benheck/gamebadge3/assets/bud_cu.bmp

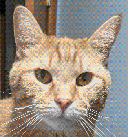
assets/bud_cu.bmp
