benheck/gamebadge3/code/Sample Games/Catskill Game Assets/title screens/cat-teeth.jpg

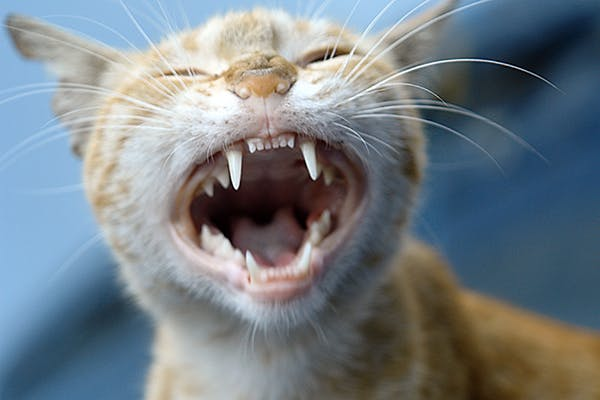
code/Sample Games/Catskill Game Assets/title screens/cat-teeth.jpg
