benheck/gamebadge3/README.md

gamebadge 3 Midwest Gaming Classic workshop project

Some existing Catskill games may not be able to save without a /save folder in the MSD USB root directory, add a "save" folder to enable.

Build procedure:
https://www.youtube.com/watch?v=VSEMkjyJ5Pk
