benheck/gamebadge3/PCB 2026/README.txt

Slight changes based on the 2023 workshop experience
Plan is to have PCBway make these and populate the boring stuff

Have class do audio amp, tact, through hole and PICO
