benheck/gamebadge3/code/Sample Games/Catskill Game Assets/READ ME.txt

Copy the contents of the _flash MSD contents folder to the Pico USB "thumb drive"

See the README.TXT in that folder for more details
