benheck/gamebadge3/code/Sample Games/Catskill Game Assets/_flash MSD contents/READ ME.txt

This folder contains the files/folders that should be placed in the root directory of the Pi Pico's USB "EXT FLASH" when connected to a PC.

Copy the contents of this folder (not the folder itself) into the root directory of the Pi Pico. There should be 10 items in the root of the Pico (9 folders and this README.TXT file)

These files are for the "Catskillvania" game

NES - pattern tables (tiles and sprites)
PAL - RGB palettes that define what colors you can select from
DAT - Palette data
