benheck/gamebadge3/assets/moon force tiles export.bmp

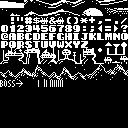
assets/moon force tiles export.bmp
