benheck/gamebadge3/assets/moon force tiles.bmp

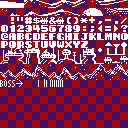
assets/moon force tiles.bmp
