benheck/gamebadge3/code/Sample Games/Catskill Game Assets/condo/condo_0.bmp

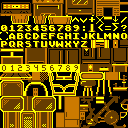
code/Sample Games/Catskill Game Assets/condo/condo_0.bmp
