benheck/gamebadge3/code/Sample Games/Catskill Game Assets/condo/condo_tiles.bmp

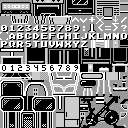
code/Sample Games/Catskill Game Assets/condo/condo_tiles.bmp
