benheck/gamebadge3/code/Sample Games/Catskill Game Assets/condo/condo_tiles_1.bmp

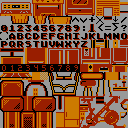
code/Sample Games/Catskill Game Assets/condo/condo_tiles_1.bmp
