benheck/gamebadge3/code/Sample Games/Catskill Game Assets/NES/CHR000.bmp

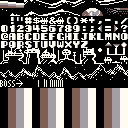
code/Sample Games/Catskill Game Assets/NES/CHR000.bmp
