benheck/gamebadge3/code/Sample Games/Catskill Game Assets/sprites/robots.bmp

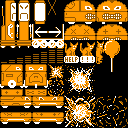
code/Sample Games/Catskill Game Assets/sprites/robots.bmp
