benheck/gamebadge3/code/Sample Games/Catskill Game Assets/sprites/robots.png

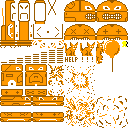
code/Sample Games/Catskill Game Assets/sprites/robots.png
