benheck/gamebadge3/code/Sample Games/Catskill Game Assets/story/bud face.bmp

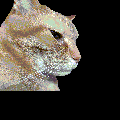
code/Sample Games/Catskill Game Assets/story/bud face.bmp
