benheck/gamebadge3/code/Sample Games/Catskill Game Assets/title screens/CatskillVania Title.bmp

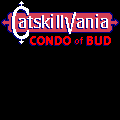
code/Sample Games/Catskill Game Assets/title screens/CatskillVania Title.bmp
