benheck/gamebadge3/code/Sample Games/Catskill Game Assets/title screens/faces.bmp

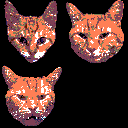
code/Sample Games/Catskill Game Assets/title screens/faces.bmp
