benheck/gamebadge3/code/Sample Games/Grevious/art/grevious-title.png

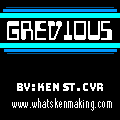
code/Sample Games/Grevious/art/grevious-title.png
