benheck/gamebadge3/code/Sample Games/Grevious/grevious-tileset.bmp

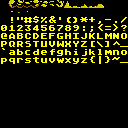
code/Sample Games/Grevious/grevious-tileset.bmp
