benheck/gamebadge3/docs datasheets/power in zMzT6.png

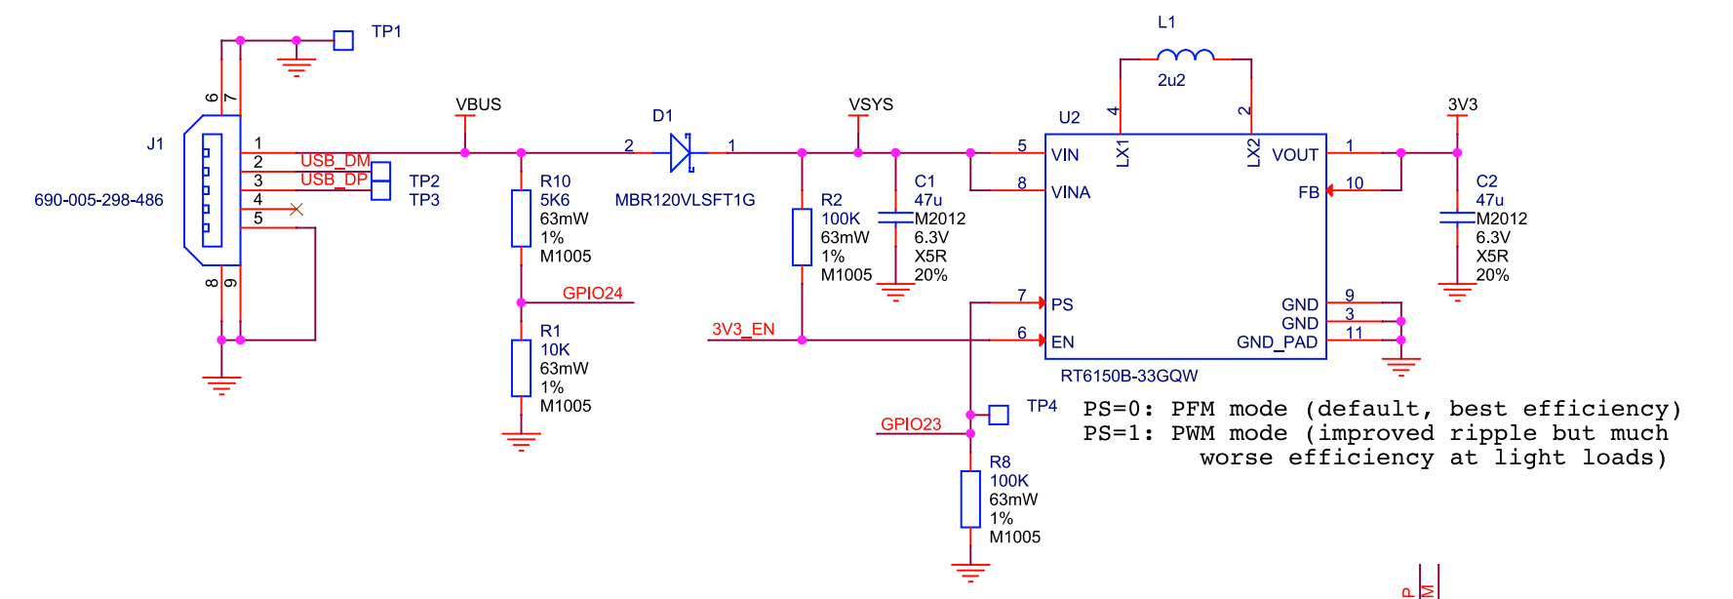
docs datasheets/power in zMzT6.png
