benheck/gamebadge3/PCB 2026/parts lists/Gamebadge3_revB PARTS LIST.txt

Partlist exported from C:/Users/ben/Documents/GitHub/gamebadge3/PCB/Eagle 8.7.1 files/Gamebadge3_revB.sch at 4/4/2023 8:10 PM

Part     Value                 Device                Package                  Description                                                    AVAILABILITY COMMENT   CUI_PURCHASE_URL                                                                                                                            DESCRIPTION                                                                                        EU_ROHS_COMPLIANCE MF                    MP                    PACKAGE             PRICE PURCHASE-URL                                                          
/RST                           PINHD-1X1             1X01                     Pin header 1x1 for 0.1" spacing                                                                                                                                                                                                                                                                                                                                                                                                                                                                     
A        TS04-66-50-BK-100-SMT TS04-66-50-BK-100-SMT SW_TS04-66-50-BK-100-SMT Check availability                                             In Stock               https://www.cuidevices.com/product/switches/tactile-switches/ts04-series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  6 x 6 mm, 4.3~9.5 mm Actuator Height, 100~260 gf, Surface Mount, SPST, Tactile Switch                                CUI Devices           TS04-66-50-BK-100-SMT None                None  https://pricing.snapeda.com/search/part/TS04-66-50-BK-100-SMT/?ref=eda
B        TS04-66-50-BK-100-SMT TS04-66-50-BK-100-SMT SW_TS04-66-50-BK-100-SMT Check availability                                             In Stock               https://www.cuidevices.com/product/switches/tactile-switches/ts04-series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  6 x 6 mm, 4.3~9.5 mm Actuator Height, 100~260 gf, Surface Mount, SPST, Tactile Switch                                CUI Devices           TS04-66-50-BK-100-SMT None                None  https://pricing.snapeda.com/search/part/TS04-66-50-BK-100-SMT/?ref=eda
BATT+                          PINHD-1X1             1X01                     Pin header 1x1 for 0.1" spacing                                                                                                                                                                                                                                                                                                                                                                                                                                                                     
BATT-                          PINHD-1X1             1X01                     Pin header 1x1 for 0.1" spacing                                                                                                                                                                                                                                                                                                                                                                                                                                                                     
C        TS04-66-50-BK-100-SMT TS04-66-50-BK-100-SMT SW_TS04-66-50-BK-100-SMT Check availability                                             In Stock               https://www.cuidevices.com/product/switches/tactile-switches/ts04-series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  6 x 6 mm, 4.3~9.5 mm Actuator Height, 100~260 gf, Surface Mount, SPST, Tactile Switch                                CUI Devices           TS04-66-50-BK-100-SMT None                None  https://pricing.snapeda.com/search/part/TS04-66-50-BK-100-SMT/?ref=eda
C1       1uf                   C-USC0805             C0805                    CAPACITOR, American symbol                                                                                                                                                                                                                                                                                                                                                                                                                                                                          
C2       1uf                   C-USC0805             C0805                    CAPACITOR, American symbol                                                                                                                                                                                                                                                                                                                                                                                                                                                                          
C3       1uf                   C-USC0805             C0805                    CAPACITOR, American symbol                                                                                                                                                                                                                                                                                                                                                                                                                                                                          
C4       1uf                   C-USC0805             C0805                    CAPACITOR, American symbol                                                                                                                                                                                                                                                                                                                                                                                                                                                                          
C5       1uf                   C-USC0805             C0805                    CAPACITOR, American symbol                                                                                                                                                                                                                                                                                                                                                                                                                                                                          
C6       1uf                   C-USC0805             C0805                    CAPACITOR, American symbol                                                                                                                                                                                                                                                                                                                                                                                                                                                                          
C7       1uf                   C-USC0805             C0805                    CAPACITOR, American symbol                                                                                                                                                                                                                                                                                                                                                                                                                                                                          
C8       1uf                   C-USC0805             C0805                    CAPACITOR, American symbol                                                                                                                                                                                                                                                                                                                                                                                                                                                                          
C9       1uf                   C-USC0805             C0805                    CAPACITOR, American symbol                                                                                                                                                                                                                                                                                                                                                                                                                                                                          
DOWN     TS04-66-50-BK-100-SMT TS04-66-50-BK-100-SMT SW_TS04-66-50-BK-100-SMT Check availability                                             In Stock               https://www.cuidevices.com/product/switches/tactile-switches/ts04-series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  6 x 6 mm, 4.3~9.5 mm Actuator Height, 100~260 gf, Surface Mount, SPST, Tactile Switch                                CUI Devices           TS04-66-50-BK-100-SMT None                None  https://pricing.snapeda.com/search/part/TS04-66-50-BK-100-SMT/?ref=eda
GP28                           PINHD-1X1             1X01                     Pin header 1x1 for 0.1" spacing                                                                                                                                                                                                                                                                                                                                                                                                                                                                     
GPIO15                         PINHD-1X1             1X01                     Pin header 1x1 for 0.1" spacing                                                                                                                                                                                                                                                                                                                                                                                                                                                                     
IC1      AZ1117IH-3.3TRG1      AZ1117IH-3.3TRG1      SOT230P700X170-4N        LDO Voltage Regulators LDO BJT HiCurr 1.35A 10Hz to 10KHz      In Stock                                                                                                                                                            Linear Voltage Regulator IC Positive Fixed 1 Output 1A SOT-223-3                                                     Diodes Inc.           AZ1117IH-3.3TRG1      SOT-223 Diodes Inc. None  https://pricing.snapeda.com/search/part/AZ1117IH-3.3TRG1/?ref=eda     
LED1     CHRG                  LED3MM                LED3MM                   LED                                                                                                                                                                                                                                                                                                                                                                                                                                                                                                 
LED2     PWR                   LED3MM                LED3MM                   LED                                                                                                                                                                                                                                                                                                                                                                                                                                                                                                 
LEFT     TS04-66-50-BK-100-SMT TS04-66-50-BK-100-SMT SW_TS04-66-50-BK-100-SMT Check availability                                             In Stock               https://www.cuidevices.com/product/switches/tactile-switches/ts04-series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  6 x 6 mm, 4.3~9.5 mm Actuator Height, 100~260 gf, Surface Mount, SPST, Tactile Switch                                CUI Devices           TS04-66-50-BK-100-SMT None                None  https://pricing.snapeda.com/search/part/TS04-66-50-BK-100-SMT/?ref=eda
R1       2k                    R-US_R0805            R0805                    RESISTOR, American symbol                                                                                                                                                                                                                                                                                                                                                                                                                                                                           
R2       2k                    R-US_R0805            R0805                    RESISTOR, American symbol                                                                                                                                                                                                                                                                                                                                                                                                                                                                           
R3       2k                    R-US_R0805            R0805                    RESISTOR, American symbol                                                                                                                                                                                                                                                                                                                                                                                                                                                                           
R4       20k                   R-US_R0805            R0805                    RESISTOR, American symbol                                                                                                                                                                                                                                                                                                                                                                                                                                                                           
R5       20k                   R-US_R0805            R0805                    RESISTOR, American symbol                                                                                                                                                                                                                                                                                                                                                                                                                                                                           
R6       20k                   R-US_R0805            R0805                    RESISTOR, American symbol                                                                                                                                                                                                                                                                                                                                                                                                                                                                           
R7       2k                    R-US_R0805            R0805                    RESISTOR, American symbol                                                                                                                                                                                                                                                                                                                                                                                                                                                                           
R8       33k                   R-US_R0805            R0805                    RESISTOR, American symbol                                                                                                                                                                                                                                                                                                                                                                                                                                                                           
R9       33k                   R-US_R0805            R0805                    RESISTOR, American symbol                                                                                                                                                                                                                                                                                                                                                                                                                                                                           
R10      33k                   R-US_R0805            R0805                    RESISTOR, American symbol                                                                                                                                                                                                                                                                                                                                                                                                                                                                           
R11      33k                   R-US_R0805            R0805                    RESISTOR, American symbol                                                                                                                                                                                                                                                                                                                                                                                                                                                                           
RESET    TS04-66-50-BK-100-SMT TS04-66-50-BK-100-SMT SW_TS04-66-50-BK-100-SMT Check availability                                             In Stock               https://www.cuidevices.com/product/switches/tactile-switches/ts04-series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  6 x 6 mm, 4.3~9.5 mm Actuator Height, 100~260 gf, Surface Mount, SPST, Tactile Switch                                CUI Devices           TS04-66-50-BK-100-SMT None                None  https://pricing.snapeda.com/search/part/TS04-66-50-BK-100-SMT/?ref=eda
RIGHT    TS04-66-50-BK-100-SMT TS04-66-50-BK-100-SMT SW_TS04-66-50-BK-100-SMT Check availability                                             In Stock               https://www.cuidevices.com/product/switches/tactile-switches/ts04-series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  6 x 6 mm, 4.3~9.5 mm Actuator Height, 100~260 gf, Surface Mount, SPST, Tactile Switch                                CUI Devices           TS04-66-50-BK-100-SMT None                None  https://pricing.snapeda.com/search/part/TS04-66-50-BK-100-SMT/?ref=eda
SELECT   TS04-66-50-BK-100-SMT TS04-66-50-BK-100-SMT SW_TS04-66-50-BK-100-SMT Check availability                                             In Stock               https://www.cuidevices.com/product/switches/tactile-switches/ts04-series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  6 x 6 mm, 4.3~9.5 mm Actuator Height, 100~260 gf, Surface Mount, SPST, Tactile Switch                                CUI Devices           TS04-66-50-BK-100-SMT None                None  https://pricing.snapeda.com/search/part/TS04-66-50-BK-100-SMT/?ref=eda
SERIAL                         PINHD-1X4             1X04                     PIN HEADER                                                                                                                                                                                                                                                                                                                                                                                                                                                                                          
SPEAKER+                       PINHD-1X1             1X01                     Pin header 1x1 for 0.1" spacing                                                                                                                                                                                                                                                                                                                                                                                                                                                                     
SPEAKER-                       PINHD-1X1             1X01                     Pin header 1x1 for 0.1" spacing                                                                                                                                                                                                                                                                                                                                                                                                                                                                     
SPI                            PINHD-1X6             1X06                     PIN HEADER                                                                                                                                                                                                                                                                                                                                                                                                                                                                                          
START    TS04-66-50-BK-100-SMT TS04-66-50-BK-100-SMT SW_TS04-66-50-BK-100-SMT Check availability                                             In Stock               https://www.cuidevices.com/product/switches/tactile-switches/ts04-series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  6 x 6 mm, 4.3~9.5 mm Actuator Height, 100~260 gf, Surface Mount, SPST, Tactile Switch                                CUI Devices           TS04-66-50-BK-100-SMT None                None  https://pricing.snapeda.com/search/part/TS04-66-50-BK-100-SMT/?ref=eda
U$2      GND_CLIP              GND_CLIP              GND_CLIP                                                                                                                                                                                                                                                                                                                                                                                                                                                                                                                     
U$3      GND_CLIP              GND_CLIP              GND_CLIP                                                                                                                                                                                                                                                                                                                                                                                                                                                                                                                     
U$4      GND_CLIP              GND_CLIP              GND_CLIP                                                                                                                                                                                                                                                                                                                                                                                                                                                                                                                     
U$5      GND_CLIP              GND_CLIP              GND_CLIP                                                                                                                                                                                                                                                                                                                                                                                                                                                                                                                     
U$6      1825232-1             1825232-1             1825232-1                Check prices                                                   In Stock     1825232-1                                                                                                                                              Switch Slide ON None ON SPDT Side Slide 0.2A 30VDC 10000Cycle PC Pins Bracket Mount/Through Hole  Compliant          TE Connectivity       1825232-1             None                None  https://pricing.snapeda.com/search/part/1825232-1/?ref=eda            
U$7      ST7789_CS             ST7789_CS             ST7789_WAVE                                                                                                                                                                                                                                                                                                                                                                                                                                                                                                                  
U$8                            RPI_PICO_W            RPI_PICO_W                                                                                                                                                                                                                                                                                                                                                                                                                                                                                                                   
U1       MCP73832T-5ACI/OT     MCP73832T-5ACI/OT     SOT95P300X145-5N         IC, BATT CHARGER, Li-Ion Li-Polymer, 500 mA Check availability In Stock                                                                                                                                                            Charger IC Lithium Ion/Polymer SOT-23-5                                                                              Microchip             MCP73832T-5ACI/OT     SOT-23 Microchip    None  https://pricing.snapeda.com/search/part/MCP73832T-5ACI/OT/?ref=eda    
U2       IS31AP4991A-GRLS2-TR  IS31AP4991A-GRLS2-TR  SOIC127P604X170-8N       Ic Audio Pwr Amp 1.1w 8soic Check availability                 In Stock                                                                                                                                                            Audio Amp Speaker 1-CH Mono 1.4W Class-AB 8-Pin SOP T/R                                                              Lumissil Microsystems IS31AP4991A-GRLS2-TR  None                None  https://pricing.snapeda.com/search/part/IS31AP4991A-GRLS2-TR/?ref=eda 
UP       TS04-66-50-BK-100-SMT TS04-66-50-BK-100-SMT SW_TS04-66-50-BK-100-SMT Check availability                                             In Stock               https://www.cuidevices.com/product/switches/tactile-switches/ts04-series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  6 x 6 mm, 4.3~9.5 mm Actuator Height, 100~260 gf, Surface Mount, SPST, Tactile Switch                                CUI Devices           TS04-66-50-BK-100-SMT None                None  https://pricing.snapeda.com/search/part/TS04-66-50-BK-100-SMT/?ref=eda
