benheck/gamebadge3/PCB 2026/parts lists/MGC Game Badge 2024 - parts list.xlsx

 | MGC Game Badge 2024 |  | 2023-12-29 |  | BJH
GET | Part | PCBWAY POPULATE | Supplier | Supplier Part # | Part # | Qnty | Cost | Sub | Notes: | Notes: | Notes:
done | Pi Pico W |  | Digi-Key |  | 2648-SC0918CT-ND | 1 | $0.00 | $0.00 | Spooky donation
progress | ST7789 LCD |  | Amazon | Waveshare model - collect 40 |  | 1 | $13.27 | $13.27 | https://www.amazon.com/dp/B07MH93747?psc=1&ref=ppx_yo2ov_dt_b_product_details |  | https://www.amazon.com/dp/B07MH93747?psc=1&ref=ppx_yo2ov_dt_b_product_details
done | ACEIRMC Micro SD SDHC TF Card Adapter |  | Amazon |  |  | 1 | $0.88 | $0.88 | https://www.amazon.com/dp/B0B87QQZD3?psc=1&ref=ppx_yo2ov_dt_b_product_details
build? | 3mm M3 screw |  | McMaster |  | https://www.mcmaster.com/92005A111/ | 2 | $0.06 | $0.11
done | Red LED 3mm |  | MPJA.COM |  | 15101 OP | 1 | $0.02 | $0.02 | We already have these, but this is what they cost me
done | Green LED 3mm |  | MPJA.COM |  | 15102 OP | 1 | $0.02 | $0.02 | We already have these, but this is what they cost me
done | SWITCH SLIDE SPDT 200MA 30V |  | Digi-Key |  | ‎A107673-ND‎ | 1 | $0.41 | $0.41 | Same as gamebadge 2
PCBway | 20k resistors | YES |  |  | 738-RMCF0805JG20K0TR-ND | 3 | $0.00 | $0.00
PCBway | 33k resistors | YES |  |  | RMCF0805FT33K0CT-ND | 4 | $0.00 | $0.00
PCBway | 2k resistors | YES |  |  | 13-RC0805FR-132KLTR-ND | 4 | $0.00 | $0.00
 |  |  |  |  |  |  |  | $0.00
 |  |  |  |  |  |  |  | $0.00
done | IC AMP CLASS AB MONO 1.15W 8SOIC |  | Digi-Key |  | 2521-IS31AP4991A-GRLS2-TRCT-ND | 1 | $0.46 | $0.46
done | 8 Ohms General Purpose Speaker 800 mW 300 Hz ~ 8 kHz Top Round |  | Digi-Key |  | 433-1104-ND | 1 | $1.34 | $1.34 | 16mm diameter
done | 6mmx6mm SMT tact switch |  | Digi-Key |  | TS04-66-50-BK-100-SMT | 10 | $0.13 | $1.28 | 100gf switches. Use these for D-pad, use existing switches for other buttons
 |  |  |  |  |  |  |  | $0.00
PCBway | CAP CER 1UF 25V X7R 0805 | YES |  |  | 1276-2926-2-ND | 9 | $0.03 | $0.26
 |  |  |  |  |  |  |  | $0.00
PCBway | IC BATT CNTL LI-ION 1CEL SOT23-5 | YES | LCSC | C14879 | ‎MCP73832T-5ACI/OTCT-ND‎ | 1 | $0.00 | $0.00 | LCSC MCP73831T-2ATI/OT (lower voltage regulator) | Improve heat sinking
order | 3.3 voltage regulator AZ1117IH-3.3TRG1 |  | Digi-Key | AZ1117IH-3.3TRG1DICT-ND | AZ1117IH-3.3TRG1 | 1 | $0.21 | $0.21
order | Lipo battery 380mAH |  | Amazon |  |  | 1 | $3.00 | $3.00 | https://www.amazon.com/gp/product/B08DD5MTKM/ref=ppx_yo_dt_b_search_asin_title?ie=UTF8&psc=1
 |  |  |  |  |  |  |  | $0.00
PCBway | PCB |  | PCBWAY |  |  | 1 | $0.00 | $0.00 | PCBWAY SPONSORSHIP | https://jlcpcb.com/
 |  |  |  |  |  |  |  | $0.00
 |  |  |  |  |  |  |  | $0.00
