benheck/gamebadge3/casing/case 2023 v3/Screen Kit v1.stl

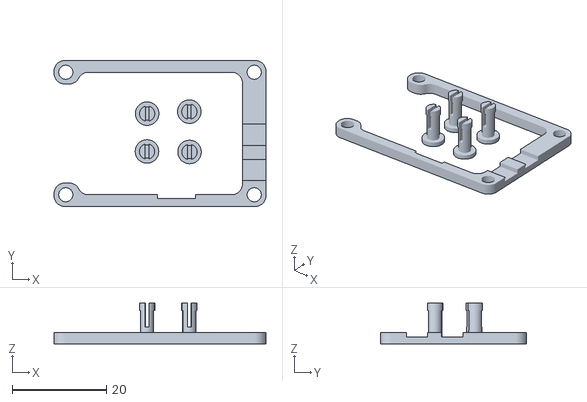
[picture p17: CAD file, 2023-04-05]
casing/case 2023 v3/Screen Kit v1.stl
45.0 x 31.0 x 8.60
