benheck/gamebadge3/casing/case 2023 v3A/Front Case Speaker Front 16mm.stl

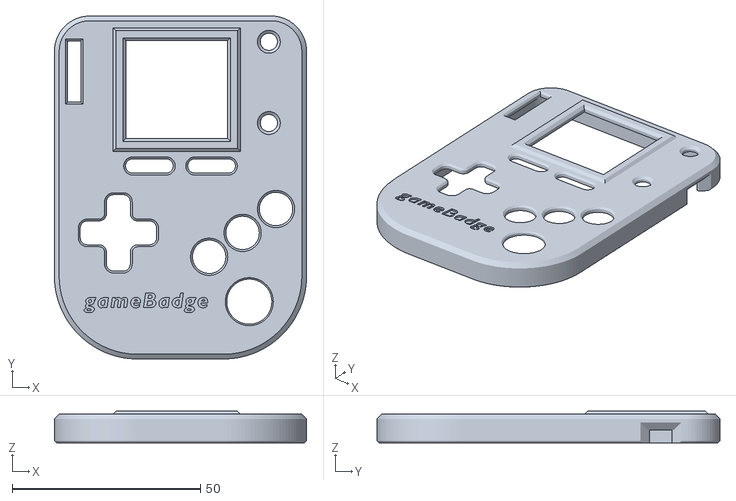
[picture p18: CAD file, 2023-08-27]
casing/case 2023 v3A/Front Case Speaker Front 16mm.stl
67.1 x 91.2 x 8.38
