benheck/gamebadge3/casing/casing 2024 rev 3B - alternate/Rear Case - Alternate.stl

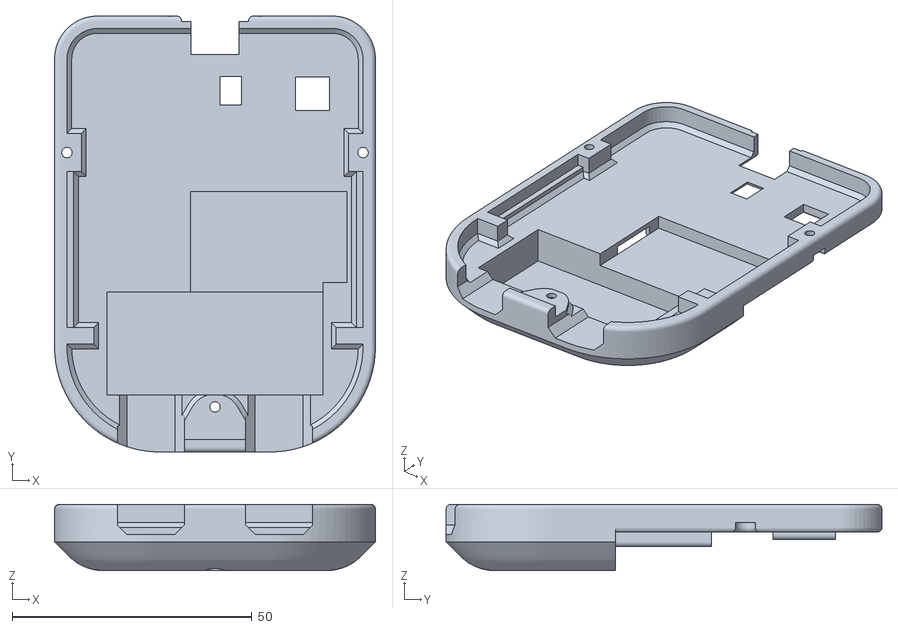
[picture p19: CAD file, 2024-04-05]
casing/casing 2024 rev 3B - alternate/Rear Case - Alternate.stl
67.0 x 91.0 x 13.8
