benheck/gamebadge3/casing/casing 2024 rev 3B/rear buttons.stl

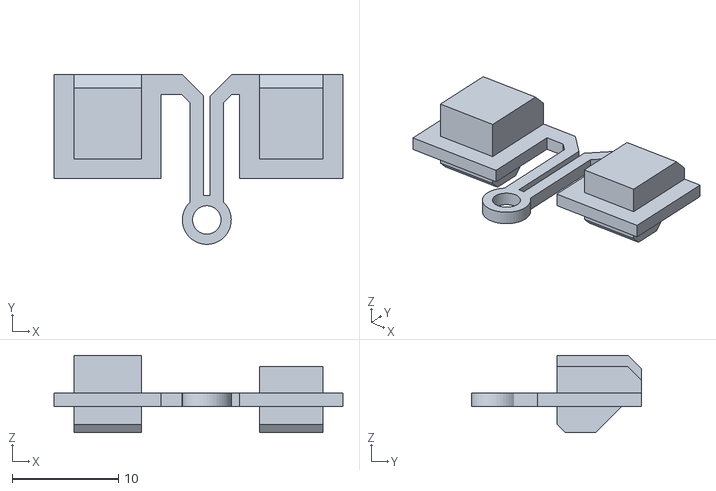
[picture p20: CAD file, 2024-02-28]
casing/casing 2024 rev 3B/rear buttons.stl
27.2 x 16.0 x 7.29
