benheck/gamebadge3/casing/casing 2025 rev 3C - ST7789V3/Gamebadge3_revC.dxf

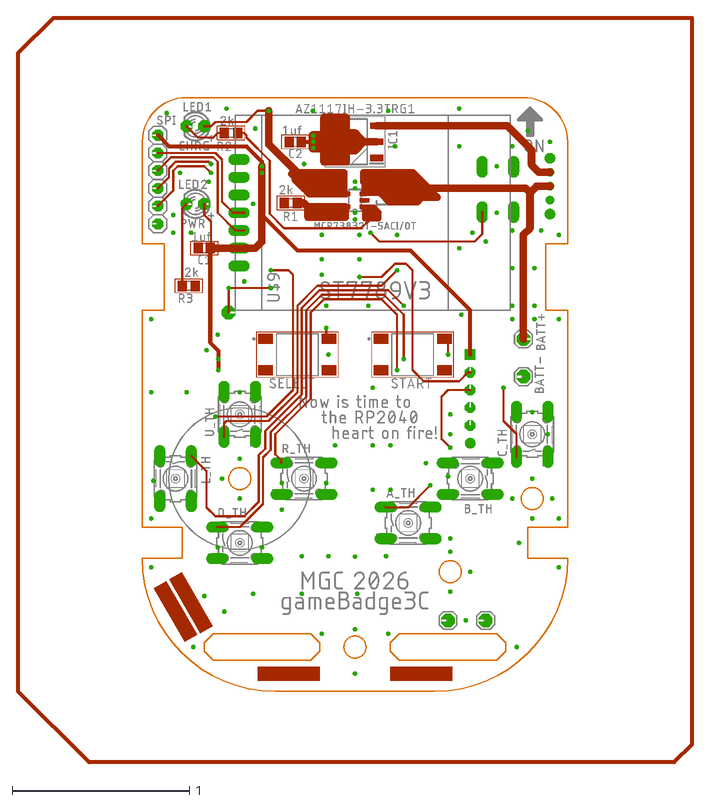
[picture p21: CAD file, 2025-12-30]
casing/casing 2025 rev 3C - ST7789V3/Gamebadge3_revC.dxf
3.82 x 4.22
