benheck/gamebadge3/casing/casing 2025 rev 3C - ST7789V3/STL/GameBadge 3C Screen Bracket.stl

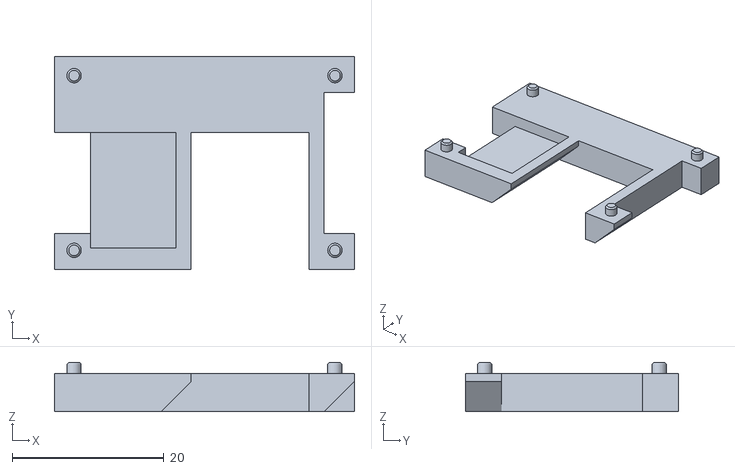
[picture p22: CAD file, 2026-03-24]
casing/casing 2025 rev 3C - ST7789V3/STL/GameBadge 3C Screen Bracket.stl
39.5 x 28.0 x 6.50
