benheck/gamebadge3/docs datasheets/documentation 3B assembly/Gamebadge3_revC rear.dxf

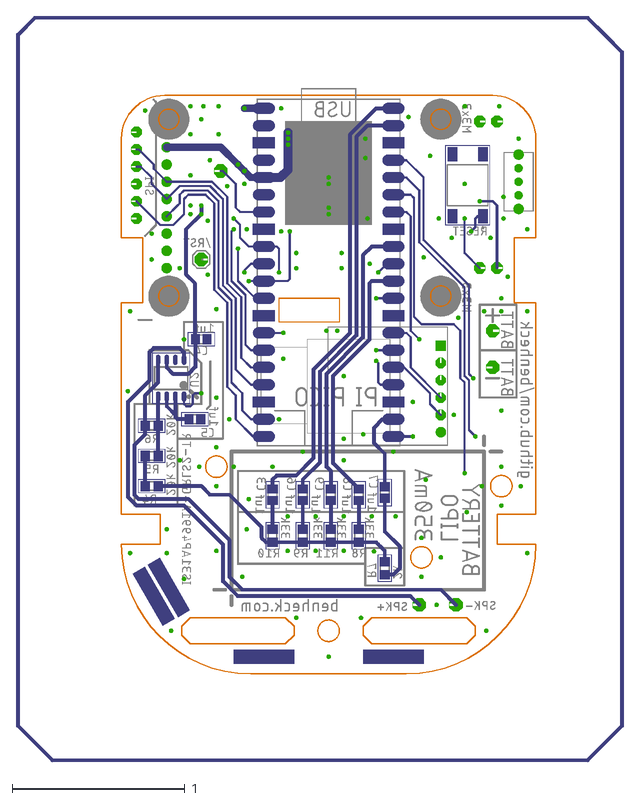
[picture p23: CAD file, 2024-04-05]
docs datasheets/documentation 3B assembly/Gamebadge3_revC rear.dxf
3.52 x 4.32
