benheck/gamebadge3/PCB 2026/diagrams/front.dxf

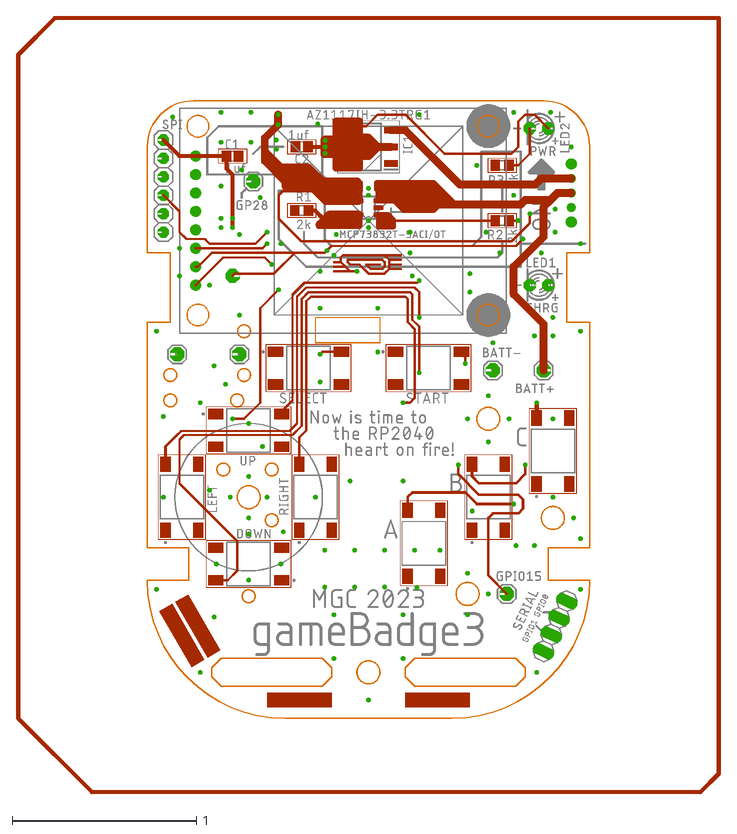
[picture p24: CAD file, 2023-03-27]
PCB 2026/diagrams/front.dxf
3.82 x 4.22
