benheck/gamebadge3/PCB 2026/Eagle 8.7.1 files/Gamebadge3_revD.dxf

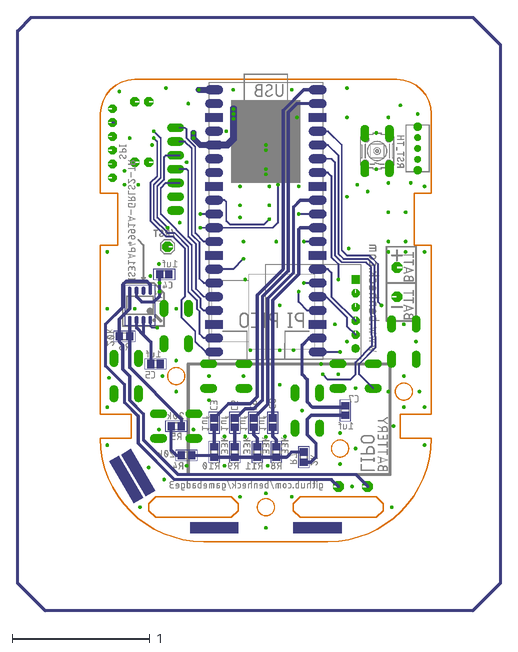
[picture p25: CAD file, 2026-09-08]
PCB 2026/Eagle 8.7.1 files/Gamebadge3_revD.dxf
3.52 x 4.32
