benheck/gamebadge3/casing/case 2023 v3/Buttons.stl

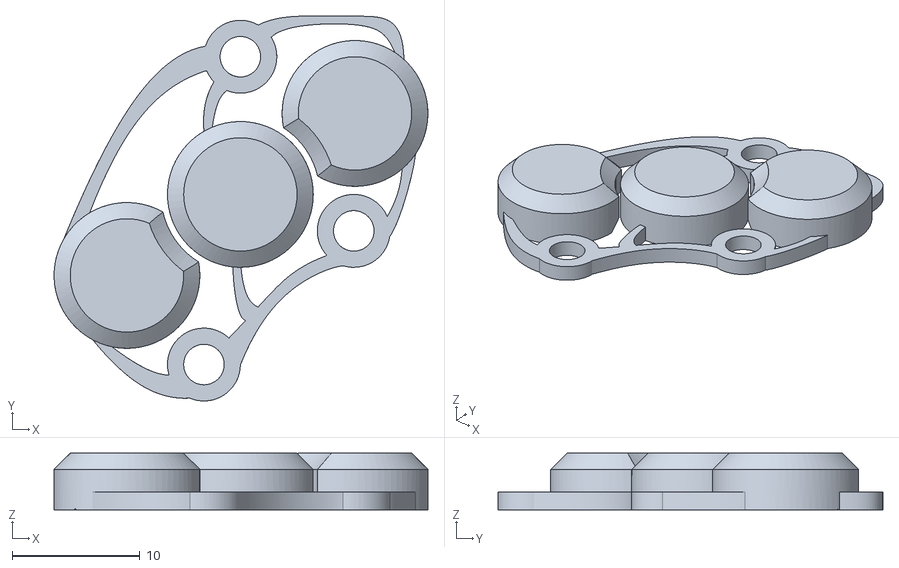
[picture p26: CAD file, 2023-04-05]
casing/case 2023 v3/Buttons.stl
29.3 x 30.2 x 4.45
