benheck/gamebadge3/casing/case 2023 v3A/Rear Case 2.stl

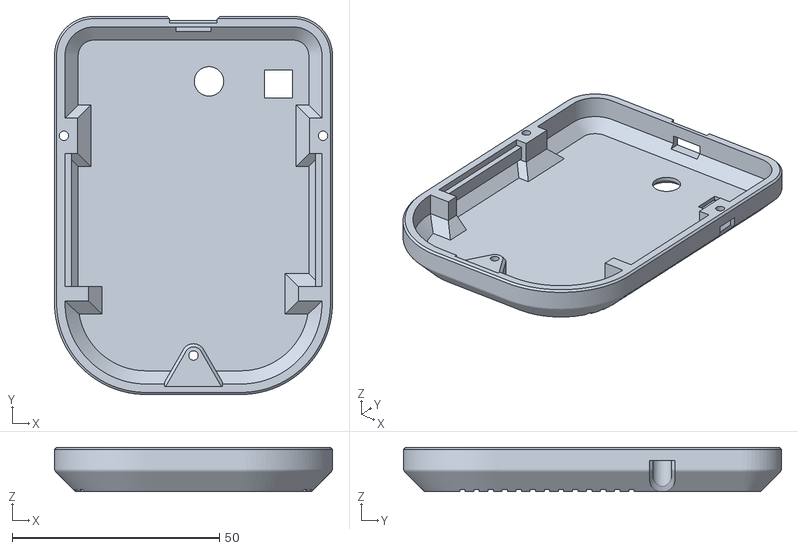
[picture p27: CAD file, 2023-08-12]
casing/case 2023 v3A/Rear Case 2.stl
67.1 x 91.2 x 10.7
