benheck/gamebadge3/casing/casing 2024 rev 3B/Buttons.stl

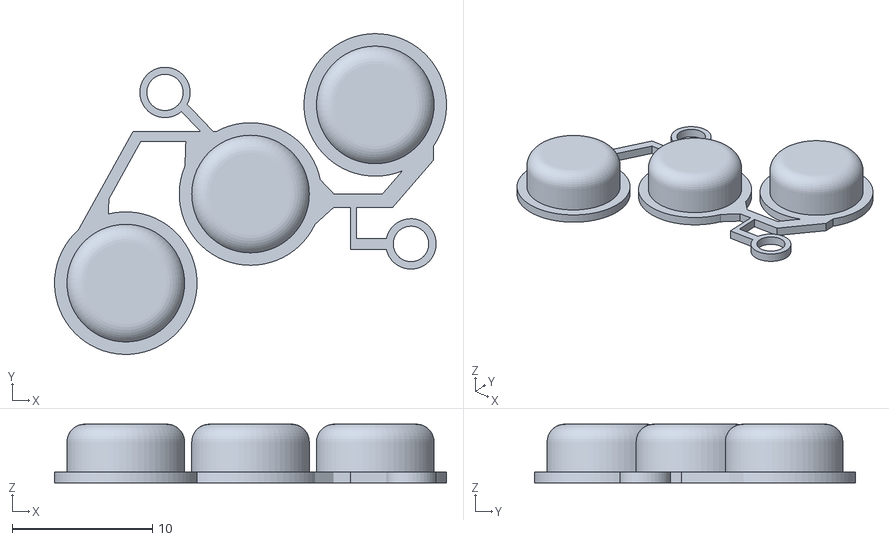
[picture p28: CAD file, 2024-02-28]
casing/casing 2024 rev 3B/Buttons.stl
27.9 x 22.9 x 4.19
