benheck/gamebadge3/casing/casing 2025 rev 3C - ST7789V3/GB 3C ST7789V3 export.dxf

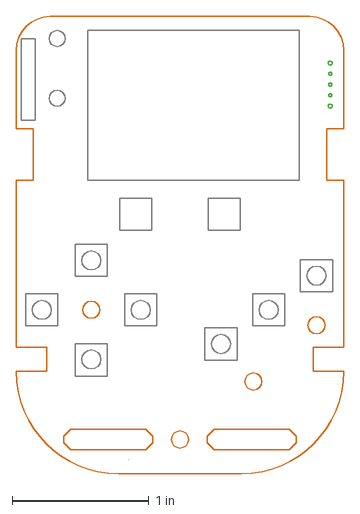
[picture p29: CAD file, 2025-12-30]
casing/casing 2025 rev 3C - ST7789V3/GB 3C ST7789V3 export.dxf
2.40 x 3.35 in
