benheck/gamebadge3/casing/casing 2025 rev 3C - ST7789V3/STL/Rear Case Rev 3.stl

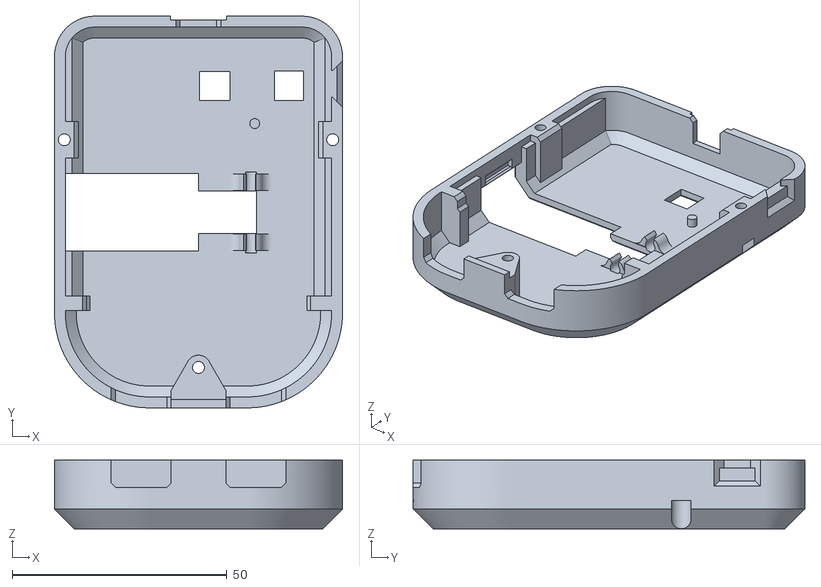
[picture p30: CAD file, 2026-02-15]
casing/casing 2025 rev 3C - ST7789V3/STL/Rear Case Rev 3.stl
67.1 x 91.2 x 16.0
