benheck/gamebadge3/docs datasheets/documentation 3B assembly/Gamebadge3_revC.dxf

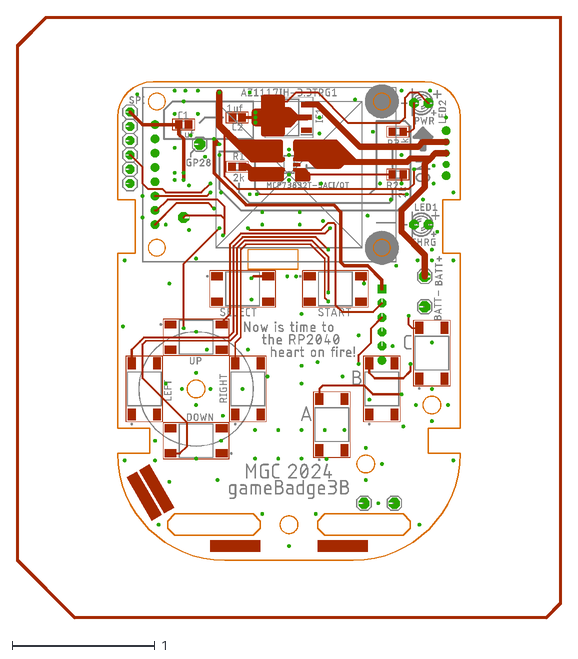
[picture p31: CAD file, 2024-04-05]
docs datasheets/documentation 3B assembly/Gamebadge3_revC.dxf
3.82 x 4.22
