benheck/gamebadge3/PCB 2026/Eagle 8.7.1 files/Gamebadge3_revD front.dxf

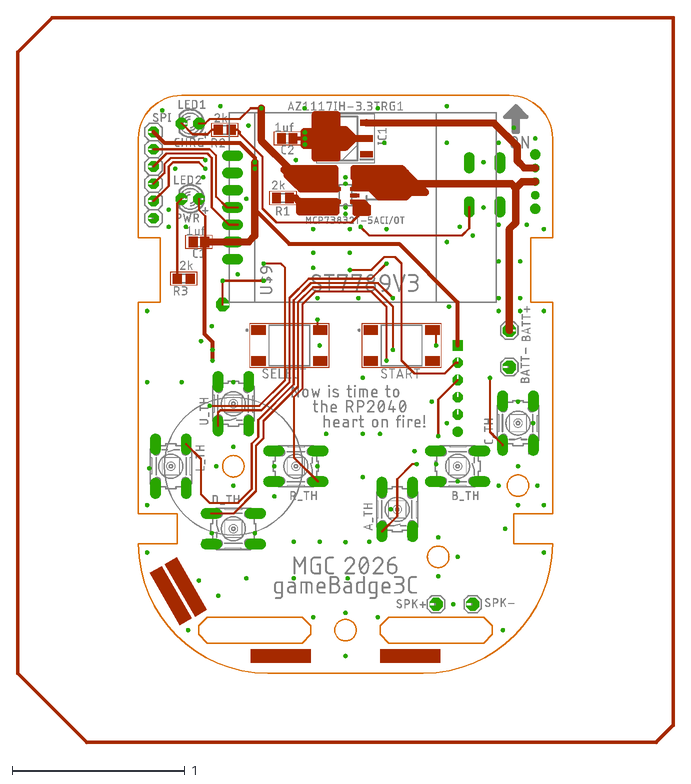
[picture p32: CAD file, 2026-09-08]
PCB 2026/Eagle 8.7.1 files/Gamebadge3_revD front.dxf
3.82 x 4.22
