benheck/gamebadge3/casing/case 2023 v3/Button Mount Post x3.stl

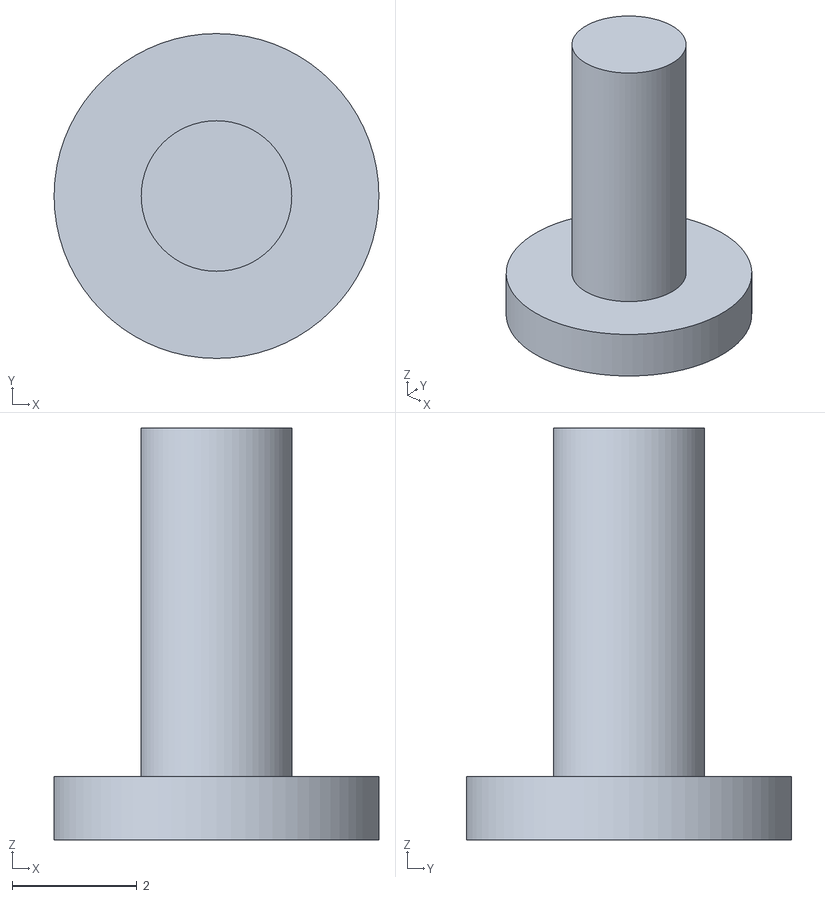
[picture p33: CAD file, 2023-04-05]
casing/case 2023 v3/Button Mount Post x3.stl
5.21 x 5.21 x 6.60
