benheck/gamebadge3/casing/case 2023 v3A/D-pad 2.stl

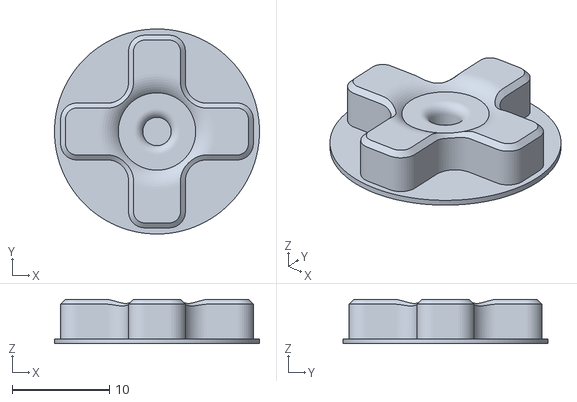
[picture p34: CAD file, 2023-08-12]
casing/case 2023 v3A/D-pad 2.stl
21.1 x 21.1 x 4.57
