benheck/gamebadge3/casing/casing 2024 rev 3B/SD door Rev 2.stl

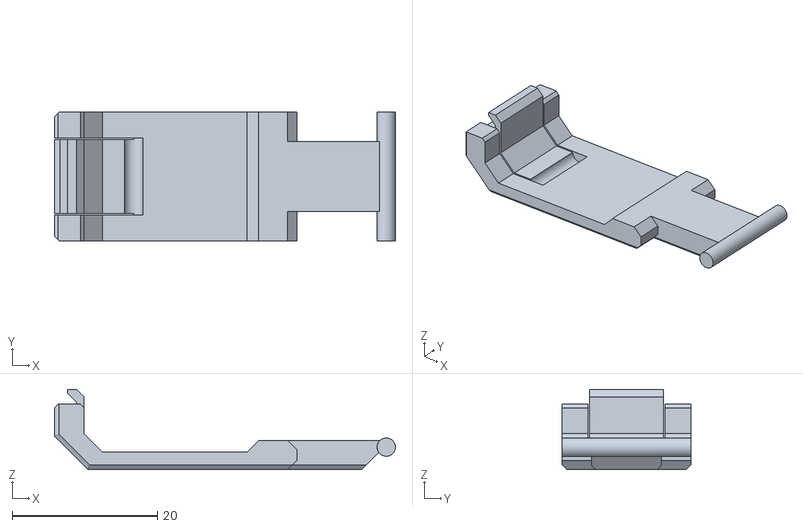
[picture p35: CAD file, 2024-02-28]
casing/casing 2024 rev 3B/SD door Rev 2.stl
47.0 x 17.8 x 11.0
