benheck/gamebadge3/PCB 2026/Eagle 8.7.1 files/logo.dxf

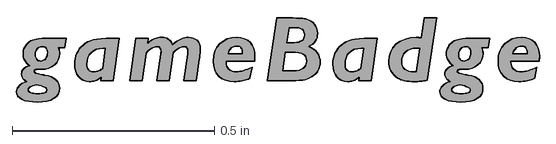
[picture p37: CAD file, 2023-08-27]
PCB 2026/Eagle 8.7.1 files/logo.dxf
1.29 x 0.208 in
