benheck/gamebadge3/casing/case 2023 v3/D-pad interface.stl

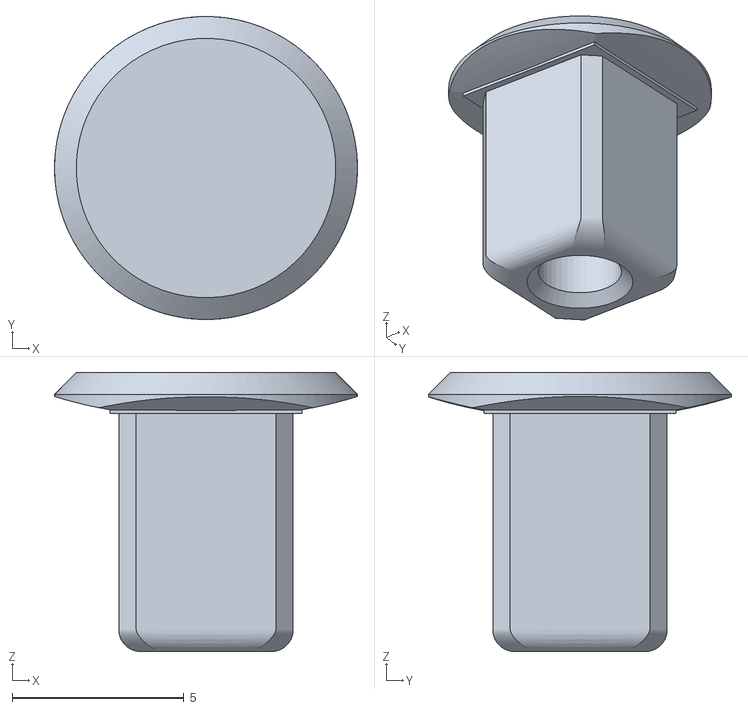
[picture p38: CAD file, 2023-02-15]
casing/case 2023 v3/D-pad interface.stl
8.82 x 8.82 x 8.13
