benheck/gamebadge3/casing/case 2023 v3A/plug.stl

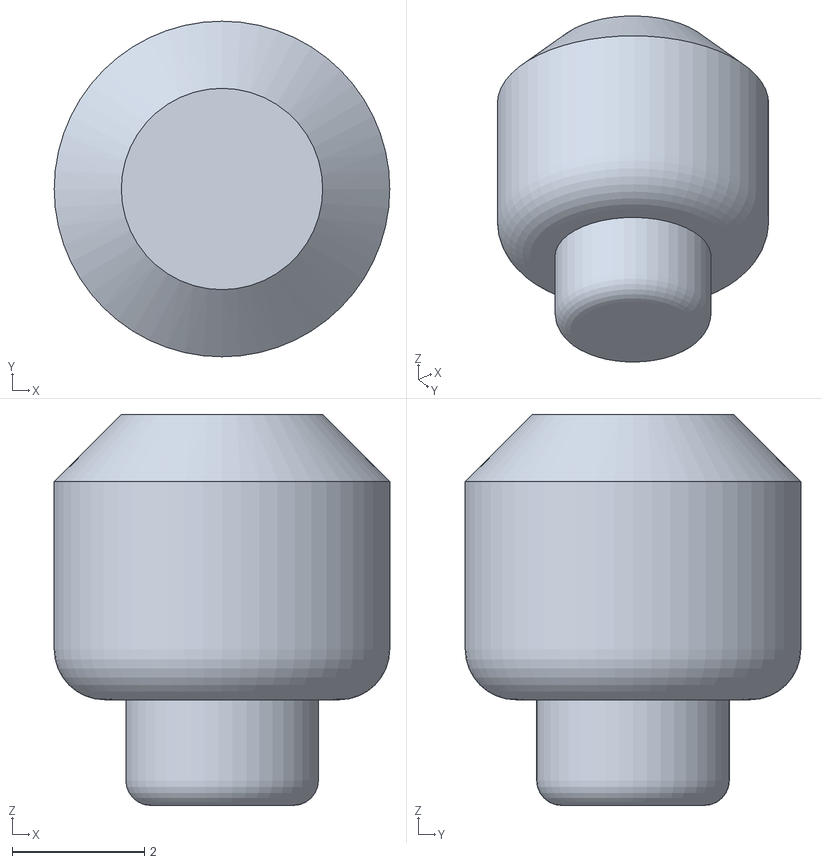
[picture p39: CAD file, 2023-08-11]
casing/case 2023 v3A/plug.stl
5.08 x 5.08 x 5.92
