benheck/gamebadge3/casing/casing 2024 rev 3B/Rear Case Rev 2.stl

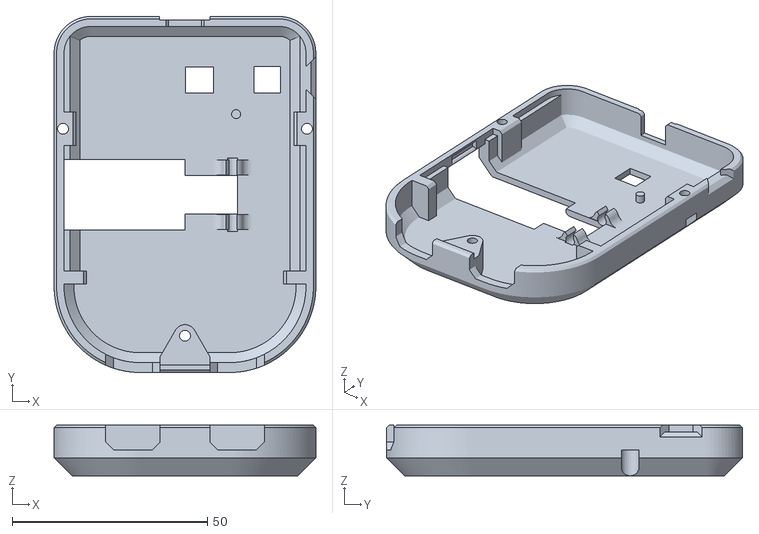
[picture p40: CAD file, 2024-02-28]
casing/casing 2024 rev 3B/Rear Case Rev 2.stl
67.1 x 91.2 x 13.0
