benheck/gamebadge3/casing/casing 2025 rev 3C - ST7789V3/STL/D-pad plug.stl

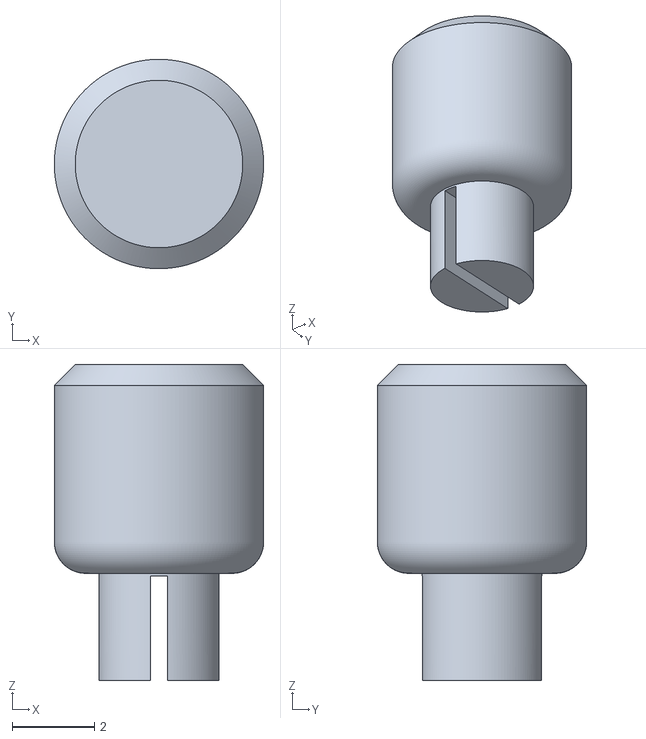
[picture p41: CAD file, 2025-12-30]
casing/casing 2025 rev 3C - ST7789V3/STL/D-pad plug.stl
5.08 x 5.08 x 7.67
