benheck/gamebadge3/casing/case 2023 v3/Case Rear.stl

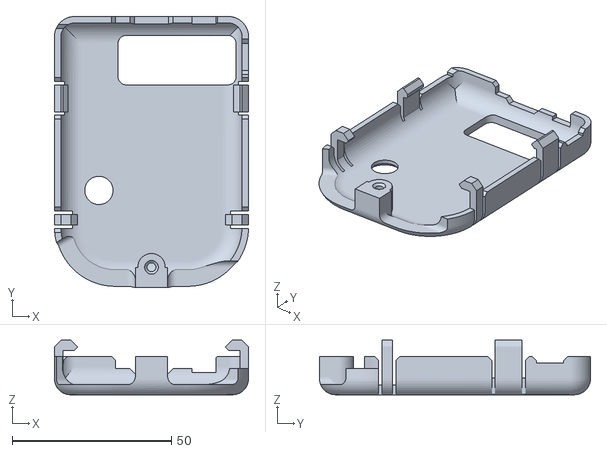
[picture p42: CAD file, 2023-02-15]
casing/case 2023 v3/Case Rear.stl
61.0 x 85.1 x 17.1
