benheck/gamebadge3/casing/case 2023 v3A/D-pad.stl

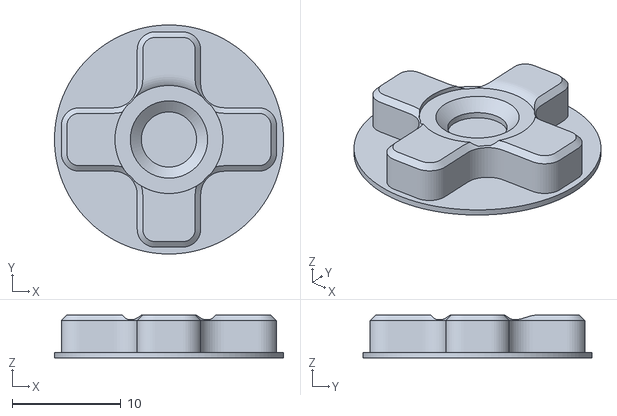
[picture p43: CAD file, 2023-08-11]
casing/case 2023 v3A/D-pad.stl
21.1 x 21.1 x 3.94
