benheck/gamebadge3/casing/casing 2024 rev 3B/face export.dxf

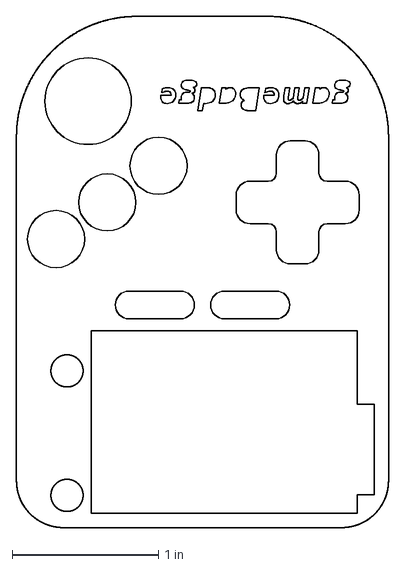
[picture p44: CAD file, 2024-02-28]
casing/casing 2024 rev 3B/face export.dxf
2.54 x 3.49 in
