benheck/gamebadge3/casing/casing 2025 rev 3C - ST7789V3/STL/Rear buttons Rev 3.stl

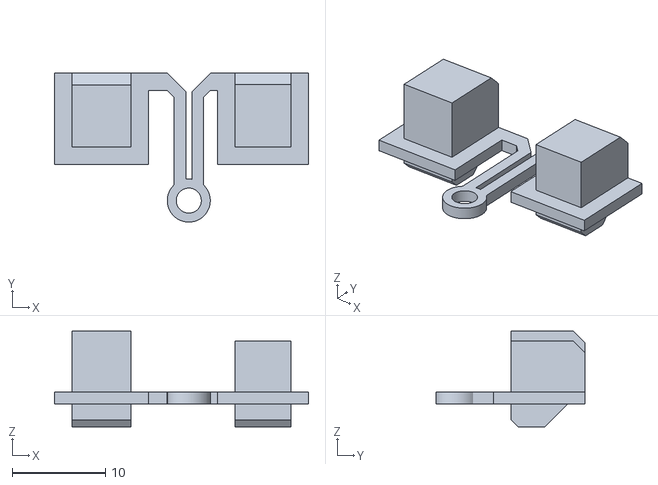
[picture p45: CAD file, 2025-12-30]
casing/casing 2025 rev 3C - ST7789V3/STL/Rear buttons Rev 3.stl
27.2 x 16.0 x 10.3
