benheck/gamebadge3/casing/case 2023 v3/D-pad base.stl

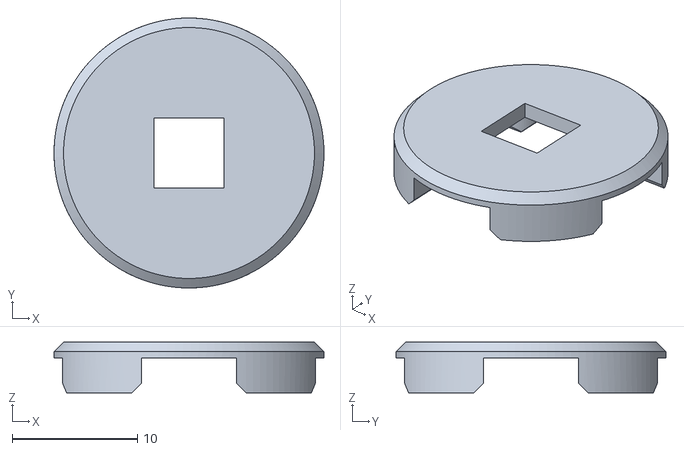
[picture p46: CAD file, 2023-02-15]
casing/case 2023 v3/D-pad base.stl
21.6 x 21.6 x 4.06
