benheck/gamebadge3/casing/case 2023 v3A/Select.stl

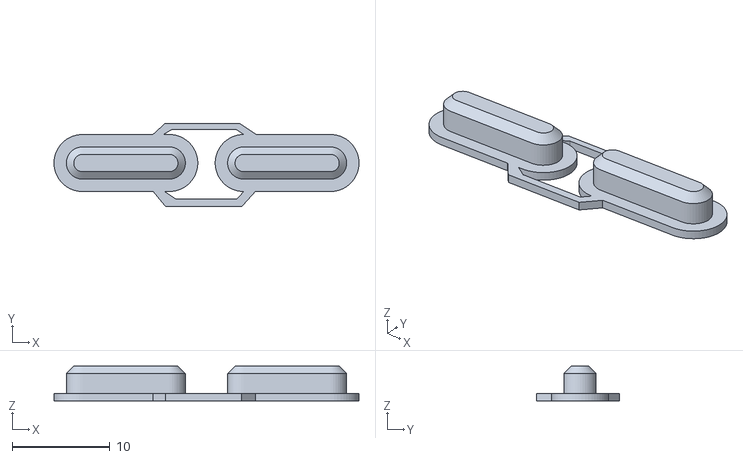
[picture p47: CAD file, 2023-08-11]
casing/case 2023 v3A/Select.stl
31.2 x 8.52 x 3.56
