benheck/gamebadge3/casing/casing 2024 rev 3B/Select Start.stl

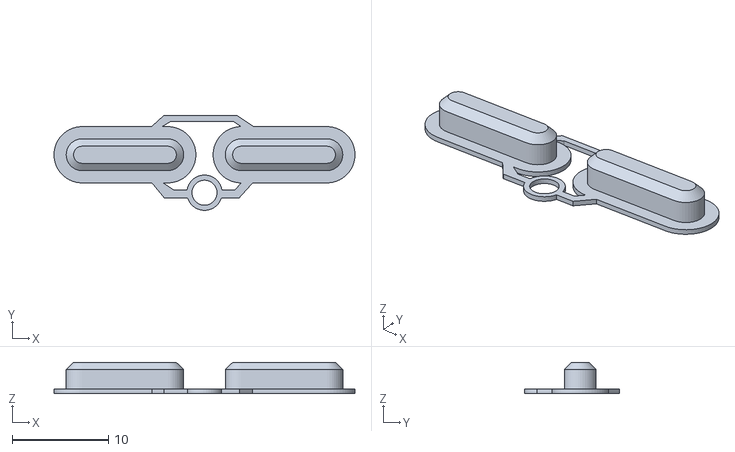
[picture p48: CAD file, 2024-02-28]
casing/casing 2024 rev 3B/Select Start.stl
31.2 x 9.83 x 3.26
