benheck/gamebadge3/casing/case 2023 v3/D-pad top.stl

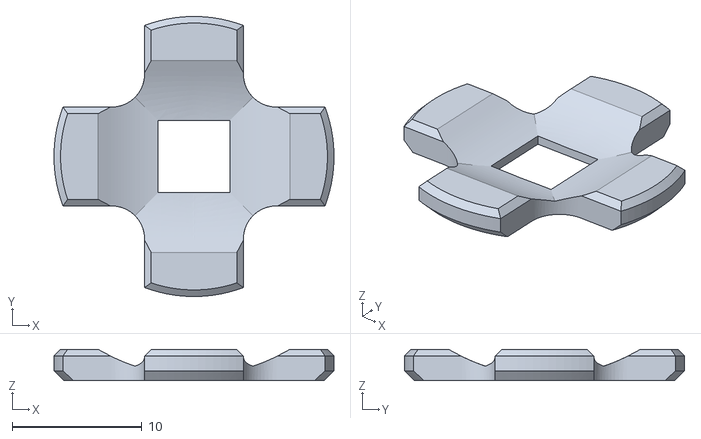
[picture p49: CAD file, 2023-02-15]
casing/case 2023 v3/D-pad top.stl
21.6 x 21.6 x 2.41
