benheck/gamebadge3/casing/case 2023 v3A/Buttons.stl

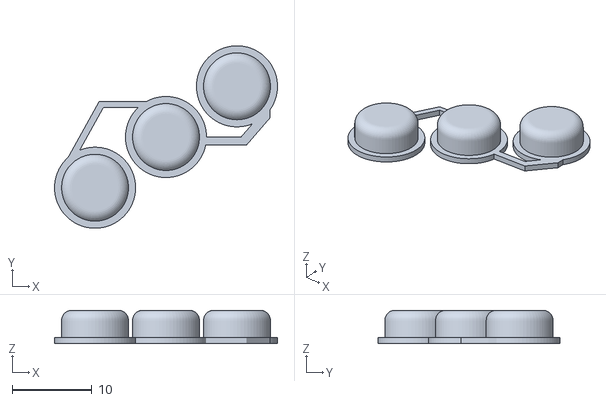
[picture p50: CAD file, 2023-08-11]
casing/case 2023 v3A/Buttons.stl
27.9 x 22.9 x 4.19
