benheck/gamebadge3/casing/casing 2024 rev 3B/Front Case Rev 2.stl

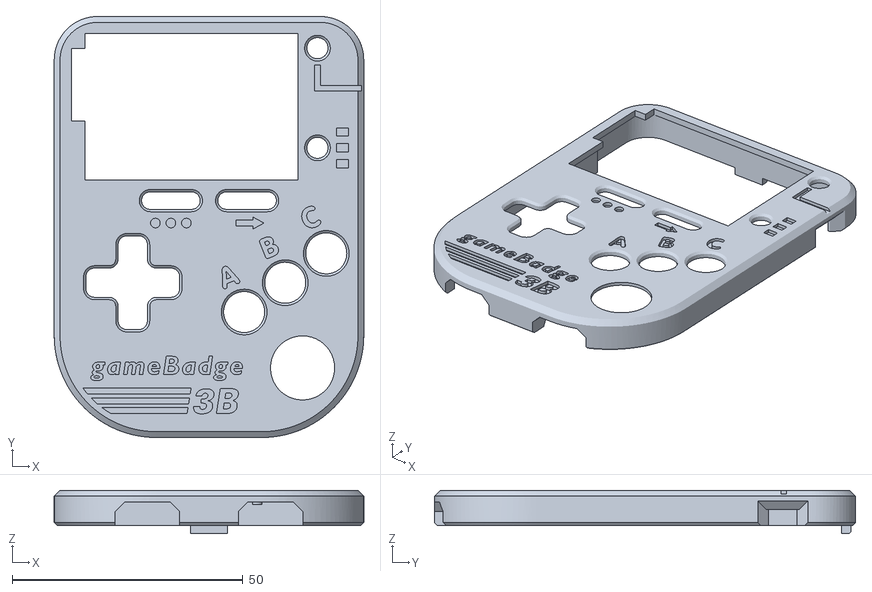
[picture p51: CAD file, 2024-02-28]
casing/casing 2024 rev 3B/Front Case Rev 2.stl
67.1 x 91.2 x 9.41
