benheck/gamebadge3/casing/casing 2025 rev 3C - ST7789V3/STL/Select Start Rev 3.stl

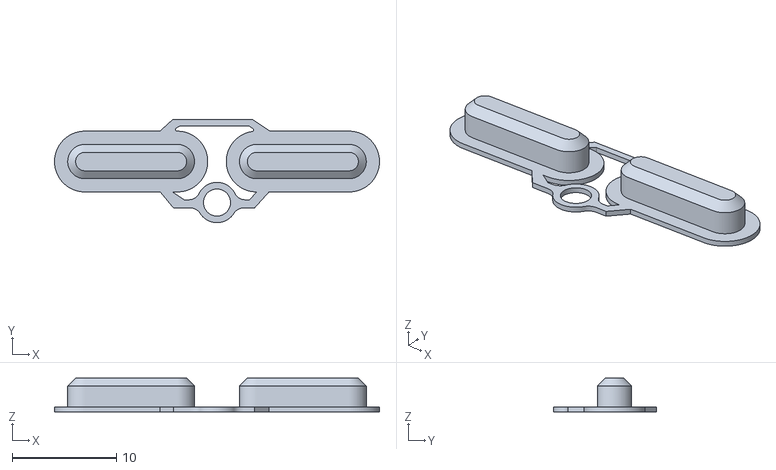
[picture p52: CAD file, 2025-12-30]
casing/casing 2025 rev 3C - ST7789V3/STL/Select Start Rev 3.stl
31.2 x 9.93 x 3.26
