benheck/gamebadge3/casing/case 2023 v3A/Front Case.stl

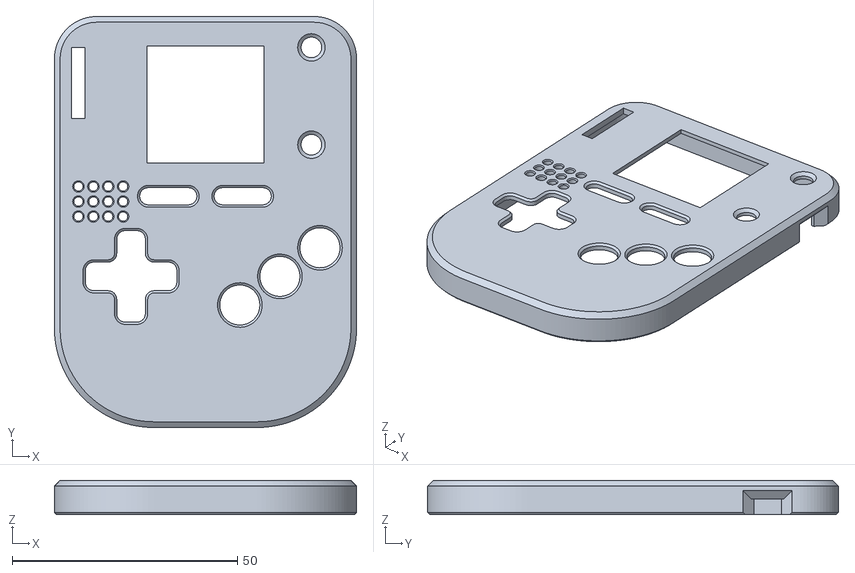
[picture p53: CAD file, 2023-08-11]
casing/case 2023 v3A/Front Case.stl
67.1 x 91.2 x 7.62
