benheck/gamebadge3/casing/case 2023 v3A/Prog button.stl

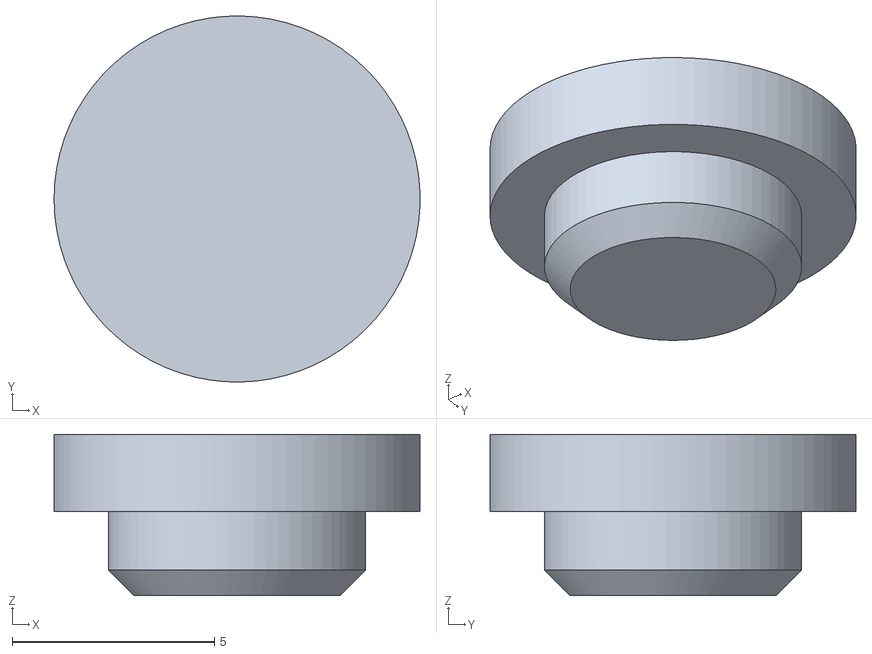
[picture p54: CAD file, 2023-08-11]
casing/case 2023 v3A/Prog button.stl
9.04 x 9.04 x 3.99
