benheck/gamebadge3/casing/casing 2025 rev 3C - ST7789V3/STL/SD door Rev 3.stl

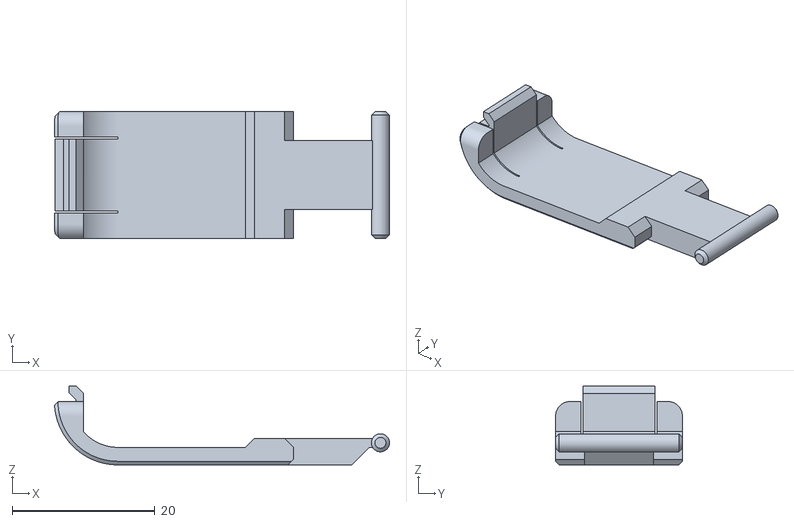
[picture p55: CAD file, 2025-12-30]
casing/casing 2025 rev 3C - ST7789V3/STL/SD door Rev 3.stl
47.0 x 17.8 x 11.0
