benheck/gamebadge3/casing/case 2023 v3A/RST button.stl

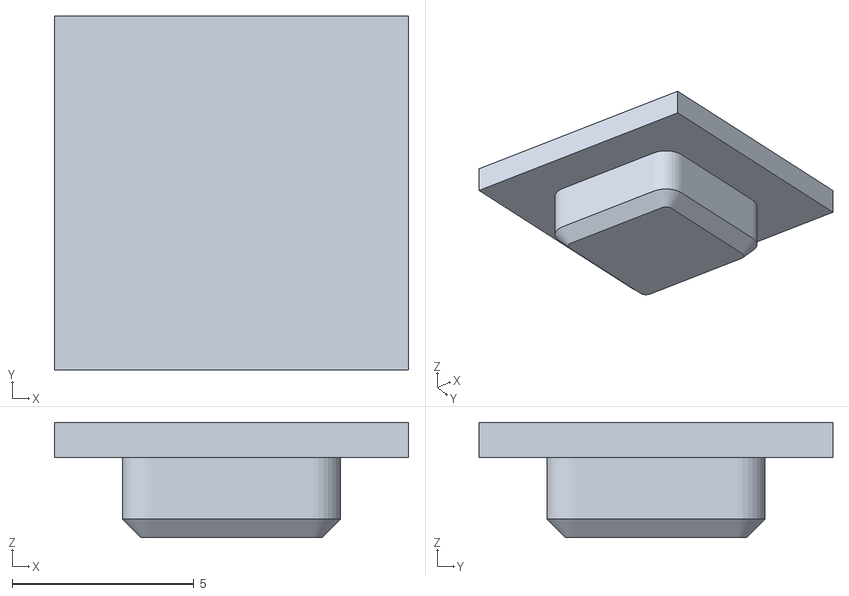
[picture p56: CAD file, 2023-08-11]
casing/case 2023 v3A/RST button.stl
9.74 x 9.74 x 3.18
