benheck/gamebadge3/casing/casing 2024 rev 3B/face import.dxf

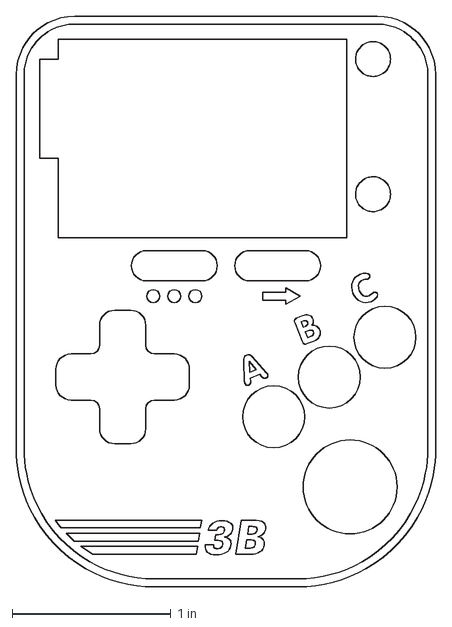
[picture p57: CAD file, 2024-02-28]
casing/casing 2024 rev 3B/face import.dxf
2.64 x 3.59 in
