benheck/gamebadge3/casing/case 2023 v3A/Rear Case.stl

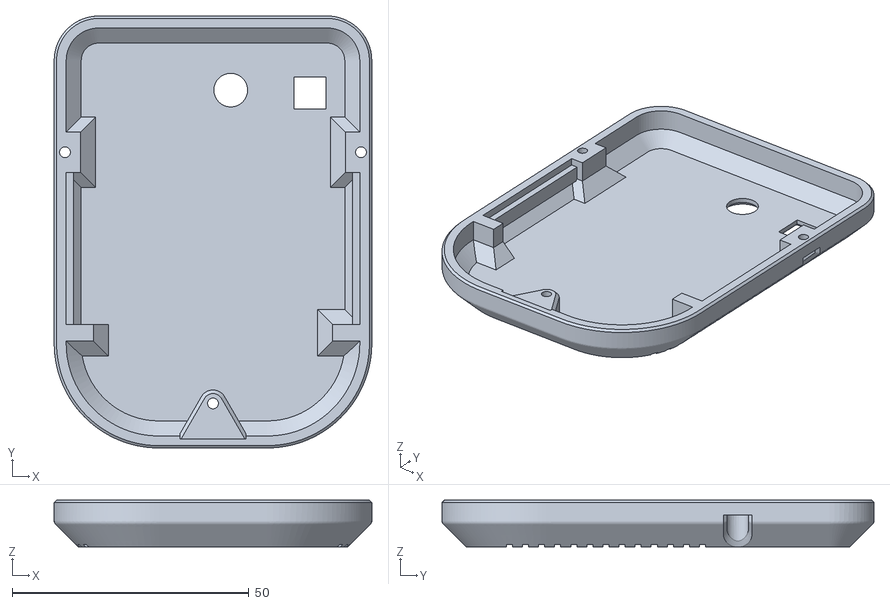
[picture p58: CAD file, 2023-08-07]
casing/case 2023 v3A/Rear Case.stl
67.1 x 91.2 x 9.91
