benheck/gamebadge3/(list of files, cad)

Other CAD files:
casing/casing 2025 rev 3C - ST7789V3/STL/D-pad Rev 3.stl
casing/casing 2024 rev 3B/D-pad 2.stl
casing/casing 2025 rev 3C - ST7789V3/STL/ABC buttons Rev 3.stl
casing/casing 2024 rev 3B/D-post.stl
