benheck/gamebadge3/code/utilities and test code/flash nuke/README.txt

If you are having problems with the flash:

1) Hold BOOT button while resetting
2) Drag the flash_nuke.uf2 onto the UF2 drive
3) Wait for reboot (device reappears)

4) Restart Adafruit flash format, game installation, etc
