benheck/gamebadge3/(threads)

Thread 1 (2023-01-09):

Custom palettes are not being used

kenstcyr, 2023-01-09:
When importing a custom palette (.dat file), the custom palette isn't used. Looking through the code in gameBadgePico.cpp, line 210 is using a hard coded palette file name:

` file.open("palette_0.dat", O_RDONLY);`

This needs to be switched over to a variable

kenstcyr, 2023-01-09:
Resolved in commit 1398ab1

Closed 2023-01-09.

Thread 3 (2024-02-05):

Screen goes black

theflynn49, 2024-02-05:
Sometimes, the screen goes totally black, until reboot while playing Catskillvania.

- it's probably not a hardware problem because it happens to my two boards, even if I switch screens
- it happens only during transitions condo<->hallway or menu->hallway
- sometimes instead of totally black it turns blueish, indicating a probable screen failure due to comm errors

this patch fixes the problem
file Catskill.ino
line 377 is
 	nextFrameFlag -= 2;
should/be
	nextFrameFlag = 0 ;

- I don't provide a PR because I have no idea why this fixes the problem. To my understanding, this only avoids successive continuous frames to be sent to the screen whenever there is a contention. I am not totally satisfied by this explanation.

Nevertheless this may help some poor soul having the same problem.

note : symptom looks like if you program your pico at 133Mhz; SPI clock goes berserk and screen goes black very often. I made this mistake too.

benheck, 2024-02-05:
Yeah you have to run it at 125MHz which is an Arduino/IDE/programming
setting.

Reason is the SPI bus is CPU/2 = 62.5Mhz If you go higher (133/2 = 66.5)
you exceed the ST7789 LCD input speed (which tops out around 63MHz)

-Ben

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

--
Benjamin J Heckendorn
www.benheck.com

theflynn49, 2024-02-05:
@benheck : thank you for your answer !

Nevertheless, I failed to be completely clear : despite running at 125Mhz, it still fails once a minute or so.

I tried a zillion things, but to fix this the only thing I found is to reset nextFrameFlag to 0 line 377 of Catskill.ino

jF

benheck, 2024-02-05:
Weird. Here's the most disappointing thing one can say in coding: I haven't
had that happen on any of mine.

Are you using a Waveshare ST7789? I've had issues with brands other than
that. I need to fork it as that model is getting hard to find.

-Ben

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

--
Benjamin J Heckendorn
www.benheck.com

theflynn49, 2024-02-05:
Thanks again for your help.

I am using Waveshare's ST7789 1.3 inches from Amazon (France), and I even tested with 2.0 inches models since I ordered the wrong type at first. Same symptoms with all screens.

Maybe I am using a different version of compiler, or so, and it generates something a little too slow. May I try the exact same uf2 file you are using to discard this hypothesis ?

On another hand, the problem always happen during condo<->hallway transitions, or menu -> hallway, and never ever at some other time, which seems to imply that the external flash operation collides somehow with something, and that it is not hardware related.

jF

theflynn49, 2024-02-06:
Hello again. I've been working on this lately, and the following scope capture might well be where the problem is. The trigger is (magically) set to show exactly when the screen freezes.
Yellow = SPI clock (screen) Blue = DC to screen
The yellow block is slightly shorter than the normal ones (as I see on other captures) 15.8ms instead of 16.4ms which seems to indicate that the transfer was somehow aborted.
Why would DC go low before the end of the previous block ??
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
This capture is made with your version of Catskill.ino. With the "nextFrameFlag = 0" patch, there is no more block collision.

theflynn49, 2024-02-07:
@benheck : Hello ; I am confident I finally nailed it, I made a PR for this, I hope you like it.
My Best.

benheck, 2024-02-07:
Were you making a custom game? I'm not sure I ever ran into this on Bud
Game.

You just adding DMA command blocking right? It's been a year so I of course
forgot EVERYTHING about this code :)

-Ben

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

--
Benjamin J Heckendorn
www.benheck.com

theflynn49, 2024-02-07:
No no new game unfortunately :D  I was testing on Bud Game; but this issue is time-related and I am convinced that my batch of screens are more sensible to aborted frames, because these aborted frame are systematic in the transitions hallway<->condo, but don't necessarily lead to a black screen.

Anyway, the bug is obvious once you get in the logic there.
Thank you for the PR, feels good, and for the Bud Game which is really fun to play  :D

benheck, 2024-02-09:
Probably right. The screens do vary. That's why I used Waveshare because I
know they work.

-Ben

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

--
Benjamin J Heckendorn
www.benheck.com

theflynn49, 2024-02-25:
Hi Ben !

I just found another nasty bug involving this issue, so I reopen it.

In state 0 or 1 of LCDlogic() in gameBadgePico.cpp, I wait for the previous DMA cycle to be completed, but I also MUST wait for the SPI to be quiescent to go on with the next cycle, because the first thing it's going to do is toggling the screen's DC signal while the SPI is still sending its data is the timing is playing with us.

Note that in state3, you don't have to do that, because the DMA is handling the SPI correctly while the screen stays in DATA mode.

I can make a PR for this if you want, let me know, or you can take the version in my fork.

Rgds
jF

benheck, 2024-02-25:
If this doesn't affect existing games make a PR.

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

--
Benjamin J Heckendorn
www.benheck.com

kenstcyr, 2024-03-02:
@theflynn49 thanks for jumping in! Quick question for you - which version of the gameBadge are you using, 3 or 3B?

theflynn49, 2024-03-02:
@kenstcyr Hi there. I use both. Both work well.

theflynn49, 2024-03-02:
@kenstcyr ... After re-reading this, I think you want to know with what version I experienced these screen problems ... I was using mainly the version 3.

Closed 2024-02-07.

Thread 5 (2024-02-10):

The JLBPCB file in 2024 directory is still the 2023 one.

theflynn49, 2024-02-10:
The JLBPCB zip file in "PCB 2024/Gerber Files/JLCPCB" directory is still the 2023 one.

That's the ones I ordered, so I know :D

Also, I didn't see the card reader in the parts list ... but I might be too early ?

My best,
jF

benheck, 2024-02-10:
Shit yeah, I used pcbway this time. Sorry about that.

My excuse is um, I've been really busy with pinball.

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

theflynn49, 2024-02-10:
lol ... pinball = immediate redemption.

benheck, 2024-02-10:
But yeah, this year I used PCBway so in the folder I obviously copy pasted,
JCLPCB is last year.

Sorry about that! But yeah, pinball, they lobbed 1.5 months off my schedule
so it's been a bitch

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

--
Benjamin J Heckendorn
www.benheck.com
