benheck/gamebadge3/PCB 2026/diagrams/gb3_back.pdf

# GAMEBADGE3C BACK

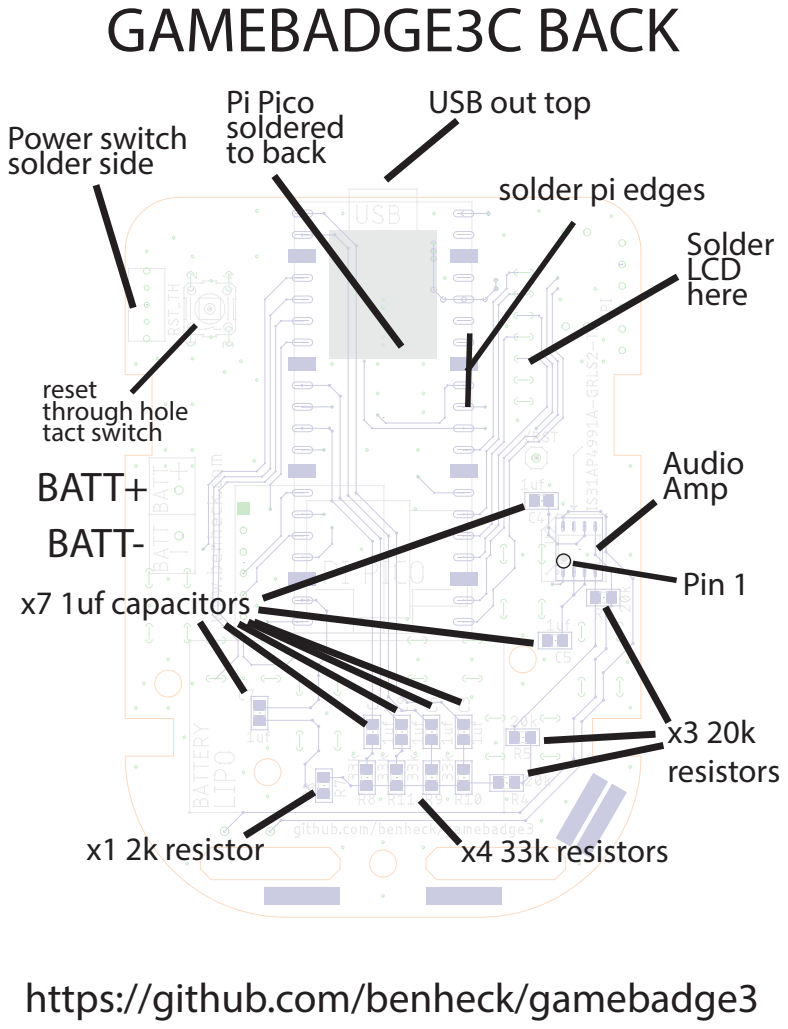
[picture p59: page 1]
x7 1uf capacitors; Audio Amp; Pi Pico soldered to back; Solder LCD here; Power switch solder side; Pin 1; x4 33k resistors; x3 20k resistors; x1 2k resistor; reset through hole tact switch BATT+ BATT-

USB out top

solder pi edges

https://github.com/benheck/gamebadge3
