benheck/gamebadge3/PCB 2026/diagrams/gb3_front.pdf

## GAMEBADGE3C FRONT

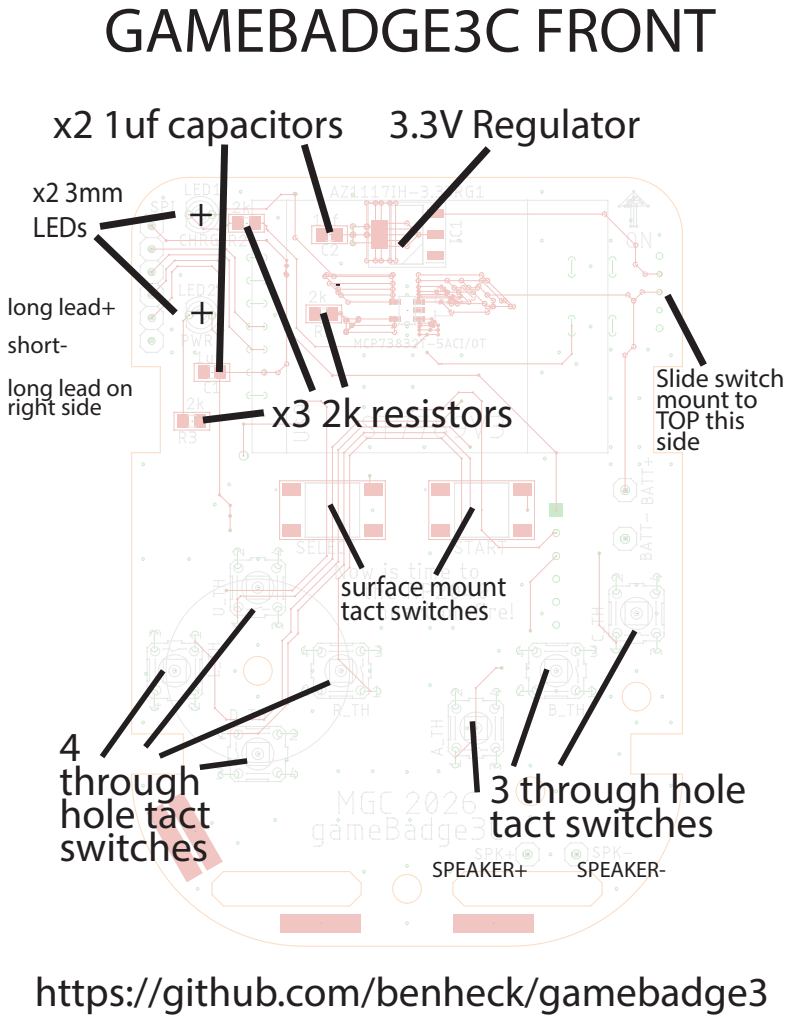
[picture p60: page 1]
x3 2k resistors; Slide switch mount to TOP this side; SPEAKER+; SPEAKER-; 4 through hole tact switches; 3 through hole tact switches; surface mount tact switches; x2 1uf capacitors; x2 3mm LEDs; 3.3V Regulator

long lead+
short-
long lead on
right side

https://github.com/benheck/gamebadge3
