benheck/gamebadge3/PCB 2026/Eagle 8.7.1 files/Gamebadge3_revD.brd

## EAGLE design PCB 2026/Eagle 8.7.1 files/Gamebadge3_revD.brd (2025-12-30)

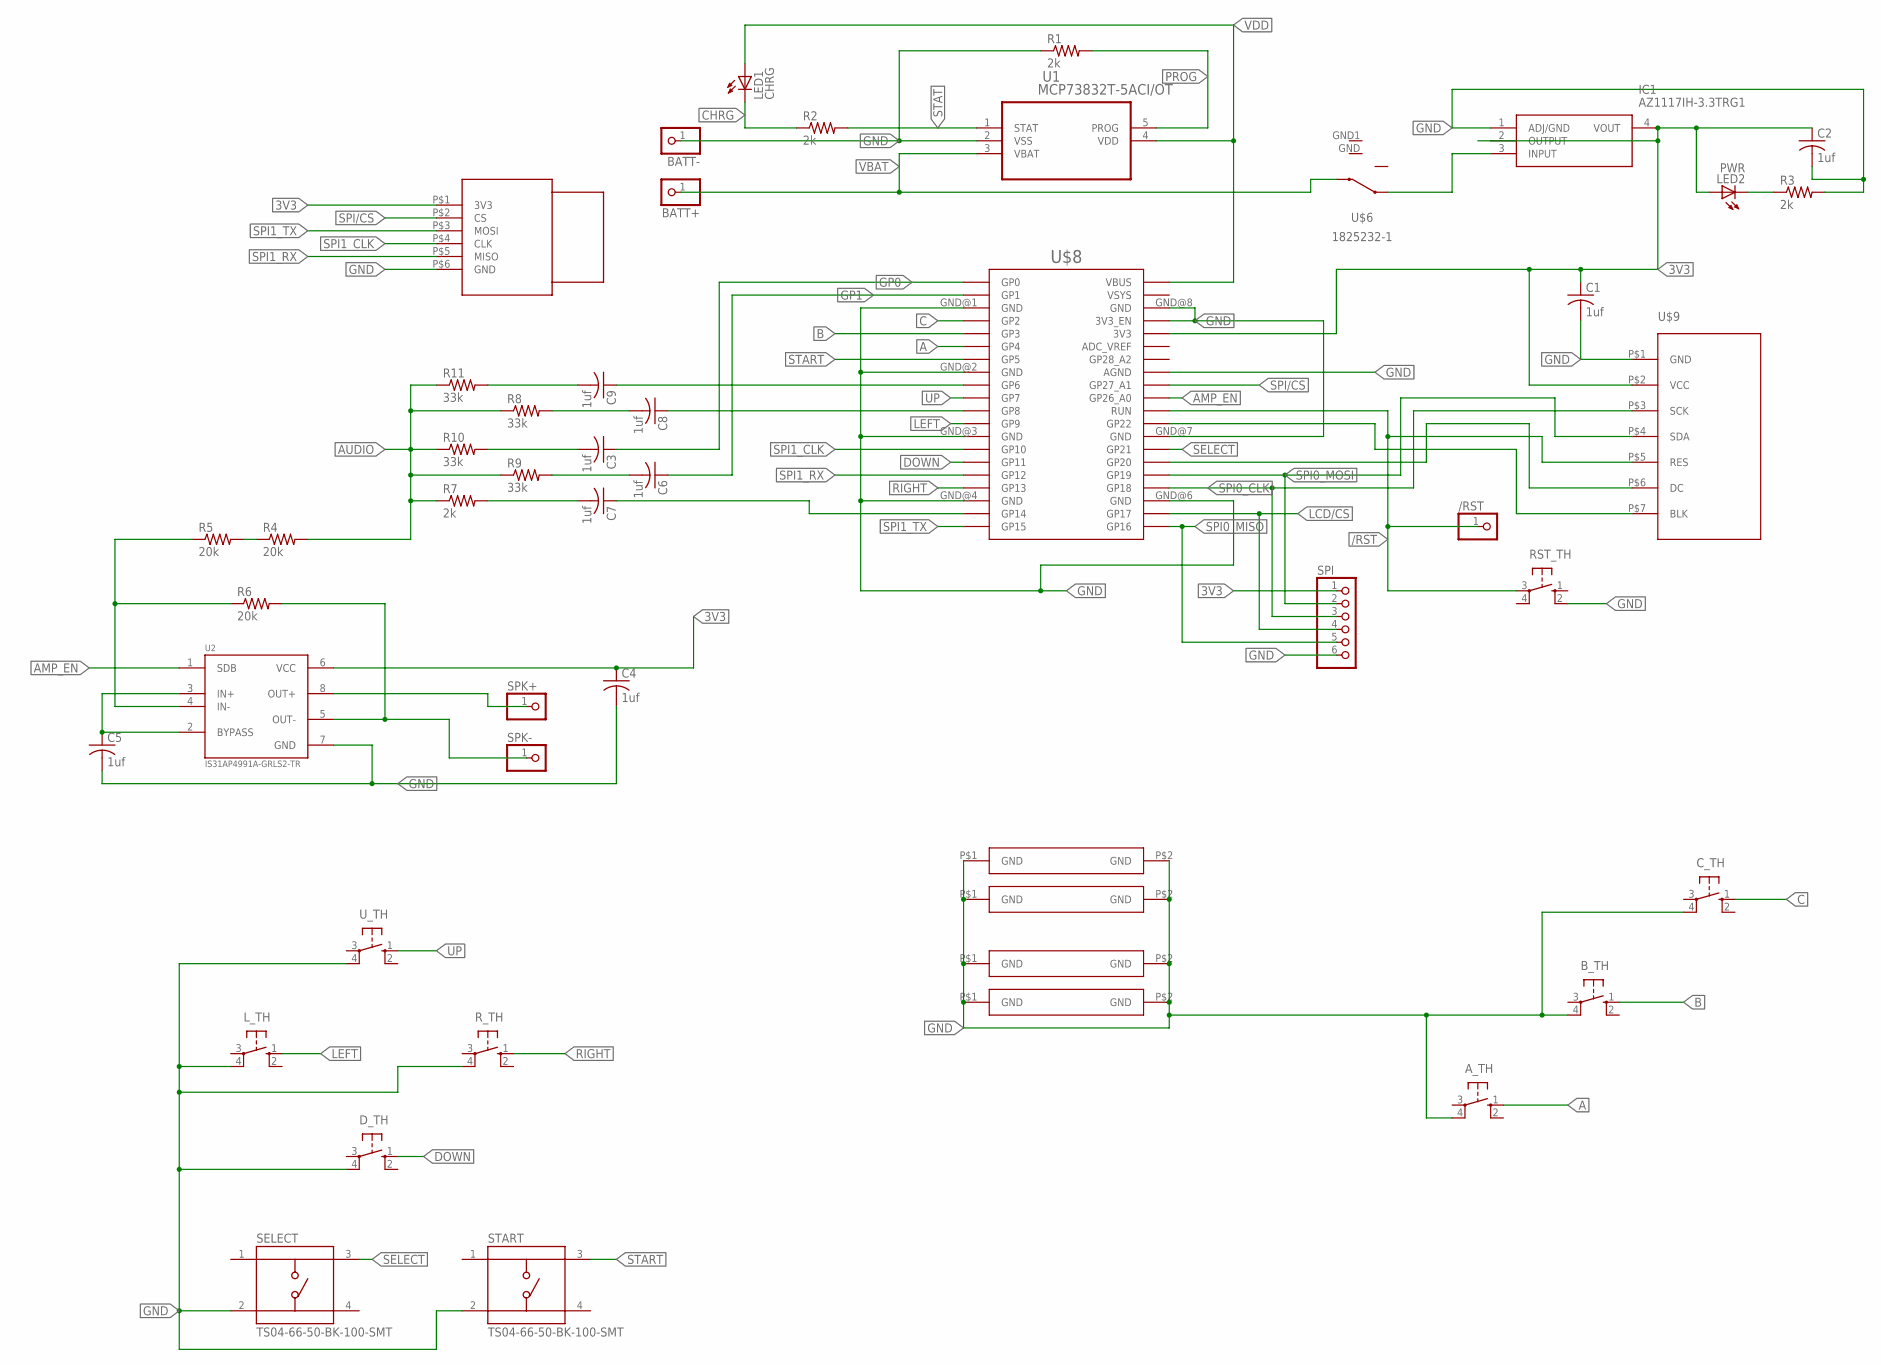
[picture p61: schematic Gamebadge3_revD.sch]

Parts:
/RST: PINHD-1X1; 1X01
A_TH: 10-XX; B3F-10XX
BATT+: PINHD-1X1; 1X01
BATT-: PINHD-1X1; 1X01
B_TH: 10-XX; B3F-10XX
C1, C2, C3, C4, C5, C6, C7, C8, C9: 1uf; C0805
C_TH: 10-XX; B3F-10XX
D_TH: 10-XX; B3F-10XX
IC1: AZ1117IH-3.3TRG1; SOT230P700X170-4N
LED1: CHRG; LED3MM
LED2: PWR; LED3MM
L_TH: 10-XX; B3F-10XX
R1, R2, R3, R7: 2k; R0805
R4, R5, R6: 20k; R0805
R8, R9, R10, R11: 33k; R0805
RST_TH: 10-XX; B3F-10XX
R_TH: 10-XX; B3F-10XX
SELECT: TS04-66-50-BK-100-SMT; SW_TS04-66-50-BK-100-SMT
SPI: PINHD-1X6; 1X06
SPK+: PINHD-1X1; 1X01
SPK-: PINHD-1X1; 1X01
START: TS04-66-50-BK-100-SMT; SW_TS04-66-50-BK-100-SMT
U1: MCP73832T-5ACI/OT; SOT95P300X145-5N
U2: IS31AP4991A-GRLS2-TR; SOIC127P604X170-8N
U$1: SD_CARD_ADAPTER; SD_CARD
U$2, U$3, U$4, U$5: GND_CLIP
U$6: 1825232-1
U$8: RPI_PICO_W
U$9: ST7789
U_TH: 10-XX; B3F-10XX

Connections:
3V3: C1.1, C2.1, C4.1, IC1.2 (OUTPUT), IC1.4 (VOUT), LED2.A, SPI.1, U2.6 (VCC), U$1.P$1 (3V3), U$8.3V3, U$9.P$2 (VCC)
/RST: /RST.1, RST_TH.3, U$8.RUN, U$9.P$5 (RES)
A: A_TH.1 (S), U$8.GP4
AMP_EN: U2.1 (SDB), U$8.GP26_A0
AUDIO: R4.2, R7.1, R8.1, R9.1, R10.1, R11.1
B: B_TH.1 (S), U$8.GP3
C: C_TH.1 (S), U$8.GP2
CHRG: LED1.K (C), R2.1
DOWN: D_TH.1 (S), U$8.GP11
GND: A_TH.4 (P1), BATT-.1, B_TH.4 (P1), C1.2, C2.2, C4.2, C5.2, C_TH.4 (P1), D_TH.4 (P1), IC1.1 (ADJ/GND), L_TH.4 (P1), R1.1, R3.2, RST_TH.2 (S1), R_TH.4 (P1), SELECT.2, SPI.6, START.2, U1.2 (VSS), U2.7 (GND), U$1.P$6 (GND), U$2.P$1, U$2.P$2, U$3.P$1, U$3.P$2, U$4.P$1, U$4.P$2, U$5.P$1, U$5.P$2, U$8.3V3_EN, U$8.AGND, U$8.GND@1 (GND), U$8.GND@2 (GND), U$8.GND@3 (GND), U$8.GND@4 (GND), U$8.GND@6 (GND), U$8.GND@7 (GND), U$8.GND@8 (GND), U$9.P$1 (GND), U_TH.4 (P1)
GP0: C3.1, U$8.GP0
GP1: C6.1, U$8.GP1
LCD/CS: SPI.4, U$8.GP17
LEFT: L_TH.1 (S), U$8.GP9
unnamed: C5.1, U2.2 (BYPASS), U2.3 (IN+)
unnamed: U$8.GP20, U$9.P$6 (DC)
unnamed: R4.1, R5.2
unnamed: U$8.GP22, U$9.P$7 (BLK)
unnamed: R5.1, R6.1, U2.4 (IN-)
unnamed: IC1.3 (INPUT), U$6.3
unnamed: R6.2, SPK-.1, U2.5 (OUT-)
unnamed: LED2.K (C), R3.1
unnamed: SPK+.1, U2.8 (OUT+)
unnamed: C7.1, U$8.GP14
unnamed: C6.2, R9.2
unnamed: C7.2, R7.2
unnamed: C8.1, U$8.GP8
unnamed: C8.2, R8.2
unnamed: C3.2, R10.2
unnamed: C9.1, U$8.GP6
unnamed: C9.2, R11.2
PROG: R1.2, U1.5 (PROG)
RIGHT: R_TH.1 (S), U$8.GP13
SELECT: SELECT.3, U$8.GP21
SPI0_CLK: SPI.3, U$8.GP18, U$9.P$3 (SCK)
SPI0_MISO: SPI.5, U$8.GP16
SPI0_MOSI: SPI.2, U$8.GP19, U$9.P$4 (SDA)
SPI1_CLK: U$1.P$4 (CLK), U$8.GP10
SPI1_RX: U$1.P$5 (MISO), U$8.GP12
SPI1_TX: U$1.P$3 (MOSI), U$8.GP15
SPI/CS: U$1.P$2 (CS), U$8.GP27_A1
START: START.3, U$8.GP5
STAT: R2.2, U1.1 (STAT)
UP: U$8.GP7, U_TH.1 (S)
VBAT: BATT+.1, U1.3 (VBAT), U$6.2
VDD: LED1.A, U1.4 (VDD), U$8.VBUS

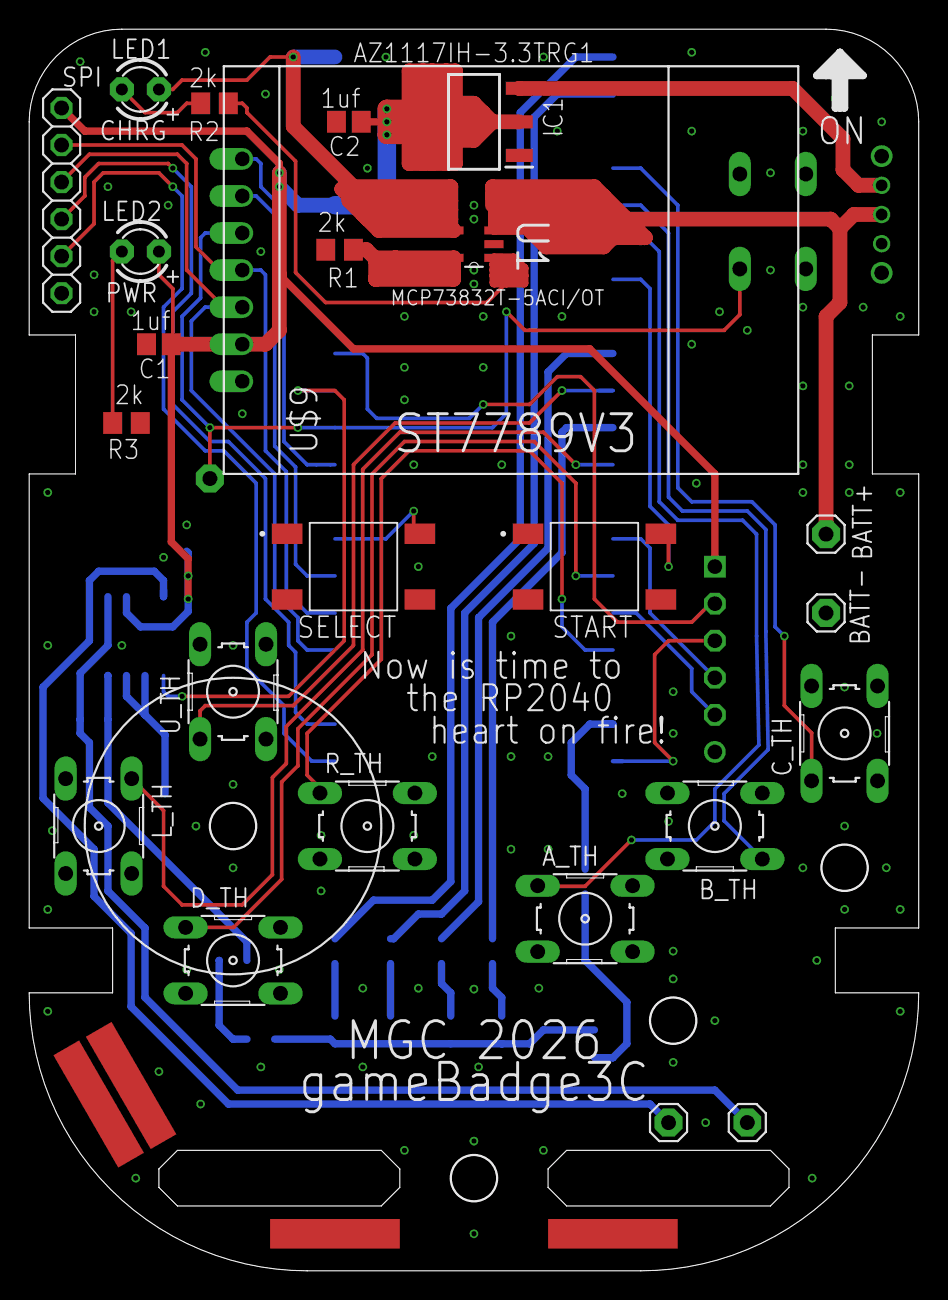
[picture p62: board Gamebadge3_revD.brd from above]

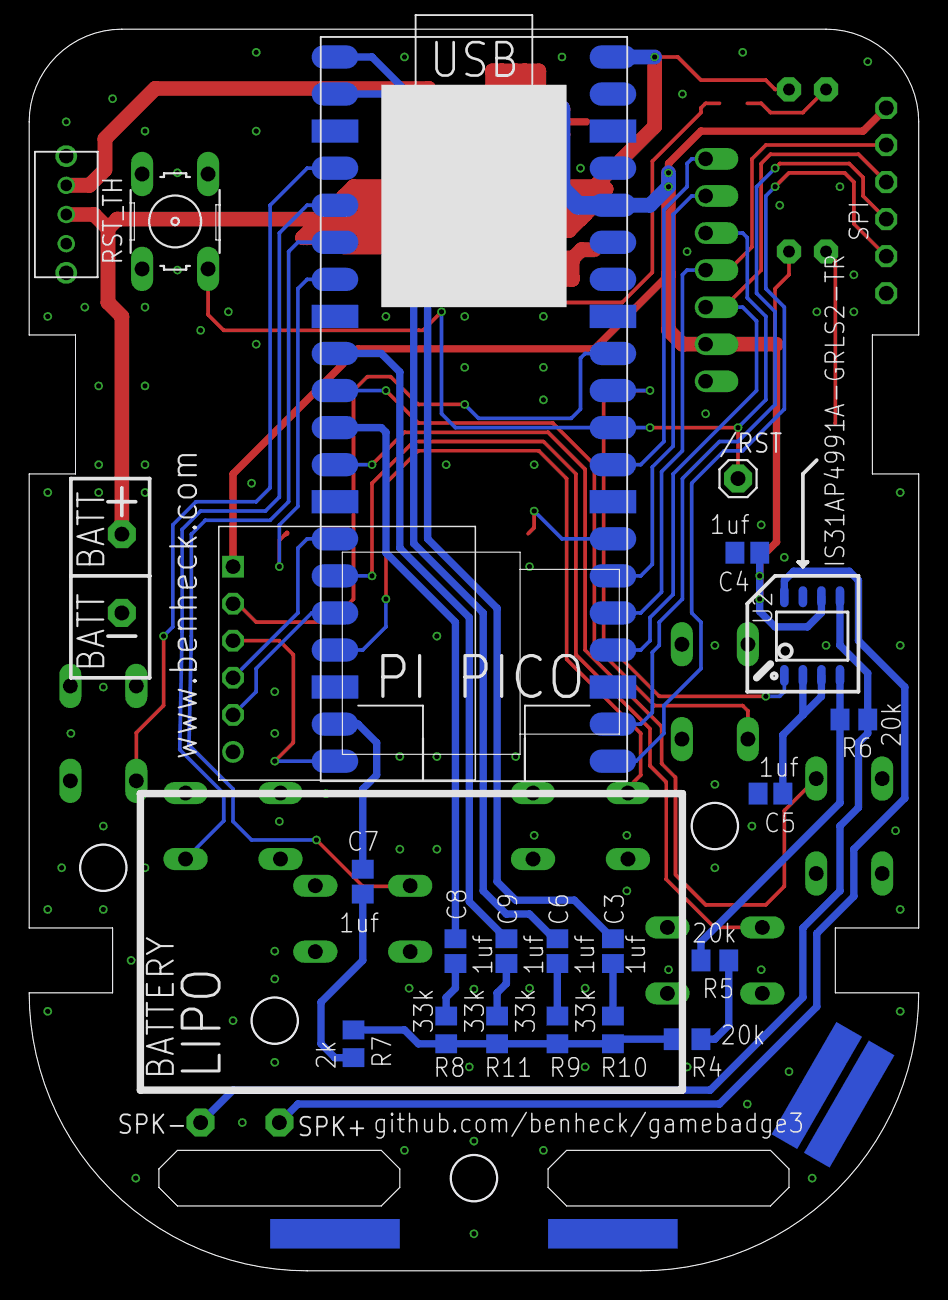
[picture p63: board Gamebadge3_revD.brd from below]

Board: 2 copper layers, 61.0 x 85.1 mm, 49 parts (21 on the bottom side), 46 nets.
