benheck/gamebadge3/code/Arduino libraries/gameBadgePico/gameBadgePico.cpp

//Game & graphics driver for gameBadgePico (MGC 2023)
#include <hardware/pio.h>								//PIO hardware

#include "Arduino.h"
#include "pico_ST7789.h"
#include "gameBadgePico.h"
#include "flash_font.h"								//Small flash array that stores A-Z so we can do a message without the file system loaded

#include "pico/stdlib.h"
#include "pico/binary_info.h"
#include "hardware/gpio.h"
#include "hardware/spi.h"
#include "hardware/dma.h"
#include "hardware/irq.h"
#include "hardware/pwm.h"

#include "SPI.h"
#include "SdFat.h"
#include "Adafruit_SPIFlash.h"
#include "Adafruit_TinyUSB.h"

Adafruit_FlashTransport_RP2040 flashTransport;		// RP2040 use same flash device that store code.	// Therefore there is no need to specify the SPI and SS
Adafruit_SPIFlash flash(&flashTransport);			// Use default (no-args) constructor to be compatible with CircuitPython partition scheme
FatFileSystem fatfs;                        		// file system object from SdFat
FatFile file;										// Object to open files
Adafruit_USBD_MSC usb_msc;                  		// USB Mass Storage object

bool fileActive = false;				//True =  a file is open (reading level, playing audio) False = file not open, available for use

#define LCD_WIDTH  240
#define LCD_HEIGHT 240

static uint16_t linebuffer[2][3840];    //Sets up 2 buffers of 120 longs x 16 lines high
				//--------Y---X--- We put the X value second so we can use a pointer to rake the data
static uint16_t nameTable[32][32];		//4 screens of tile data. Can scroll around it NES-style (LCD is 15x15, tile is 16X16, slightly larger) X is 8 bytes wider to hold the palette reference (similar to NES but with 1 cell granularity)
static uint16_t patternTable[8192];		//256 char patterns X 8 lines each, 16 bits per line. Same size as NES but chunky pixel, not bitplane and stored in shorts
static uint16_t spriteBuffer[14400];
uint16_t paletteRGB[64];				//Stores the 32 colors as RGB values, pulled from nesPaletteRGBtable (with space for 32 extra)
uint16_t nesPaletteRGBtable[64];		//Stores the current NES palette in 16 bit RGB format

#define spriteAlphaColor 	0x0001		//The 16-bit LCD RGB color that is used for sprite transparency (make sure nothing in the palette matches it)

uint16_t baseASCII = 32;				//Stores what tile in the pattern table is the start of printable ASCII (space, !, ", etc...) User can change the starting position to put ASCII whereever they want in pattern table, but this is the default
uint8_t textWrapEdges[2] = {0, 14};		//Sets a left and right edge where text wraps in the tilemap. Use can change this, default is left side of scroll, one screen wide
bool textWordWrap = true;				//Is spacing word-wrap enabled (fancy!)

uint8_t winX[32];
uint8_t winXfine[32];
uint8_t winY = 0;
uint8_t winYfine = 0;
uint8_t winYJumpList[16];				//One entry per screen row. If flag set, winY coarse jumps to nametable row specified and yfinescroll is reset to 0
uint8_t winYreset = 0; 					//What coarse Y rollovers to in nametable when it reaches winYrollover
uint8_t winYrollover = 31;				//If coarse window Y exceeds this, reset to winYreset. Use this drawing status bars or creating vertical margins for word wrap
int xLeft = -1;							//Sprite window limits. Use this to prevent sprites from drawing over status bar (reduce yBottom by 12)
int xRight = 120;
int yTop = -1;
int yBottom = 120;


uint32_t audioSamples = 0;
uint8_t whichAudioBuffer = 0;
bool audioPlaying = false;

#define audioBufferSize	512
uint32_t audioBuffer0[audioBufferSize] __attribute__((aligned(audioBufferSize)));
uint32_t audioBuffer1[audioBufferSize] __attribute__((aligned(audioBufferSize)));

bool fillBuffer0flag = false;
bool fillBuffer1flag = false;
bool endAudioBuffer0flag = false;
bool endAudioBuffer1flag = false;
int audio_pin_slice;

bool backlightOnFlag = false;

int currentAudioPriority = 0;


const int notes[] = {
    261, 277, 293, 311, 329, 349, 369, 391, 415, 440, 466, 493
};

int indexToGPIO[9] = {7, 11, 9, 13, 21, 5, 4, 3, 2};		//Button index is UDLR SEL STR A B C  this maps that to the matching GPIO

bool debounce[9] = {false, false, false, false, true, true, true, true, true};		//Index of which buttons have debounce (button must open before it can re-trigger)
uint8_t debounceStart[9] = {0, 0, 0, 0, 5, 5, 1, 1, 1};								//If debounce, how many frames must button be open before it can re-trigger.
uint8_t debounceTimer[9] = {0, 0, 0, 0, 0, 0, 0, 0, 0};    							//The debounceStart time is copied here, and debounceTimer is what's decrimented

//Used to pre-store GPIO-to-channel numbers for PWM (5th channel reserved for PCM audio wave files)
uint8_t slice_numbers[4];
uint8_t chan_nummbers[4];

struct st7789_config lcd_config = {
    .spi      = spi0,      // Default SPI instance
    .gpio_din = 19,        // Default MOSI pin
    .gpio_clk = 18,        // Default SCK pin
    .gpio_cs  = 17,        // Default CS pin  (ST7789v3 does not use)
    .gpio_dc  = 20,        // Custom pin for DC
    .gpio_rst = 21,        // Custom pin for RST
    .gpio_bl  = 22,         // Custom pin for backlight
	.rotation = 0,			
	.isV3 = false		   //ST7789 type
};

void gamebadge3init(bool remapAudio, int rotation, bool V3, int CSpin) {				//Sets up gamebadge and a bunch of other crap

	flash.begin();

	usb_msc.setID("Adafruit", "External Flash", "1.0");                     // Set disk vendor id, product id and revision with string up to 8, 16, 4 characters respectively
	usb_msc.setReadWriteCallback(msc_read_cb, msc_write_cb, msc_flush_cb);  // Set callback
	usb_msc.setCapacity(flash.size()/512, 512);                             // Set disk size, block size should be 512 regardless of spi flash page size
	usb_msc.setUnitReady(true);                                             // MSC is ready for read/write
	usb_msc.begin();

	//Serial.begin(115200);

	if (!fatfs.begin(&flash)) {
		//Serial.println("Failed to init files system, flash may need to be formatted");
	}

	//Serial.println("Adafruit TinyUSB Mass Storage External Flash example");
	//Serial.print("JEDEC ID: 0x"); Serial.println(flash.getJEDECID(), HEX);
	//Serial.print("Flash size: "); Serial.print(flash.size() / 1024); Serial.println(" KB");

	lcd_config.gpio_cs = CSpin;					//override in
	lcd_config.rotation = rotation;
	lcd_config.isV3 = V3;

	st7789_init(&lcd_config, 240, 240);			//Set up LCD for great justice

	gpio_init(15);								//Pinout for scope timing checks
	gpio_set_dir(15, GPIO_OUT);
	gpio_put(15, 0);
	
	gpio_init(26);								//Audio amp enable (active HIGH)
	gpio_set_dir(26, GPIO_OUT);
	gpio_put(26, 1);	

	gpio_init(27);								//External SPI CS or extra scope pin
	gpio_set_dir(27, GPIO_OUT);
	gpio_put(27, 0);
	
	gpio_set_function(14, GPIO_FUNC_PWM);
	audio_pin_slice = pwm_gpio_to_slice_num(14);	
	pwm_config config = pwm_get_default_config();
	
	pwm_config_set_clkdiv(&config, 5.5f); 
    pwm_config_set_wrap(&config, 255); 
    pwm_init(audio_pin_slice, &config, true);

    gpio_set_function(6, GPIO_FUNC_PWM);
	gpio_set_function(8, GPIO_FUNC_PWM);

	if (remapAudio) {
		gpio_set_function(0, GPIO_FUNC_PWM);
		gpio_set_function(1, GPIO_FUNC_PWM);
	} else {
    	gpio_set_function(10, GPIO_FUNC_PWM);
		gpio_set_function(12, GPIO_FUNC_PWM);
	}

	gpio_set_function(14, GPIO_FUNC_PWM);
	
	pwm_set_gpio_level(14, 128);					//Set PWM base level

			//GPIO , our Channel #
	setupPWMchannels(6, 0);					//Map GPIO to slices/channel to our own channel index (saves math later)
	setupPWMchannels(8, 1);					//Map GPIO to slices/channel to our own channel index (saves math later)
	
	if (remapAudio) {
		setupPWMchannels(1, 2);					//Map GPIO to slices/channel to our own channel index (saves math later)
		setupPWMchannels(0, 3);					//Map GPIO to slices/channel to our own channel index (saves math later)
	} else {
		setupPWMchannels(10, 2);					//Map GPIO to slices/channel to our own channel index (saves math later)
		setupPWMchannels(12, 3);					//Map GPIO to slices/channel to our own channel index (saves math later)
	}
	

	for (int x = 0 ; x < 9 ; x++) {				//Setup the 9 GPIO used for controls
		setGPIObutton(indexToGPIO[x]);									//Init each pin using the index mapping
		setButtonDebounce(x, debounce[x], debounceStart[x]);			//Pass the default values back into themselves. User can change these later on
		//For instance menus, you'll want to set a debounce for the d-pad so it's one click per action. Then disable d-pad debounce when game starts	
	}
	
	//Load "emergency" font from flash into RAM so we can show a message if not pattern files present yet

	paletteRGB[3] = 0xFFFF;			//Palette 0, color 3, force WHITE
	// paletteRGB[7] = 0xFFFF;			//Palette 0, color 3, force WHITE
	// paletteRGB[11] = 0xFFFF;			//Palette 0, color 3, force WHITE	
	// paletteRGB[15] = 0xFFFF;			//Palette 0, color 3, force WHITE	
	
	unsigned char lowBit[8];
	unsigned char highBit[8];

	int arrayPointer = 0;

	for (uint16_t numChar = 64 ; numChar < (64 + 32) ; numChar++) {		//Read a bitplane filestream created by YY-CHR

		for (int x = 0 ; x < 8 ; x++) {
			lowBit[x] = flashFont[arrayPointer++];
		}
		for (int x = 0 ; x < 8 ; x++) {
			highBit[x] = flashFont[arrayPointer++];
		}		
		
		convertBitplanePattern(numChar << 3, lowBit, highBit);		//Pass array points to function that will convert to chunky pixels

	}
			//0123456789ABCDE
	drawText(" NO DATA FILES", 0, 4, false);	
	drawText("LOAD VIA USB", 2, 6, false);
	
	drawText(" AND RESET", 2, 8, false);		
	
}

void setupPWMchannels(int whichGPIO, int whichChannel) {


	slice_numbers[whichChannel] = pwm_gpio_to_slice_num(whichGPIO);
	chan_nummbers[whichChannel] = pwm_gpio_to_channel(whichGPIO);
	
	
}

void pwm_set_freq_music(int whichChannel, uint8_t duty_cycle) {

	uint slice_num = slice_numbers[whichChannel];			//Do this once, less math
	uint chan = chan_nummbers[whichChannel];

	pwm_set_clkdiv_int_frac(slice_num, 1, 0);
	pwm_set_wrap(slice_num, 8000);
	pwm_set_chan_level(slice_num, chan, (8000 * duty_cycle) / 100);
	pwm_set_enabled(slice_num, true);

	// return wrap;
}



uint32_t pwm_set_freq_duty(int gpioNum, uint32_t f, int d) {

	uint slice_num = pwm_gpio_to_slice_num(gpioNum);
	uint chan = pwm_gpio_to_channel(gpioNum);

	 uint32_t clock = 125000000;
	 uint32_t divider16 = clock / f / 4096 + (clock % (f * 4096) != 0);
	 
	 if (divider16 / 16 == 0) {
		divider16 = 16;
	 }
 
	 uint32_t wrap = clock * 16 / divider16 / f - 1;
	 
	 pwm_set_clkdiv_int_frac(slice_num, divider16 / 16, divider16 & 0xF);
	 pwm_set_wrap(slice_num, wrap);
	 pwm_set_chan_level(slice_num, chan, (wrap * d) / 100);
	 pwm_set_enabled(slice_num, true);

	 return wrap;
}

void backlight(bool state) {		//This is OFF on boot. Software control for sleep and also making boot cleaner

	st7789_backlight(state);	
	
}

void setGPIObutton(int which) {		//Used internally to setup button GPIO
	gpio_init(which);
	gpio_set_dir(which, GPIO_IN);
	gpio_pull_up(which);			
}

//Enables/disables button debounce. If useDebounce = true, button must be released for frames before it can be re-triggered (usually ABC, or D-pad during menus)
void setButtonDebounce(int which, bool useDebounce, uint8_t frames) {	

	debounce[which] = useDebounce;
	
	if (useDebounce == true && frames < 1) {			//If debounce you must have at minimum 1 frame of debounce time (at least one frame off before can retrigger)
		frames = 1;
	}

	debounceStart[which] = frames;		
	debounceTimer[which] = frames;						//Reset this as if a button has been pressed. This allows us to switch without false edges
	
}

//Returns a boolean of the button state, using debounce settings
bool button(int which) {				//A, B, C, select, start, up, down, left, right

	if (debounce[which] == true) {								//Switch has debounce?
		if (debounceTimer[which] == 0) {						//Has timer cleared?
			if (gpio_get(indexToGPIO[which]) == 0) {			//OK now you can check for a new button press
				debounceTimer[which] = debounceStart[which];		//Yes? Set new timer
				return true;										//and return button pressed
			}				
		}
	}
	else {
		if (gpio_get(indexToGPIO[which]) == 0) {		//Button pressed? That's all we care about
			return true;
		}		
	}

	return false;
	
}

//Must be called once per frame to service the button debounce
void serviceDebounce() {				//Must be called every frame, even if paused (because the buttons need to work to unpause!)

	for (int x = 0 ; x < 9 ; x++) {				//Scan all buttons
		if (debounce[x] == true) {				//Button uses debounce?
			if (debounceTimer[x] > 0) {			//Is the value above 0? That means button was pressed in the past
				if (gpio_get(indexToGPIO[x]) == 1) {			//Has button opened?
					debounceTimer[x]--;			//If so, decrement debounce while it's open. When debounce reaches 0, it can be re-triggered under button funtion
				}		
			}
		}		
	}
	
}

//Loads the YY-CHR 64 color palette file (.pal) from file into RAM. This must be called before calling loadPalette as that uses this index to fill tables. Only need to call this once after boot (color selection palette is static)
bool loadRGB(const char* path) {

	if (file.open(path, O_RDONLY)) {
		
	  for (int x = 0 ; x < 64 ; x++) {								//Convert each 3 byte 24-bit RGB value from disk to 16-bit color in RAM that uses same color space as ST7789 LCD
		updatePaletteRGB(x, file.read(), file.read(), file.read()); //We do as much math up front during loads to save time during frame render (trading RAM for speed)
	  }
	  file.close();		  
	  return true;
	
	}
	
	return false;

}

//Loads  the YY-CHR palette data file (.dat) from file into RAM. There are 8 palettes of 4 colors each (sprites use color 0 as transparency, tiles can set 4 unique colors)
void loadPalette(const char* path) {
	
  digitalWrite(LED_BUILTIN, HIGH);

  file.open(path, O_RDONLY);

  for (int x = 0 ; x < 64 ; x++) {
    updatePalette(x, file.read());							//Use palette.dat file to create an RGB reference for all 32 colors 
  }

  file.close();
  
  digitalWrite(LED_BUILTIN, LOW);
//This loads 32 byte indexes from disk that point to the table loaded by loadRGB, ie: if palette 0, color 0 (first byte in file) contains a 1, it
//is referencing the second byte (index[1]) of the nesPaletteRGBtable[] table. 

}

//To save math we copy the RGB values (as a 16-bit number) to the paletteRGB index.
void updatePalette(int position, char theIndex) {						//Allows game code to update palettes off flash/SD
	

	paletteRGB[position] = nesPaletteRGBtable[theIndex];
//Updates the palette table with the 16-bit value stored in the master list of available colors (that were loaded in with loadRGB)
//You can also use this function for dynamic palette changes, like the Mega Man 2 waterfall	
}

//Converts a 24-bit RGB value (such as RGB file) to the 16-bit color of the ST7789 LCD
void updatePaletteRGB(int position, char r, char g, char b) {						//Allows game code to update palettes off flash/SD

	uint16_t red = r;
	uint16_t green = g;
	uint16_t blue = b;

	red &= 0xF8;			//Lob off bottom 3 bits
	red <<= 8;				//Pack to MSB
	green &= 0xFC;			//Lob off bottom 2 bits (because evolution)
	green <<= 3;			//Pack to middle
	blue &= 0xF8;			//Lobb off bottom 3 bits
	blue >>= 3;				//Pack to LSB
	
	nesPaletteRGBtable[position] = red | green | blue;				//Put the 16-bit color value in the palette RGB index (max 64 colors)
	
}

//Loads a YY-CHR .nes file (pattern table data, aka graphics) from disk and stores it in Pico RAM
void loadPattern(const char* path, uint16_t start, uint16_t length) {	//Loads a pattern file into memory. Use start & length to only change part of the pattern, like of like bank switching!

  unsigned char lowBit[8];
  unsigned char highBit[8];

  digitalWrite(LED_BUILTIN, HIGH);

  file.open(path, O_RDONLY);

  for (uint16_t numChar = start ; numChar < (start + length) ; numChar++) {		//Read a bitplane filestream created by YY-CHR

    file.read(lowBit, 8);				//Stream the low bits into array
    file.read(highBit, 8);				//Stream the high bits into array	

    convertBitplanePattern(numChar << 3, lowBit, highBit);		//Pass array points to function that will convert to chunky pixels
    
  }
  //NES pattern tables used planer (bitplane) graphics. Each pixel was represented by 2 bits (thus 4 colors) but the bits were not next to each other in memory
  //They were stored at different offsets (planer) This was used by a lot of computers in the 80's such as the Atari ST and Amiga. A 4 bit (16 color) image was
  //stored in memory as (4) separate 1 bit patterns and combined by video hardware https://en.wikipedia.org/wiki/Planar_(computer_graphics)
  //Later systems such as the Master System/Genesis used "chunky" pixels in which multiple bits used to define color were stored next to each other in the same byte
  
  //By default gamebadge has 8192 words of pattern data (chunky pixel) which equals (4) 16x16 tile patterns that can be stored in memory at once (twice that of the NES)
  //Unlike the NES you can either any tile for either spites or tiles
  
  file.close();

  digitalWrite(LED_BUILTIN, LOW);
  
}

//In tilemap position X/Y, draw the tile at index "whattile" from the pattern table using whatPalette (0-7)
void drawTile(int xPos, int yPos, uint16_t whatTile, char whatPalette, int flags) {
	
		flags &= 0xF8;							//You can use the top 5 bits for attributes, we lob off anything below that (the lower 3 bits are for tile palette)

		nameTable[yPos][xPos] = (flags << 8) | (whatPalette << 8) | whatTile;			//Palette points to a grouping of 4 colors, so we shift the palette # 2 to the left to save math during render		
}

//In tilemap position X/Y, draw the tile at position tileX to the right, tileY down, from the pattern table using whatPalette (0-7)
void drawTile(int tileX, int tileY, uint16_t patternX, uint16_t patternY, char whatPalette, int flags) {

		flags &= 0xF8;							//You can use the top 5 bits for attributes, we lob off anything below that (the lower 3 bits are for tile palette)

		uint16_t whatTile = (patternY * 16) + patternX;						//Do this math for the user :)

		nameTable[tileY][tileX] = (flags << 8) | (whatPalette << 8) | whatTile;			//Palette points to a grouping of 4 colors, so we shift the palette # 2 to the left to save math during render		
}

//Sets flags on a tile (blocking, platform, etc). By default drawTile sets these as 0. You must use setTileType after using drawTile
void setTileType(int tileX, int tileY, int flags) {						
	
	flags &= 0xF8;							//You can use the top 5 bits for attributes, we lob off anything below that (the lower 3 bits are for tile palette)
	
	nameTable[tileY][tileX] &= 0x07FF;				//AND off the top 5 bits
	
	nameTable[tileY][tileX] |= (flags << 8);		//OR it into the tile in nametable
	
}

void tileDirect(int tileX, int tileY, uint16_t theData) {			//Copies data directy into tile map
	
	nameTable[tileY][tileX] = theData;		
}

void setTilePalette(int tileX, int tileY, int whatPalette) {	

	whatPalette <<= 8;				//Bitshift it over
	
	whatPalette &= 0x0300;			//Ensure it won't overwrite anything else
		
	nameTable[tileY][tileX] &= 0xF8FF;		//Erase those 3 bits from the tile attb
	
	nameTable[tileY][tileX] |= whatPalette;	//OR in new color


}


//Retrieves the flags set by the function above (bit-shifted back into the low byte) Use this to detect collisions, spikes and stuff
int getTileType(int tileX, int tileY) {
	
	return (nameTable[tileY][tileX] >> 8) & 0xF8;
	
}

//Retrieves the value of the tile itself. Use this to pull text from the screen like password entry
int getTileValue(int tileX, int tileY) {
	
	return nameTable[tileY][tileX] & 0xFF;			//Lob off top, return lower byte
	
}

//Used to fill or clear a large amount of tiles (should do on boot in case garbage in RAM though in theory arrays should boot at 0's)
void fillTiles(int startX, int startY, int endX, int endY, uint16_t whatTile, char whatPalette) {
	
	endX++;
	endY++;
	
	for (int y = startY ; y < endY ; y++) {		
		for (int x = startX ; x < endX ; x++) {
			drawTile(x, y, whatTile, whatPalette);
		}		
	}

}

//Used to fill or clear a large amount of tiles (should do on boot in case garbage in RAM though in theory arrays should boot at 0's)
void fillTiles(int startX, int startY, int endX, int endY, uint16_t patternX, uint16_t patternY, char whatPalette) {
	
	endX++;
	endY++;
	
	uint16_t whatTile = (patternY * 16) + patternX;						//Do this math for the user :)
	
	
	for (int y = startY ; y < endY ; y++) {		
		for (int x = startX ; x < endX ; x++) {
			drawTile(x, y, whatTile, whatPalette);
		}		
	}

}

//By default drawing decimal/text assumes printable ASCII starts at pattern tile 32 (space) Use this function if you put ASCII elsewhere in your pattern table
void setASCIIbase(uint16_t whatBase) {
	
	baseASCII = whatBase;

}

//If drawing text with doWrap = true, this sets the left and right margins in the name table (min 0, max 31)
void setTextMargins(int left, int right) {
	
	textWrapEdges[0] = left;
	textWrapEdges[1] = right;
	
	//If you want stuff to wrap within a static screen, you'd use 0, 14 (the default)
	//If you want to fill the name table with text, such as frame a webpage, you could set 0, 31 and then scroll left and right to read all text
	//Text carriage returns wrap within the same confines defined by setCoarseYRollover(int topRow, int bottomRow);
	//Text that goes past bottomRow will wrap to topRow
	
}

//Draws a string of horizontal text at position x,y in the tilemap and if doWrap=true follows word wrap rules, else just draws from left to right
void drawText(const char *text, uint8_t x, uint8_t y, bool doWrap) {

	//gpio_put(15, 1);

	if (doWrap) {

		bool cr = false;								//Set TRUE to perform a carriage return (several things can cause this hence the flag)

		while(*text) {
			if (*text == ' ') {							//If current character is a space, then we need to do special checks
				//Serial.print("Space found. ");
				if (x == textWrapEdges[0]) {			//No reason to draw spaces on left margin
					//Serial.println("Left margin skip");
					text++;								//Advance pointer but not X
				}
				else {												//Not on left margin?
					if (x == textWrapEdges[1]) {					//Does this space land on the right margin?
						//Serial.println("On right margin. Draw space and do CR");
						nameTable[y][x] = *text++;					//Draw the space...
						cr = true;									//and set carriage return for next char
					}
					else {											//OK so there is at least 1 character of space after this space " "
						//Serial.print("Next word='");
						int charCount = 0;								//Let's count the characters in the next word
						nameTable[y][x++] = *text;					    //Draw the space and advance x

						while(*text == 32) {							//Move text past the space and keep going until we find a non-space
							*text++;
						}
						
						if (*text == 0) {								//Ok we're past all the damn spaces. Did we hit end of string because some asshole typed "hello world!   " ?
							return;										//Fuck it we're done!
						}
			
						while(*text != 32 && *text != 0) {				//Look for the next space or end of string
							//Serial.write(*text);						//Debug
							charCount++;								//Count how many chars we find in front of next space or end
							text += 1;									//Advance the pointer
						}
						
						//Serial.print("' length = ");
						//Serial.print(charCount, DEC);
						//Serial.print(" WRAP? ");
						text -= charCount;								//Rollback pointer to start of word because we still need to draw it
						if (charCount > ((textWrapEdges[1] + 1) - x)) {		//Check if enough characters to draw this word (offset +1 because we need count not index)
							//Serial.println("YES");						//Have to make sure stuff like " to" or " I" renders
							cr = true;
						}
						else {
							//Serial.println("NO");
						}					
					}	
				}
			}
			else {
				if (x == textWrapEdges[1]) {		//Will this character land on the right margin?
					text++;							//Check next character
					
					if (*text == ' ') {				//Single character with a space after? "a ", " I"...
						text--;						//Backup pointer
						nameTable[y][x] = *text++;	//and print it, advancing the pointer again. Next line will see the space and skip it since beginning of line
					}
					else {
						nameTable[y][x] = '-';		//Draw a hyphen
						text--;						//Backup pointer so the character that wasn't ' ' will print on next line
					}
					cr = true;
				}
				else {
					nameTable[y][x++] = *text++;	//Standard draw
				}			
			}		
			
			if (cr == true) {						//Flag to do carriage return?
				//Serial.println("Carriage Return");
				cr = false;							//Clear flag
				x = textWrapEdges[0];				//Jump to left margin
				if (++y > winYrollover) {			//Advance Y row and rollover if it goes past bottom limit
					y = winYreset;
				}
			}	
			//Serial.print(x, DEC);
			//Serial.print(" ");
			//Serial.println(y, DEC);
		}
	}
	else {
		while(*text) {
			nameTable[y][x] &= 0xFF00;			//Retain attb and color bits
			nameTable[y][x++] |= *text++;			//Just draw the characters from left to write
		}
	}

	//gpio_put(15, 0);

}

//Draws a string of horizontal text at position x,y in the sprite layer
void drawSpriteText(const char *text, uint8_t x, uint8_t y, int whatPalette) {
	
	while(*text) {
		drawSprite(x, y, *text++, whatPalette);
		x += 8;
	}
		
}

void drawDecimal(int32_t theValue, uint8_t x, uint8_t y) {			//Send up to a 9 digit decimal value to memory

	int zPad = 0;							//Flag for zero padding
	uint32_t divider = 100000000;			//Divider starts at 900 million = max decimal printable is 999,999,999

	for (int xx = 0 ; xx < 9 ; xx++) {		//9 digit number
		if (theValue >= divider) {
			nameTable[y][x++] = '0' + (theValue / divider);
			theValue %= divider;
			zPad = 1;
		}
		else if (zPad || divider == 1) {			
			nameTable[y][x++] = '0';
		}
		divider /= 10;
	}
}

void drawDecimal(int32_t theValue, uint8_t y) {			//Same as above but centers the number on screen. Good for end of level scores

	int zPad = 0;							//Flag for zero padding
	uint32_t divider = 100000000;			//Divider starts at 900 million = max decimal printable is 999,999,999

	char theText[10];
	theText[0] = '0';						//Hopefully you don't suck this bad, but if you do...
	for (int g = 1 ; g < 10 ; g++) {		//Ensure zero termination
		theText[g] = 0;
	}
	
	int x = 0;

	for (int xx = 0 ; xx < 9 ; xx++) {		//9 digit number
		if (theValue >= divider) {
			theText[x++] = '0' + (theValue / divider);
			theValue %= divider;
			zPad = 1;
		}
		else if (zPad || divider == 1) {			
			theText[x++] = '0';
		}
		divider /= 10;
	}
	
	x--;			//Get rid of last inc
	
	int xPos = (15 - x) / 2;		//Center text
	drawText(theText, xPos, y, false);
	
}


void drawSpriteDecimal(int32_t theValue, uint8_t x, uint8_t y, int whatPalette) {			//Send up to a 9 digit decimal value to memory

	int zPad = 0;							//Flag for zero padding
	uint32_t divider = 100000000;			//Divider starts at 900 million = max decimal printable is 999,999,999

	for (int xx = 0 ; xx < 9 ; xx++) {		//9 digit number
		if (theValue >= divider) {
			drawSprite(x, y, '0' + (theValue / divider), whatPalette);
			theValue %= divider;
			zPad = 1;
			x += 8;
		}
		else if (zPad || divider == 1) {	
			drawSprite(x, y, '0', whatPalette);		
			x += 8;
		}
		divider /= 10;		
	}
}

void drawSpriteDecimalRight(int32_t theValue, uint8_t xRight, uint8_t y, int whatPalette) {			//Send up to a 9 digit decimal value to memory

	int zPad = 0;							//Flag for zero padding
	uint32_t divider = 100000000;			//Divider starts at 900 million = max decimal printable is 999,999,999

	char theText[10];
	theText[0] = '0';						//Hopefully you don't suck this bad, but if you do...
	for (int g = 1 ; g < 10 ; g++) {		//Ensure zero termination
		theText[g] = 0;
	}
	
	int x = 0;

	for (int xx = 0 ; xx < 9 ; xx++) {		//9 digit number
		if (theValue >= divider) {
			theText[x++] = '0' + (theValue / divider);
			theValue %= divider;
			zPad = 1;
		}
		else if (zPad || divider == 1) {			
			theText[x++] = '0';
		}
		divider /= 10;
	}
	
	x--;						//Get rid of last inc

	do {
		drawSprite(xRight, y, theText[x--], whatPalette);
		xRight -= 8;	
	} while (x > -1);

}



//Draws a sprite at xPos/yPos using a range of tiles from the pattern table, starting at tileX/Y, ending at xWide/yHigh, using whichpalette and flipped V/H if true 
void drawSprite(int xPos, int yPos, uint16_t tileX, uint16_t tileY, uint16_t xWide, uint16_t yHigh, uint8_t whichPalette, bool hFlip, bool vFlip) {

	int tileYstart = tileY;
	int tileYend = tileY + yHigh;
	int tileYdir = 1;

	if (vFlip) {
		tileYstart = tileY + yHigh;
		tileYend = tileY;
		tileYdir = -1;		
	}

	for (int yTiles = tileYstart ; yTiles != tileYend ; yTiles += tileYdir) {	

		int xPosTemp = xPos;

		if (hFlip) {
			for (int xTiles = (tileX + (xWide - 1)) ; xTiles > (tileX - 1) ; xTiles--) {
				drawSprite(xPosTemp, yPos, xTiles, yTiles, whichPalette, true, vFlip);			//Use other function to draw a series of 8x8 sprites
				xPosTemp += 8;
			}				
		}
		else {
			for (int xTiles = tileX ; xTiles < (tileX + xWide) ; xTiles++) {
				drawSprite(xPosTemp, yPos, xTiles, yTiles, whichPalette, false, vFlip);			//Use other function to draw a series of 8x8 sprites	
				xPosTemp += 8;
			}				
		}

		yPos += 8;	
		
	}
	
}

//Draws a single 8x8 sprite at xPos/yPos using a tile from the pattern table at tileX/Y, using whichpalette and flipped V/H if true 
void drawSprite(int xPos, int yPos, uint16_t tileX, uint16_t tileY, uint8_t whichPalette, bool hFlip, bool vFlip) {

	//gpio_put(15, 1);

	tileX <<= 3;
	tileY <<= 7;
	
	int lineYdir = 1;			//Normal sprites
	int vFlipOffset = 0;
	
	if (vFlip) {				//Vertical flip
		lineYdir = -1;
		vFlipOffset = 7;
	}
		
	if (hFlip) {
		uint16_t *sp = &spriteBuffer[(yPos * 120) + xPos];    				  //Use pointer so less math later on
		uint16_t *tilePointer = &patternTable[tileX + tileY + vFlipOffset];

		for (int yPixel = yPos ; yPixel < (yPos + 8) ; yPixel++) {

			uint16_t temp = *tilePointer;						//Get pointer for sprite tile

			for (int xPixel = xPos ; xPixel < (xPos + 8) ; xPixel++) {
				
				uint8_t twoBits = temp & 0x03;					//Get lowest 2 bits
				
				//For a sprite pixel to be drawn, it must be within the current window, not a 0 index color, and not over an existing sprite pixel
				if (xPixel > xLeft && xPixel < xRight && yPixel > yTop && yPixel < yBottom && twoBits != 0 && *sp == spriteAlphaColor) {
					*sp = paletteRGB[(whichPalette << 2) + twoBits];
				}
				sp++;
				temp >>= 2;										//Shift for next 2 bit color pair

			}
			
			tilePointer += lineYdir;			
			sp += (120 - 8);
			
		}		
	}
	else {
		uint16_t *sp = &spriteBuffer[(yPos * 120) + xPos];    				  //Use pointer so less math later on

		uint16_t *tilePointer = &patternTable[tileX + tileY + vFlipOffset];

		for (int yPixel = yPos ; yPixel < (yPos + 8) ; yPixel++) {

			uint16_t temp = *tilePointer;										//Get pointer for sprite tile

			for (int xPixel = xPos ; xPixel < (xPos + 8) ; xPixel++) {
				
				uint8_t twoBits = temp >> 14;									//Smash this down into 2 lowest bits
				
				//For a sprite pixel to be drawn, it must be within the current window, not a 0 index color, and not over an existing sprite pixel
				if (xPixel > xLeft && xPixel < xRight && yPixel > yTop && yPixel < yBottom && twoBits != 0 && *sp == spriteAlphaColor) {
					*sp = paletteRGB[(whichPalette << 2) + twoBits];
				}
				sp++;
				temp <<= 2;										//Shift for next 2 bit color pair

			}
			
			tilePointer += lineYdir;			
			sp += (120 - 8);
			
		}		
	}

	//gpio_put(15, 0);

}	

//Draws a single 8x8 sprite at xPos/yPos using whichTile # from the pattern table, using whichpalette and flipped V/H if true 
void drawSprite(int xPos, int yPos, uint16_t whichTile, uint8_t whichPalette, bool hFlip, bool vFlip) {

	//gpio_put(15, 1);

	whichTile <<= 3;			//Multiple by 8
	
	int lineYdir = 1;			//Normal sprites
	int vFlipOffset = 0;
	
	if (vFlip) {				//Vertical flip
		lineYdir = -1;
		vFlipOffset = 7;
	}
		
	if (hFlip) {
		uint16_t *sp = &spriteBuffer[(yPos * 120) + xPos];    				  //Use pointer so less math later on
		uint16_t *tilePointer = &patternTable[whichTile + vFlipOffset];

		for (int yPixel = yPos ; yPixel < (yPos + 8) ; yPixel++) {

			uint16_t temp = *tilePointer;						//Get pointer for sprite tile

			for (int xPixel = xPos ; xPixel < (xPos + 8) ; xPixel++) {
				
				uint8_t twoBits = temp & 0x03;					//Get lowest 2 bits
				
				//For a sprite pixel to be drawn, it must be within the current window, not a 0 index color, and not over an existing sprite pixel
				if (xPixel > xLeft && xPixel < xRight && yPixel > yTop && yPixel < yBottom && twoBits != 0 && *sp == spriteAlphaColor) {
					*sp = paletteRGB[(whichPalette << 2) + twoBits];
				}
				sp++;
				temp >>= 2;										//Shift for next 2 bit color pair

			}
			
			tilePointer += lineYdir;			
			sp += (120 - 8);
			
		}		
	}
	else {
		uint16_t *sp = &spriteBuffer[(yPos * 120) + xPos];    				  //Use pointer so less math later on

		uint16_t *tilePointer = &patternTable[whichTile + vFlipOffset];

		for (int yPixel = yPos ; yPixel < (yPos + 8) ; yPixel++) {

			uint16_t temp = *tilePointer;										//Get pointer for sprite tile

			for (int xPixel = xPos ; xPixel < (xPos + 8) ; xPixel++) {
				
				uint8_t twoBits = temp >> 14;									//Smash this down into 2 lowest bits
				
				//For a sprite pixel to be drawn, it must be within the current window, not a 0 index color, and not over an existing sprite pixel
				if (xPixel > xLeft && xPixel < xRight && yPixel > yTop && yPixel < yBottom && twoBits != 0 && *sp == spriteAlphaColor) {
					*sp = paletteRGB[(whichPalette << 2) + twoBits];
				}
				sp++;
				temp <<= 2;										//Shift for next 2 bit color pair

			}
			
			tilePointer += lineYdir;			
			sp += (120 - 8);
			
		}		
	}

	//gpio_put(15, 0);

}	


//Wipes entire sprite buffer with the transparent color
void clearSprite() {
	
	for (int x = 0 ; x < 14400 ; x++) {   
		spriteBuffer[x] = spriteAlphaColor; //spriteAlphaColor;
	} 
//The sprite buffer is cleared as each frame is rendered so user doesn't need to run this every frame, it's best for setup/boot purposes
//Once frameDrawing == false you can be assured the sprite buffer has been cleared during render and is ready to be filled with the next frame of data	
}

//Converts the 2 bitplane YY-CHR NES graphics to chunky pixels in Pico memory (done on pattern load)
void convertBitplanePattern(uint16_t position, unsigned char *lowBitP, unsigned char *highBitP) {
	

	for (int xx = 0; xx < 8; xx++)              //Now convert each row of the char...
	{
		unsigned char lowBit = lowBitP[xx];            //Get temps
		unsigned char highBit = highBitP[xx];

		uint16_t tempShort = 0;

		for (int g = 0; g < 8; g++)              //2 bits at a time
		{
			unsigned char bits = ((lowBit & 0x80) >> 1) | (highBit & 0x80);		//Build 2 bits from 2 pairs of MSB in bytes (the bitplanes)
			
			lowBit <<= 1;
			highBit <<= 1;
			
			bits >>= 6;				//Shift into LSB
			
			tempShort <<= 2;		//Free up 2 bits at bottom
			
			tempShort |= bits;
		}
					
		patternTable[position++] = tempShort;                              //Put combined bitplane bytes as a short into buffer (we send this to new file)

	}

	
}
	
//Sets display rows to special functions (such as statis status bars or other effects)
void setWinYjump(int jumpFrom, int nextRow) {

	winYJumpList[jumpFrom] = 0x80 | nextRow;	
	
	//Gamebadge always draws 15 rows (top to bottom) of tile graphics (120 pixels wide x 8 tall)
	//This function allows you to set "freeze" functions on these rows. You can use this to create static (non-moving) status bars like Super Mario or Castlevania
	//The row values set here refer to the rows as displayed on the LCD, not whatever portion of the tile map is being shown per setWindow
	//This allows you to freeze rows, but still perform vertical and horizontal scrolls above or below it
	
	//Example usage:
	//Setup:
	//CHECK THIS BJH
	//setWinYjump(0, 1);			//Sets row 0 as static, jump to row 1
	//seyWinYjump(1, 2);			//Also sets row 1 as static, jump to row 2
	//setCoarseYRollover(2, 31);	//Tells the tilemap to scroll between rows 2 and 31 (excluding the top 2)
	
	//Per game frame:
	//setWindow(n, nn);				//Set overall scroll
	//setWindowSlice(0, 0);			//Freeze scroll of row 0
	//setWindowSlice(1, 0);			//Freeze scroll of row 1
	
	//Data written to the first upper left 2 rows (15 tiles wide) will be static, the rest of the display will scroll

	//To make a status bar at the bottom of the screen it's mostly the same but a little different:
	
	//Setup:
	//setWinYjump(13, 30);			//Sets row 13 as static, jump to row 30
	//seyWinYjump(14, 31);			//Sets row 14 as static, jump to row 31
	//setCoarseYRollover(0, 29);	//Tells the tilemap to scroll between rows 0 and 29 (excluding the bottom 2)

	//Per game frame:
	//setWindow(n, nn);				//Set overall scroll
	//setWindowSlice(30, 0);			//Freeze scroll of row 30
	//setWindowSlice(31, 0);			//Freeze scroll of row 31

	//In this example you'd draw your status bar at the bottom of the tilemap (rows 30 and 31) and these commands tell the display to
	//jump there on (rendered) rows 13 and 14. All tilemap rows below 30 will scroll normally
	
}

//Clears the row jumps set by setWinYjump
void clearWinYjump(int whichRow) {

	winYJumpList[whichRow] = 0;	
	
}

//Sets LCD window in which sprites can be drawn, 0, 119, 0, 119 = full screen (boot default)
void setSpriteWindow(uint8_t x0, uint8_t y0, uint8_t x1, uint8_t y1) {	

	xLeft = x0 - 1;
	xRight = x1 + 1;
	yTop = y0 - 1;
	yBottom = y1 + 1;	
//Use this to prevent sprites from drawing over static status bars (0, 119, 0, 103 to exclude the bottom 2 rows)

}	

//Sets the universal fine scroll window over the name table. Must be from 0-239, 0-239, when exceeding 239 you should "roll over" back to 0
void setWindow(uint8_t x, uint8_t y) {

	for (int g = 0 ; g < 32 ; g++) {
		
		winX[g] = x >> 3;
		winXfine[g] = x & 0x07;
		winY = y >> 3;
		winYfine = y & 0x07;		
		
	}	

}

//Allows each row (8 pixels high) of the tile map to be fine horizontally scrolled at different rates (like fake parallax scrolling)
void setWindowSlice(int whichRow, uint8_t x) {
	
		winX[whichRow] = x >> 3;
		winXfine[whichRow] = x & 0x07;	
		
//whichRow is 0-31, x is 0-239 like setWindow
//Use setWindow to set main window, then use this to control individual rows. For status displays, set their scroll to a fixed 0 so they don't move with rest of screen
	
}

//Sets which tile map rows are the bounderies for vertical scrolling rollover. 0-31 use whole nametable, 2-31, use top 2 rows as a static display, 0-29, use bottom 2 rows of a static display (see setWinYjump)
void setCoarseYRollover(int topRow, int bottomRow) {		//Sets at which row the nametable resets back to the top. If using bottom 2 rows as a status display
	
	winYreset = topRow;
	winYrollover = bottomRow;	

//When you scroll far enough down in the nametable where there isn't enough data to draw, it will "roll over" back to the top (just like the NES)
//This is why once you've scrolled 239 pixels left or right up or down you should reset your window back to 0
//But until you reach that limit, gamebadge will display the "rolled over" pixels. In the case of vertical scroll, which this function
//controls, once row 31 is drawn any additional rows on the display revert back to row 0 (rollover)
//By default the rollover uses the entire vertical display (32 rows) but if you're using static rows for status bars (in conjunction with setWinYjump) you'll want
//to use this function to change the rollover to only include valid background data (not status bars)

	
}

int lcdState = 0;
bool localFrameDrawFlag = false;
volatile bool lcdDMAcomplete = false;
bool isRendering = false;					//Render status flag 0 = null true = render in progress false = render complete

int whichBuffer = 0;						//We have 2 row buffers. We draw one, send via DMA, and draw next while DMA is running
int lastDMA = 5;							//Round-robin the DMA's

uint8_t fineYsubCount = 0;
uint8_t fineYpointer; // = winYfine;
uint8_t coarseY; // = winY;	
uint16_t *sp; // = &spriteBuffer[0];
uint8_t renderRow = 0;

uint8_t scrollYflag = 0;

bool LCDupdatePause = false;		

void pauseLCD(bool state) {					//Prevents the LCD from drawing a new frame (hold on old frame) Useful for loading new graphics/game transitions
	
	LCDupdatePause = state;
	
}

bool getRenderStatus() {							//Core0 calls this to see if rendering is done, and when done Core0 runs logic	
	return isRendering;
}

//State machine version of old sendFrame
void LCDlogic() {

	switch(lcdState) {
	
		case 0:										//Waiting for frame draw flag
			if (localFrameDrawFlag == true) {		//Flag set?
				localFrameDrawFlag = false;			//Always respond by clearing flag (even if we don't draw a new one because paused)			
				if (LCDupdatePause == false) {		//LCD paused? Don't render a new frame (if pause set during frame it will complete, then wait for flag clear before next)
					lcdState = 1;					//Advance to next state					
				}
			}
		break;
		
		case 1:							//Start LCD frame
			if (dma_channel_is_busy(lastDMA) == false) {		//if DMA is running, let it finish
				gpio_put(27, 1);				//For scope timing
				isRendering = true;
				st7789_setAddressWindow(0, 0, 240, 240);	//Set entire LCD for drawing
				st7789_ramwr();                       		//Switch to RAM writing mode dawg	

				fineYsubCount = 0;						//This is stuff we used to setup in sendframe
				fineYpointer = winYfine;
				coarseY = winY;	
				sp = &spriteBuffer[0];    				  //Use pointer so less math later on
				renderRow = 0;
				scrollYflag = 0;
				isRendering = 1;
				lcdState = 2;
			}
		break;
	
		case 2:											//Render 1 row (240x16 pixels, or 120x8 fat pixels)
			lcdRenderRow();
			lcdState = 3;								//Wait for DMA channel ready (since 14/15 times it will be sending the previous row)
		break;
		
		case 3:
			if (dma_channel_is_busy(lastDMA) == false) {		//DMA done sending previous row?

				if (++lastDMA > 6) {							//Toggle channels 5 and 6. Using same channel in series causes issues, not sure why? (something not cleared in time?)
					lastDMA = 5;
				}
		
				dmaLCD(lastDMA, &linebuffer[whichBuffer][0], 3840);			//Send the 240x16 pixels we just built to the LCD    

				if (++whichBuffer > 1) {							//Switch up buffers, we will draw the next while the prev is being DMA'd to LCD
					whichBuffer = 0;
				}				
				
				if (++renderRow == 15) {				//LCD done?
					isRendering = false;					//Render complete, wait for next draw flag (this keeps Core0 from drawing in screen
					lcdState = 0;	
					gpio_put(27, 0);
				}
				else {
					lcdState = 2;						//Not done? Render next row and wait for DMA
				}
				
			}
		break;
			
	}
	
	
}

void lcdRenderRow() {
	
	uint16_t temp;
	uint16_t tempPalette;	
	
	uint16_t *pointer = &linebuffer[whichBuffer][0];    		//Use pointer so less math later on

	//gpio_put(27, 1);

	if (winYJumpList[renderRow] & 0x80) {								//Flag to jump to a different row in the nametable? (like for a status bar)
		coarseY = winYJumpList[renderRow] & 0x1F;						//Jump to row indicated by bottom 5 bits								
		fineYpointer = 0;										//Reset fine pointer so any following rows are static
	}
	else {														//Not a jump line?
		if (scrollYflag == 0) {									//Is this first line with fine Y scroll enabled? (under a status bar at the top perhaps)
			scrollYflag = 1;									//Set flag so this only happens once
			fineYpointer = winYfine;							//Get Y scroll value
			coarseY = winY;
		}
	}

	for (int yLine = 0 ; yLine < 16; yLine++) {         			//Each char line is 16 pixels in ST7789 memory, so we send each vertical line twice

		uint8_t fineXPointer = winXfine[coarseY];							//Copy the fine scrolling amount so we can use it as a byte pointer when scanning in graphics
		uint16_t *tilePointer = &nameTable[coarseY][winX[coarseY]];			//Get pointer for this character line
		uint8_t winXtemp = winX[coarseY];									//Temp copy for finding edge of tilemap and rolling back over
		temp = patternTable[((*tilePointer & 0x00FF) << 3) + fineYpointer];	//Get first line of pattern		
		temp <<= (fineXPointer << 1);							//Pre-shift for horizontal scroll

		tempPalette = (*tilePointer & 0x700) >> 6;				//Palette is lower 3 bits of upper word. Mask and shift 6 to the right to get the palette index 0bxxxPPPbb P = palette pointer b = bits (the 4 colors per palette)

		if (yLine & 0x01) {										//Drawing odd line on LCD/second line of fat pixels?							
			sp -= 120;											//Revert sprite buffer point to draw every line twice
			for (int xChar = 0 ; xChar < 120 ; xChar++) {      	//15 characters wide
			
				uint8_t twoBits = temp >> 14;					//Smash this down into 2 lowest bits
				if (*sp == spriteAlphaColor) {							//Transparent sprite pixel? Draw background color...	
					uint16_t tempShort = paletteRGB[tempPalette | twoBits];	//Add those 2 bits to palette index to get color (0-3)
					//uint16_t tempShort = paletteRGB[(*tilePointer >> 8) | twoBits];	//Add those 2 bits to palette index to get color (0-3)				
					*pointer++ = tempShort;						//...twice (fat pixels)
					*pointer++ = tempShort;		
				}
				else{                							//Else draw sprite pixel...
					*pointer++ = *sp;							//..twice (fat pixels)
					*pointer++ = *sp;	
				}
				*sp = spriteAlphaColor;									//When rendering the doubled sprite line, erase it so it's empty for next frame
				sp++;
				temp <<= 2;										//Shift for next 2 bit color pair

				if (++fineXPointer == 8) {						//Advance fine scroll count and jump to next char if needed
					fineXPointer = 0;
					tilePointer++;								//Advance tile pointer in memory
					if (++winXtemp == 32) {						//Rollover edge of tiles X?
						tilePointer -= 32;						//Roll tile X pointer back 32
					}				
					temp = patternTable[((*tilePointer & 0x00FF) << 3) + fineYpointer];		//Fetch next line from pattern table
					tempPalette = (*tilePointer & 0x700) >> 6;				//Palette is lower 3 bits of upper word. Mask and shift 6 to the right to get the palette index 0bxxxPPPbb P = palette pointer b = bits (the 4 colors per palette)

				}				
			}				
		}
		else {
			for (int xChar = 0 ; xChar < 120 ; xChar++) {      	//15 characters wide
			
				uint8_t twoBits = temp >> 14;					//Smash this down into 2 lowest bits
				if (*sp == spriteAlphaColor) {							//Transparent sprite pixel? Draw background color...
					uint16_t tempShort = paletteRGB[tempPalette | twoBits];	//Add those 2 bits to palette index to get color (0-3)
					//uint16_t tempShort = paletteRGB[(*tilePointer >> 8) | twoBits];	//Add those 2 bits to palette index to get color (0-3)				
					*pointer++ = tempShort;						//...twice (fat pixels)
					*pointer++ = tempShort;		
				}
				else{                							//Else draw sprite pixel...
					*pointer++ = *sp;							//..twice (fat pixels)
					*pointer++ = *sp;	
				}
				sp++;
				temp <<= 2;										//Shift for next 2 bit color pair

				if (++fineXPointer == 8) {						//Advance fine scroll count and jump to next char if needed
					fineXPointer = 0;
					tilePointer++;								//Advance tile pointer in memory
					if (++winXtemp == 32) {						//Rollover edge of tiles X?
						tilePointer -= 32;						//Roll tile X pointer back 32
					}
					temp = patternTable[((*tilePointer & 0x00FF) << 3) + fineYpointer];		//Fetch next line from pattern table
					tempPalette = (*tilePointer & 0x700) >> 6;				//Palette is lower 3 bits of upper word. Mask and shift 6 to the right to get the palette index 0bxxxPPPbb P = palette pointer b = bits (the 4 colors per palette)

				}				
			}								
		}

		if (++fineYsubCount > 1) {
			fineYsubCount = 0;		
			if (++fineYpointer == 8) {						//Did we pass a character edge with the fine Y scroll?
				fineYpointer = 0;							//Reset scroll and advance character
				if (++coarseY > winYrollover) {
					coarseY = winYreset;
				}				
			}					
		}
	}

	//gpio_put(27, 0);

	//Row drawn, now wait for DMA to open up
	
}

void LCDsetDrawFlag() {					//Call this to tell the LCD core to draw next frame

	localFrameDrawFlag = true;
	
}

//Used by sendFrame to send 240x16 pixels to the ST7789 one row at a time. As the previous row is DMA'd to LCD the next row is drawn - efficient!
void dmaLCD(int whatChannel, const void* data, int whatSize) {

    dma_channel_unclaim(whatChannel);
    dma_channel_config c = dma_channel_get_default_config(whatChannel);
	channel_config_set_high_priority(&c, true);
    channel_config_set_transfer_data_size(&c, DMA_SIZE_16);
    channel_config_set_dreq(&c, spi_get_dreq(spi0, true));
    
    dma_channel_configure(whatChannel, &c,
                          &spi_get_hw(spi0)->dr, // write address
                          data, // read address
                          whatSize, // element count (each element is of size transfer_data_size)
                          false); // don't start yet

    dma_start_channel_mask((1u << whatChannel));

	// if (whatChannel == 5) {
		// gpio_put(27, 1);
	// }
	// else {
		// gpio_put(15, 1);	
	// }

}


//Renders tiles and sprites and DMA's the data to the ST7789 LCD. Takes about 15ms. Core0 can do other stuff while this happens, as long as it doesn't access video memory (else tearing can occur)
void sendFrame() {								//This is executed by Core1. Core0 can do other stuff during this time
	
	st7789_setAddressWindow(0, 0, 240, 240);	//Set entire LCD for drawing
	st7789_ramwr();                       		//Switch to RAM writing mode dawg

	int whichBuffer = 0;						//We have 2 row buffers. We draw one, send via DMA, and draw next while DMA is running

	uint16_t temp;
	uint16_t tempPalette;
	
	uint8_t fineYsubCount = 0;
	uint8_t fineYpointer; // = winYfine;
	uint8_t coarseY; // = winY;	
	uint16_t *sp = &spriteBuffer[0];    				  //Use pointer so less math later on

	uint8_t scrollYflag = 0;						      //

	for (int row = 0 ; row < 15 ; row++) {				  //15 rows of 8x8 fat pixels (16x16)

		uint16_t *pointer = &linebuffer[whichBuffer][0];    		//Use pointer so less math later on
		
		// if (whichBuffer == 0) {										//Scope testing row render time
			// gpio_put(15, 1);
		// }
		// else {
			// gpio_put(27, 1);
		// }

		if (winYJumpList[row] & 0x80) {								//Flag to jump to a different row in the nametable? (like for a status bar)
			coarseY = winYJumpList[row] & 0x1F;						//Jump to row indicated by bottom 5 bits								
			fineYpointer = 0;										//Reset fine pointer so any following rows are static
		}
		else {														//Not a jump line?
			if (scrollYflag == 0) {									//Is this first line with fine Y scroll enabled? (under a status bar at the top perhaps)
				scrollYflag = 1;									//Set flag so this only happens once
				fineYpointer = winYfine;							//Get Y scroll value
				coarseY = winY;
			}
		}

		for (int yLine = 0 ; yLine < 16; yLine++) {         			//Each char line is 16 pixels in ST7789 memory, so we send each vertical line twice

			uint8_t fineXPointer = winXfine[coarseY];							//Copy the fine scrolling amount so we can use it as a byte pointer when scanning in graphics
			uint16_t *tilePointer = &nameTable[coarseY][winX[coarseY]];			//Get pointer for this character line
			uint8_t winXtemp = winX[coarseY];									//Temp copy for finding edge of tilemap and rolling back over
			temp = patternTable[((*tilePointer & 0x00FF) << 3) + fineYpointer];	//Get first line of pattern		
			temp <<= (fineXPointer << 1);							//Pre-shift for horizontal scroll

			tempPalette = (*tilePointer & 0x700) >> 6;				//Palette is lower 3 bits of upper word. Mask and shift 6 to the right to get the palette index 0bxxxPPPbb P = palette pointer b = bits (the 4 colors per palette)

			if (yLine & 0x01) {										//Drawing odd line on LCD/second line of fat pixels?							
				sp -= 120;											//Revert sprite buffer point to draw every line twice
				for (int xChar = 0 ; xChar < 120 ; xChar++) {      	//15 characters wide
				
					uint8_t twoBits = temp >> 14;					//Smash this down into 2 lowest bits
					if (*sp == spriteAlphaColor) {							//Transparent sprite pixel? Draw background color...	
						uint16_t tempShort = paletteRGB[tempPalette | twoBits];	//Add those 2 bits to palette index to get color (0-3)
						//uint16_t tempShort = paletteRGB[(*tilePointer >> 8) | twoBits];	//Add those 2 bits to palette index to get color (0-3)				
						*pointer++ = tempShort;						//...twice (fat pixels)
						*pointer++ = tempShort;		
					}
					else{                							//Else draw sprite pixel...
						*pointer++ = *sp;							//..twice (fat pixels)
						*pointer++ = *sp;	
					}
					*sp = spriteAlphaColor;									//When rendering the doubled sprite line, erase it so it's empty for next frame
					sp++;
					temp <<= 2;										//Shift for next 2 bit color pair

					if (++fineXPointer == 8) {						//Advance fine scroll count and jump to next char if needed
						fineXPointer = 0;
						tilePointer++;								//Advance tile pointer in memory
						if (++winXtemp == 32) {						//Rollover edge of tiles X?
							tilePointer -= 32;						//Roll tile X pointer back 32
						}				
						temp = patternTable[((*tilePointer & 0x00FF) << 3) + fineYpointer];		//Fetch next line from pattern table
						tempPalette = (*tilePointer & 0x700) >> 6;				//Palette is lower 3 bits of upper word. Mask and shift 6 to the right to get the palette index 0bxxxPPPbb P = palette pointer b = bits (the 4 colors per palette)

					}				
				}				
			}
			else {
				for (int xChar = 0 ; xChar < 120 ; xChar++) {      	//15 characters wide
				
					uint8_t twoBits = temp >> 14;					//Smash this down into 2 lowest bits
					if (*sp == spriteAlphaColor) {							//Transparent sprite pixel? Draw background color...
						uint16_t tempShort = paletteRGB[tempPalette | twoBits];	//Add those 2 bits to palette index to get color (0-3)
						//uint16_t tempShort = paletteRGB[(*tilePointer >> 8) | twoBits];	//Add those 2 bits to palette index to get color (0-3)				
						*pointer++ = tempShort;						//...twice (fat pixels)
						*pointer++ = tempShort;		
					}
					else{                							//Else draw sprite pixel...
						*pointer++ = *sp;							//..twice (fat pixels)
						*pointer++ = *sp;	
					}
					sp++;
					temp <<= 2;										//Shift for next 2 bit color pair

					if (++fineXPointer == 8) {						//Advance fine scroll count and jump to next char if needed
						fineXPointer = 0;
						tilePointer++;								//Advance tile pointer in memory
						if (++winXtemp == 32) {						//Rollover edge of tiles X?
							tilePointer -= 32;						//Roll tile X pointer back 32
						}
						temp = patternTable[((*tilePointer & 0x00FF) << 3) + fineYpointer];		//Fetch next line from pattern table
						tempPalette = (*tilePointer & 0x700) >> 6;				//Palette is lower 3 bits of upper word. Mask and shift 6 to the right to get the palette index 0bxxxPPPbb P = palette pointer b = bits (the 4 colors per palette)

					}				
				}								
			}
	
			if (++fineYsubCount > 1) {
				fineYsubCount = 0;		
				if (++fineYpointer == 8) {						//Did we pass a character edge with the fine Y scroll?
					fineYpointer = 0;							//Reset scroll and advance character
					if (++coarseY > winYrollover) {
						coarseY = winYreset;
					}				
				}					
			}
		}

		// gpio_put(15, 0);			//Scope testing row render time
		// gpio_put(27, 0);
		
		dmaX(5, &linebuffer[whichBuffer][0], 3840);			//Send the 240x16 pixels we just built to the LCD    

		if (++whichBuffer > 1) {							//Switch up buffers, we will draw the next while the prev is being DMA'd to LCD
			whichBuffer = 0;
		}		
	}	
}

//Used by sendFrame to send 240x16 pixels to the ST7789 one row at a time. As the previous row is DMA'd to LCD the next row is drawn - efficient!
void dmaX(int whatChannel, const void* data, int whatSize) {

    while(dma_channel_is_busy(whatChannel) == true) {}

    dma_channel_unclaim(whatChannel);
    dma_channel_config c = dma_channel_get_default_config(whatChannel);
	channel_config_set_high_priority(&c, true);
    channel_config_set_transfer_data_size(&c, DMA_SIZE_16);
    channel_config_set_dreq(&c, spi_get_dreq(spi0, true));
    
    dma_channel_configure(whatChannel, &c,
                          &spi_get_hw(spi0)->dr, // write address
                          data, // read address
                          whatSize, // element count (each element is of size transfer_data_size)
                          false); // don't start yet

    dma_start_channel_mask((1u << whatChannel));

	// gpio_put(15, 1);
	// dma_channel_set_irq0_enabled(0, true);
	// irq_set_exclusive_handler(DMA_IRQ_0, dma_handler0);
	// irq_set_enabled(DMA_IRQ_0, true);      

}

//Plays a 11025Hz 8-bit mono WAVE file from file system using the PWM function and DMA on GPIO14 (gamebadge channel 4)
void playAudio(const char* path, int newPriority) {
	
	if (audioPlaying == true) {			//Only one sound at a time
		//file.close();
		
		if (newPriority >= currentAudioPriority) {
			stopAudio();
		}
		else {
			return;
		}
	}
	
	if (!file.open(path, O_RDONLY)) {	//Abort if Don Bot's mercy file isn't found
		return;
	}

	file.seekSet(40);				    //Jump to audio sample size part of WAVE file

	audioSamples = file.read() | (file.read() << 8) | (file.read() << 16) | (file.read() << 24);	//Get # of samples
	
	fillAudioBuffer(0);							//Fill both buffers to start
	fillAudioBuffer(1);

	whichAudioBuffer = 0;						//DMA starts with buffer 0
	audioPlaying = true;						//Flag that audio is playing

	endAudioBuffer0flag =  false;
	endAudioBuffer1flag =  false;
	fillBuffer0flag = false;
	fillBuffer1flag = false;

	dmaAudio();									//Start the audio DMA

}

void stopAudio() {

	if (audioPlaying == false) {
		return;
	}

	file.close();	
	
	//Kill interrupts and channels
	dma_hw->ints0 = (1u << 2);
	dma_channel_abort(2);			//Kill the other channel
	dma_hw->ints0 = (1u << 1);
	dma_channel_abort(1);			//Kill the other channel
	
}

void serviceAudio() {					//This is called every game frame to see if PCM audio buffers need re-loading

	if (audioPlaying == false) {
		return;
	}
	
	if (fillBuffer0flag == true) {
		fillBuffer0flag = false;
		endAudioBuffer0flag = fillAudioBuffer(0);			//Fill buffer and return flag if we loaded the last of data
	}
	if (fillBuffer1flag == true) {
		fillBuffer1flag = false;
		endAudioBuffer1flag = fillAudioBuffer(1);			//Fill buffer and return flag if we loaded the last of data
	}	
	
}

bool fillAudioBuffer(int whichOne) {

	int samplesToLoad = audioBufferSize;			//Default # of samples to load into buffer

	//What if samples on 512 edge?

	//gpio_put(15, 1);

	if (audioSamples < audioBufferSize) {			//Are there fewer samples than a full buffer size?
		samplesToLoad = audioSamples;	
	}

	if (whichOne == 0) {							//Load selected buffer
		for (int x = 0 ; x < samplesToLoad ; x++) {
			audioBuffer0[x] = file.read();
		}
		
		
		//file.read(audioBuffer0, samplesToLoad);
	}
	else {
		for (int x = 0 ; x < samplesToLoad ; x++) {
			audioBuffer1[x] = file.read();
		}		
		
		//file.read(audioBuffer1, samplesToLoad);
	}
	
	//gpio_put(15, 0);
	
	if (samplesToLoad < audioBufferSize) {			//Not a full buffer? Means end of file, this is final DMA to do		
		audioSamples = 0;							//Zero this out
		file.close();								//Close file		
		dma_channel_set_trans_count(whichOne, samplesToLoad, false);	//When this channel re-triggers only beat out the exact # of bytes we have
		dma_channel_config object = dma_channel_get_default_config(whichOne + 1);		//Get reference object for channel	
		channel_config_set_chain_to(&object, whichOne + 1);		//Set this channel to chain to itself next time it finishes, which disables chaining
		return true;
	}
	
	audioSamples -= samplesToLoad;				//Else dec # of samples and return no flag

	return false;

}

void dmaAudio() {

    dma_channel_unclaim(1);
	
    dma_channel_config c0 = dma_channel_get_default_config(1);
    channel_config_set_transfer_data_size(&c0, DMA_SIZE_32);
    channel_config_set_read_increment(&c0, true);
    channel_config_set_write_increment(&c0, false);	
	
    dma_timer_set_fraction(0, 0x0006, 0xffff);			//The timer will run at the system_clock_freq * numerator / denominator, so this is the speed that data elements will be transferred at via a DMA channel using this timer as a DREQ
    channel_config_set_dreq(&c0, 0x3b);                                 // DREQ paced by timer 0     // 0x3b means timer0 (see SDK manual)
	channel_config_set_chain_to(&c0, 2); 
	
	
    dma_channel_configure(1,
						  &c0,
						  &pwm_hw->slice[audio_pin_slice].cc,			//dst
                          audioBuffer0,   // src
                          audioBufferSize,  // transfer count
                          false           // Do not start immediately
    );

	dma_channel_set_irq0_enabled(1, true);
	irq_set_exclusive_handler(DMA_IRQ_0, dma_handler_buffer0);
	irq_set_enabled(DMA_IRQ_0, true);   

    dma_channel_unclaim(2);
	
    dma_channel_config c1 = dma_channel_get_default_config(2);
    channel_config_set_transfer_data_size(&c1, DMA_SIZE_32);
    channel_config_set_read_increment(&c1, true);
    channel_config_set_write_increment(&c1, false);	
    channel_config_set_dreq(&c1, 0x3b);                                 // DREQ paced by timer 0     // 0x3b means timer0 (see SDK manual)
	channel_config_set_chain_to(&c1, 1); 
	
    dma_channel_configure(2,
							&c1,
							&pwm_hw->slice[audio_pin_slice].cc,			//dst
							audioBuffer1,   // src
							audioBufferSize,  // transfer count
							false           // Do not start immediately
    );

	dma_channel_set_irq1_enabled(2, true);
	irq_set_exclusive_handler(DMA_IRQ_1, dma_handler_buffer1);
	irq_set_enabled(DMA_IRQ_1, true);  


    dma_start_channel_mask(1u << 1);
	
	
}

static void dma_handler_buffer0() {		//This is called when DMA audio block0 finishes

	if (endAudioBuffer0flag == true) {	
		endAudioBuffer0flag = false;
		audioPlaying =  false;
		pwm_set_gpio_level(14, 128);
		dma_channel_abort(2);			//Kill the other channel
	}
	else {
		dma_channel_set_read_addr(1, audioBuffer0, false);
		fillBuffer0flag = true;						//Set flag that buffer needs re-filled while other DMA runs		
	}

    // Clear interrupt for trigger DMA channel.
    dma_hw->ints0 = (1u << 1);
    
}

static void dma_handler_buffer1() {     //This is called when DMA audio block1 finishes

	if (endAudioBuffer1flag == true) {
		endAudioBuffer1flag = false;
		audioPlaying =  false;
		pwm_set_gpio_level(14, 128);
		dma_channel_abort(1);			//Kill the other channel
	}
	else {
		dma_channel_set_read_addr(2, audioBuffer1, false);
		fillBuffer1flag = true;						//Set flag that buffer needs re-filled while other DMA runs		
	}
    // Clear interrupt for trigger DMA channel.
    dma_hw->ints0 = (1u << 2);
    
}


//File system stuff-----------for loading/saving levels etc--------------------------------
bool checkFile(const char* path) {

	if (file.exists(path)) {
		return true;
	}
	else {
		return false;
	}	
	
}

void saveFile(const char* path) {					//Opens a file for saving. Deletes the file if it already exists (write-over)

	file.remove(path);
	file.open(path, O_WRITE | O_CREAT);				//Open file for writing	
	fileActive = true;
	
}

bool loadFile(const char* path) {					//Opens a file for loading
	
	if (file.open(path, O_RDONLY) == false) {
		return false;
	}

	fileActive = true;
	
	return true;
	
}

void writeByte(uint8_t theByte) {					//Writes a byte to current file
	
	file.write(theByte);
	
}

void writeBool(bool state) {

	if (state == true) {
		writeByte(1);
	}
	else {
		writeByte(0);
	}	
	
}	

uint8_t readByte() {								//Reads a byte from the file
	
	return file.read();
	
}

bool readBool() {

	if (file.read() == 1) {
		return true;
	}
	
	return false;
	
}


void closeFile() {									//Closes the active file

	file.close();
	fileActive = false;
	
}

void eraseFile(const char* path) {

	file.open(path, O_WRITE | O_CREAT);				//Open file for writing	
	file.remove();	

}

//Callbacks for the USB Mass Storage Device-----------------------------------------------
int32_t msc_read_cb (uint32_t lba, void* buffer, uint32_t bufsize) {
// Callback invoked when received READ10 command.
// Copy disk's data to buffer (up to bufsize) and 
// return number of copied bytes (must be multiple of block size) 	
	
  // Note: SPIFLash Block API: readBlocks/writeBlocks/syncBlocks
  // already include 4K sector caching internally. We don't need to cache it, yahhhh!!
  return flash.readBlocks(lba, (uint8_t*) buffer, bufsize/512) ? bufsize : -1;
}

int32_t msc_write_cb (uint32_t lba, uint8_t* buffer, uint32_t bufsize) {
	
// Callback invoked when received WRITE10 command.
// Process data in buffer to disk's storage and 
// return number of written bytes (must be multiple of block size)	
  digitalWrite(LED_BUILTIN, HIGH);

  // Note: SPIFLash Block API: readBlocks/writeBlocks/syncBlocks
  // already include 4K sector caching internally. We don't need to cache it, yahhhh!!
  return flash.writeBlocks(lba, buffer, bufsize/512) ? bufsize : -1;
}

void msc_flush_cb (void) {
	
// Callback invoked when WRITE10 command is completed (status received and accepted by host).
// used to flush any pending cache.
	
  flash.syncBlocks();  // sync with flash
  fatfs.cacheClear();  // clear file system's cache to force refresh

  digitalWrite(LED_BUILTIN, LOW);
}

/*********************************************************************
 Adafruit invests time and resources providing this open source code,
 please support Adafruit and open-source hardware by purchasing
 products from Adafruit!

 MIT license, check LICENSE for more information
 Copyright (c) 2019 Ha Thach for Adafruit Industries
 All text above, and the splash screen below must be included in
 any redistribution
*********************************************************************/

/* This example demo how to expose on-board external Flash as USB Mass Storage.
 * Following library is required
 *   - Adafruit_SPIFlash https://github.com/adafruit/Adafruit_SPIFlash
 *   - SdFat https://github.com/adafruit/SdFat
 *
 * Note: Adafruit fork of SdFat enabled ENABLE_EXTENDED_TRANSFER_CLASS and FAT12_SUPPORT
 * in SdFatConfig.h, which is needed to run SdFat on external flash. You can use original
 * SdFat library and manually change those macros
 *
 * Note2: If your flash is not formatted as FAT12 previously, you could format it using
 * follow sketch https://github.com/adafruit/Adafruit_SPIFlash/tree/master/examples/SdFat_format
 */
