benheck/gamebadge3/code/Arduino libraries/gameBadgePico/flash_font.c

/* http://srecord.sourceforge.net/ */
const unsigned char flashFont[] =
{
0x00, 0x00, 0x00, 0x00, 0x00, 0x00, 0x00, 0x00, 0x00, 0x00, 0x00, 0x00,
0x00, 0x00, 0x00, 0x00, 0x00, 0x18, 0x3C, 0x66, 0x66, 0x7E, 0x66, 0x00,
0x00, 0x18, 0x3C, 0x66, 0x66, 0x7E, 0x66, 0x00, 0x00, 0x7C, 0x66, 0x7C,
0x66, 0x66, 0x7C, 0x00, 0x00, 0x7C, 0x66, 0x7C, 0x66, 0x66, 0x7C, 0x00,
0x00, 0x3C, 0x66, 0x60, 0x60, 0x66, 0x3C, 0x00, 0x00, 0x3C, 0x66, 0x60,
0x60, 0x66, 0x3C, 0x00, 0x00, 0x78, 0x6C, 0x66, 0x66, 0x6C, 0x78, 0x00,
0x00, 0x78, 0x6C, 0x66, 0x66, 0x6C, 0x78, 0x00, 0x00, 0x7E, 0x60, 0x7C,
0x60, 0x60, 0x7E, 0x00, 0x00, 0x7E, 0x60, 0x7C, 0x60, 0x60, 0x7E, 0x00,
0x00, 0x7E, 0x60, 0x7C, 0x60, 0x60, 0x60, 0x00, 0x00, 0x7E, 0x60, 0x7C,
0x60, 0x60, 0x60, 0x00, 0x00, 0x3E, 0x60, 0x60, 0x6E, 0x66, 0x3E, 0x00,
0x00, 0x3E, 0x60, 0x60, 0x6E, 0x66, 0x3E, 0x00, 0x00, 0x66, 0x66, 0x7E,
0x66, 0x66, 0x66, 0x00, 0x00, 0x66, 0x66, 0x7E, 0x66, 0x66, 0x66, 0x00,
0x00, 0x7E, 0x18, 0x18, 0x18, 0x18, 0x7E, 0x00, 0x00, 0x7E, 0x18, 0x18,
0x18, 0x18, 0x7E, 0x00, 0x00, 0x06, 0x06, 0x06, 0x06, 0x66, 0x3C, 0x00,
0x00, 0x06, 0x06, 0x06, 0x06, 0x66, 0x3C, 0x00, 0x00, 0x66, 0x6C, 0x78,
0x78, 0x6C, 0x66, 0x00, 0x00, 0x66, 0x6C, 0x78, 0x78, 0x6C, 0x66, 0x00,
0x00, 0x60, 0x60, 0x60, 0x60, 0x60, 0x7E, 0x00, 0x00, 0x60, 0x60, 0x60,
0x60, 0x60, 0x7E, 0x00, 0x00, 0x63, 0x77, 0x7F, 0x6B, 0x63, 0x63, 0x00,
0x00, 0x63, 0x77, 0x7F, 0x6B, 0x63, 0x63, 0x00, 0x00, 0x66, 0x76, 0x7E,
0x7E, 0x6E, 0x66, 0x00, 0x00, 0x66, 0x76, 0x7E, 0x7E, 0x6E, 0x66, 0x00,
0x00, 0x3C, 0x66, 0x66, 0x66, 0x66, 0x3C, 0x00, 0x00, 0x3C, 0x66, 0x66,
0x66, 0x66, 0x3C, 0x00, 0x00, 0x7C, 0x66, 0x66, 0x7C, 0x60, 0x60, 0x00,
0x00, 0x7C, 0x66, 0x66, 0x7C, 0x60, 0x60, 0x00, 0x00, 0x3C, 0x66, 0x66,
0x66, 0x6C, 0x36, 0x00, 0x00, 0x3C, 0x66, 0x66, 0x66, 0x6C, 0x36, 0x00,
0x00, 0x7C, 0x66, 0x66, 0x7C, 0x6C, 0x66, 0x00, 0x00, 0x7C, 0x66, 0x66,
0x7C, 0x6C, 0x66, 0x00, 0x00, 0x3C, 0x60, 0x3C, 0x06, 0x06, 0x3C, 0x00,
0x00, 0x3C, 0x60, 0x3C, 0x06, 0x06, 0x3C, 0x00, 0x00, 0x7E, 0x18, 0x18,
0x18, 0x18, 0x18, 0x00, 0x00, 0x7E, 0x18, 0x18, 0x18, 0x18, 0x18, 0x00,
0x00, 0x66, 0x66, 0x66, 0x66, 0x66, 0x7E, 0x00, 0x00, 0x66, 0x66, 0x66,
0x66, 0x66, 0x7E, 0x00, 0x00, 0x66, 0x66, 0x66, 0x66, 0x3C, 0x18, 0x00,
0x00, 0x66, 0x66, 0x66, 0x66, 0x3C, 0x18, 0x00, 0x00, 0x63, 0x63, 0x6B,
0x7F, 0x77, 0x63, 0x00, 0x00, 0x63, 0x63, 0x6B, 0x7F, 0x77, 0x63, 0x00,
0x00, 0x66, 0x66, 0x3C, 0x3C, 0x66, 0x66, 0x00, 0x00, 0x66, 0x66, 0x3C,
0x3C, 0x66, 0x66, 0x00, 0x00, 0x66, 0x66, 0x3C, 0x18, 0x18, 0x18, 0x00,
0x00, 0x66, 0x66, 0x3C, 0x18, 0x18, 0x18, 0x00, 0x00, 0x7E, 0x0C, 0x18,
0x30, 0x60, 0x7E, 0x00, 0x00, 0x7E, 0x0C, 0x18, 0x30, 0x60, 0x7E, 0x00,
0x00, 0x1E, 0x18, 0x18, 0x18, 0x18, 0x1E, 0x00, 0x00, 0x1E, 0x18, 0x18,
0x18, 0x18, 0x1E, 0x00, 0x00, 0x40, 0x60, 0x30, 0x18, 0x0C, 0x06, 0x00,
0x00, 0x40, 0x60, 0x30, 0x18, 0x0C, 0x06, 0x00, 0x00, 0x78, 0x18, 0x18,
0x18, 0x18, 0x78, 0x00, 0x00, 0x78, 0x18, 0x18, 0x18, 0x18, 0x78, 0x00,
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
};
const unsigned long flashFont_termination = 0x00000000;
const unsigned long flashFont_start       = 0x00000000;
const unsigned long flashFont_finish      = 0x00000200;
const unsigned long flashFont_length      = 0x00000200;

#define FLASHFONT_TERMINATION 0x00000000
#define FLASHFONT_START       0x00000000
#define FLASHFONT_FINISH      0x00000200
#define FLASHFONT_LENGTH      0x00000200
