benheck/gamebadge3/code/Arduino libraries/gameBadgePico/flash_font.h

#ifndef FLASH_FONT_H
#define FLASH_FONT_H

extern const unsigned long flashFont_termination;
extern const unsigned long flashFont_start;
extern const unsigned long flashFont_finish;
extern const unsigned long flashFont_length;
extern const unsigned char flashFont[];

#endif /* FLASH_FONT_H */
