benheck/gamebadge3/code/utilities and test code/msc_external_flash/msc_external_flash.ino

/*********************************************************************
 Adafruit invests time and resources providing this open source code,
 please support Adafruit and open-source hardware by purchasing
 products from Adafruit!

 MIT license, check LICENSE for more information
 Copyright (c) 2019 Ha Thach for Adafruit Industries
 All text above, and the splash screen below must be included in
 any redistribution
*********************************************************************/

/* This example demo how to expose on-board external Flash as USB Mass Storage.
 * Following library is required
 *   - Adafruit_SPIFlash https://github.com/adafruit/Adafruit_SPIFlash
 *   - SdFat https://github.com/adafruit/SdFat
 *
 * Note: Adafruit fork of SdFat enabled ENABLE_EXTENDED_TRANSFER_CLASS and FAT12_SUPPORT
 * in SdFatConfig.h, which is needed to run SdFat on external flash. You can use original
 * SdFat library and manually change those macros
 *
 * Note2: If your flash is not formatted as FAT12 previously, you could format it using
 * follow sketch https://github.com/adafruit/Adafruit_SPIFlash/tree/master/examples/SdFat_format
 */

#include "SPI.h"
#include "SdFat.h"
#include "Adafruit_SPIFlash.h"
#include "Adafruit_TinyUSB.h"

char line[128];

// Un-comment to run example with custom SPI SPI and SS e.g with FRAM breakout
// #define CUSTOM_CS   A5
// #define CUSTOM_SPI  SPI

#if defined(CUSTOM_CS) && defined(CUSTOM_SPI)
  Adafruit_FlashTransport_SPI flashTransport(CUSTOM_CS, CUSTOM_SPI);

#elif defined(ARDUINO_ARCH_ESP32)
  // ESP32 use same flash device that store code.
  // Therefore there is no need to specify the SPI and SS
  Adafruit_FlashTransport_ESP32 flashTransport;

#elif defined(ARDUINO_ARCH_RP2040)
  // RP2040 use same flash device that store code.
  // Therefore there is no need to specify the SPI and SS
  // Use default (no-args) constructor to be compatible with CircuitPython partition scheme
  Adafruit_FlashTransport_RP2040 flashTransport;

  // For generic usage:
  //    Adafruit_FlashTransport_RP2040 flashTransport(start_address, size)
  // If start_address and size are both 0, value that match filesystem setting in
  // 'Tools->Flash Size' menu selection will be used

#else
  // On-board external flash (QSPI or SPI) macros should already
  // defined in your board variant if supported
  // - EXTERNAL_FLASH_USE_QSPI
  // - EXTERNAL_FLASH_USE_CS/EXTERNAL_FLASH_USE_SPI
  #if defined(EXTERNAL_FLASH_USE_QSPI)
    Adafruit_FlashTransport_QSPI flashTransport;

  #elif defined(EXTERNAL_FLASH_USE_SPI)
    Adafruit_FlashTransport_SPI flashTransport(EXTERNAL_FLASH_USE_CS, EXTERNAL_FLASH_USE_SPI);

  #else
    #error No QSPI/SPI flash are defined on your board variant.h !
  #endif
#endif

Adafruit_SPIFlash flash(&flashTransport);

// file system object from SdFat
FatFileSystem fatfs;

FatFile root;
FatFile file;

// USB Mass Storage object
Adafruit_USBD_MSC usb_msc;

// Check if flash is formatted
bool fs_formatted;

// Set to true when PC write to flash
bool fs_changed;

// the setup function runs once when you press reset or power the board
void setup()
{
  pinMode(LED_BUILTIN, OUTPUT);

  flash.begin();

  // Set disk vendor id, product id and revision with string up to 8, 16, 4 characters respectively
  usb_msc.setID("Adafruit", "External Flash", "1.0");

  // Set callback
  usb_msc.setReadWriteCallback(msc_read_cb, msc_write_cb, msc_flush_cb);

  // Set disk size, block size should be 512 regardless of spi flash page size
  usb_msc.setCapacity(flash.size()/512, 512);

  // MSC is ready for read/write
  usb_msc.setUnitReady(true);

  usb_msc.begin();

  // Init file system on the flash
  fs_formatted = fatfs.begin(&flash);

  Serial.begin(115200);
  //while ( !Serial ) delay(10);   // wait for native usb

  if ( !fs_formatted )
  {
    Serial.println("Failed to init files system, flash may not be formatted");
  }

  Serial.println("Adafruit TinyUSB Mass Storage External Flash example");
  Serial.print("JEDEC ID: 0x"); Serial.println(flash.getJEDECID(), HEX);
  Serial.print("Flash size: "); Serial.print(flash.size() / 1024); Serial.println(" KB");

  fs_changed = true; // to print contents initially
}

void loop()
{

  if ( fs_changed )
  {
    fs_changed = false;

    // check if host formatted disk
    if (!fs_formatted)
    {
      fs_formatted = fatfs.begin(&flash);
    }

    // skip if still not formatted
    if (!fs_formatted) return;

    Serial.println("Opening root");

    if ( !root.open("/") )
    {
      Serial.println("open root failed");
      return;
    }

    Serial.println("Flash contents:");

    // Open next file in root.
    // Warning, openNext starts at the current directory position
    // so a rewind of the directory may be required.
    while ( file.openNext(&root, O_RDONLY) )
    {
      file.printFileSize(&Serial);
      Serial.write(' ');
      file.printName(&Serial);
      if ( file.isDir() )
      {
        // Indicate a directory.
        Serial.write('/');
      }
    
      Serial.println();
      file.close();
    }

    root.close();

    Serial.println();
    delay(1000); // refresh every 1 second

    if (Serial.read() > 0) {
      Serial.flush();
      fileCheck();
    }
    
  }
  
}

void fileCheck() {

  file.open("graphics.h", O_RDONLY);

  size_t n;
  
    int ln = 1;
  while ((n = file.fgets(line, sizeof(line))) > 0) {
      // Print line number.
      Serial.print(line);
      if (line[n - 1] != '\n') {
        // Line is too long or last line is missing nl.
        Serial.println(F(" <-- missing nl"));
      }
  }

  file.close();
  
}



// Callback invoked when received READ10 command.
// Copy disk's data to buffer (up to bufsize) and 
// return number of copied bytes (must be multiple of block size) 
int32_t msc_read_cb (uint32_t lba, void* buffer, uint32_t bufsize)
{
  // Note: SPIFLash Block API: readBlocks/writeBlocks/syncBlocks
  // already include 4K sector caching internally. We don't need to cache it, yahhhh!!
  return flash.readBlocks(lba, (uint8_t*) buffer, bufsize/512) ? bufsize : -1;
}

// Callback invoked when received WRITE10 command.
// Process data in buffer to disk's storage and 
// return number of written bytes (must be multiple of block size)
int32_t msc_write_cb (uint32_t lba, uint8_t* buffer, uint32_t bufsize)
{
  digitalWrite(LED_BUILTIN, HIGH);

  // Note: SPIFLash Block API: readBlocks/writeBlocks/syncBlocks
  // already include 4K sector caching internally. We don't need to cache it, yahhhh!!
  return flash.writeBlocks(lba, buffer, bufsize/512) ? bufsize : -1;
}

// Callback invoked when WRITE10 command is completed (status received and accepted by host).
// used to flush any pending cache.
void msc_flush_cb (void)
{
  // sync with flash
  flash.syncBlocks();

  // clear file system's cache to force refresh
  fatfs.cacheClear();

  fs_changed = true;

  digitalWrite(LED_BUILTIN, LOW);
}
