benheck/gamebadge3/code/Sample Games/HardwareTester/apu_capture.h

const byte ddragon[] PROGMEM = {
    // Length and loop point offset
    40, 77, 18, 60,
    // Region flag: 0 = NTSC (default - change as required), 1 = PAL
    0,
    // DMC samples
    0,
    // APU frames
    0,
    0,
    0,
    62, 2, 64, 218, 122, 0, 63, 110,
    50, 2, 1, 62, 108,
    50, 1, 200, 60, 107,
    50, 1, 150, 48, 96,
    2, 1, 106,
    50, 2, 64, 63, 110,
    50, 2, 1, 62, 108,
    50, 1, 200, 60, 107,
    50, 1, 150, 59, 96,
    18, 1, 106, 57,
    18, 1, 66, 55,
    2, 1, 30,
    2, 0, 255,
    18, 0, 227, 48,
    2, 0, 202,
    50, 0, 171, 63, 110,
    50, 0, 152, 62, 108,
    50, 0, 135, 60, 107,
    50, 0, 120, 48, 96,
    2, 0, 107,
    50, 1, 177, 63, 110,
    50, 1, 129, 62, 108,
    50, 1, 87, 60, 107,
    50, 1, 49, 59, 105,
    50, 1, 16, 57, 103,
    50, 0, 242, 55, 101,
    34, 0, 215, 100,
    34, 0, 191, 98,
    50, 0, 170, 48, 96,
    50, 1, 177, 63, 110,
    50, 1, 129, 62, 108,
    50, 1, 87, 60, 107,
    50, 1, 49, 59, 105,
    50, 1, 16, 57, 103,
    50, 0, 242, 55, 101,
    34, 0, 215, 100,
    34, 0, 191, 98,
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
};
