benheck/gamebadge3/code/Sample Games/badgeris/src/music.h

const byte snd_move[] PROGMEM = {
    // Length and loop point offset
    0, 7, 0, 0,
    // Region flag: 0 = NTSC (default - change as required), 1 = PAL
    0,
    // DMC samples
    0,
    // APU frames
    9, 3, 99, 40,
    0,
    8, 0,
};

const byte snd_rotate[] PROGMEM = {
    // Length and loop point offset
    0, 23, 0, 0,
    // Region flag: 0 = NTSC (default - change as required), 1 = PAL
    0,
    // DMC samples
    0,
    // APU frames
    1, 2, 67,
    0,
    8, 32,
    0,
    0,
    0,
    0,
    8, 46,
    0,
    8, 32,
    0,
    8, 34,
    0,
    0,
    0,
    8, 0,
    };

const byte snd_clear[] PROGMEM = {
    // Length and loop point offset
    0, 187, 0, 0,
    // Region flag: 0 = NTSC (default - change as required), 1 = PAL
    0,
    // DMC samples
    0,
    // APU frames
    9, 1, 102, 44,
    1, 1, 222,
    1, 2, 127,
    1, 3, 85,
    1, 4, 117,
    9, 1, 149, 46,
    1, 2, 28,
    1, 2, 209,
    1, 3, 196,
    1, 5, 5,
    9, 1, 132, 43,
    1, 2, 5,
    1, 2, 178,
    1, 3, 156,
    1, 4, 218,
    9, 1, 116, 41,
    1, 1, 241,
    1, 2, 153,
    1, 3, 119,
    1, 4, 166,
    9, 1, 102, 38,
    1, 1, 222,
    1, 2, 127,
    1, 3, 85,
    1, 4, 117,
    9, 1, 89, 36,
    1, 1, 204,
    1, 2, 102,
    1, 3, 54,
    1, 4, 72,
    9, 1, 76, 35,
    1, 1, 187,
    1, 2, 79,
    1, 3, 25,
    1, 4, 41,
    9, 1, 65, 34,
    1, 1, 172,
    1, 2, 61,
    1, 2, 254,
    1, 4, 2,
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
};

const byte snd_clear4[] PROGMEM = {
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
    0,
    0,
    0,
    0,
    0,
    2, 1, 135,
    2, 1, 136,
    0,
    0,
    27, 1, 114, 1, 184, 32, 32,
    24, 37, 41,
    8, 40,
    24, 39, 40,
    24, 33, 33,
    0,
    0,
    0,
    0,
    0,
    0,
    0,
    0,
    0,
    0,
    0,
    2, 1, 182,
    2, 1, 184,
    0,
    0,
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
};
