benheck/gamebadge3/code/Sample Games/NESJukebox/audiodata.h

#ifndef AUDIODATA_H
#define AUDIODATA_H

#pragma once

uint16_t channel1[] = {0, 474, 474, 474, 474, 474, 474, 474, 474, 474, 474, 474, 0, 474, 474, 474, 474, 474, 474, 474, 474, 474, 474, 474, 0, 474, 474, 474, 474, 474, 474, 474, 474, 474, 474, 474, 0, 474, 474, 474, 474, 474, 0, 474, 474, 474, 474, 474, 0, 0, 0, 0, 0, 0, 0, 474, 474, 474, 474, 474, 0, 474, 474, 474, 474, 474, 0, 474, 474, 474, 474, 474, 0, 474, 474, 474, 474, 474, 474, 474, 474, 474, 474, 474, 0, 474, 474, 474, 474, 474, 474, 474, 474, 474, 474, 474, 0, 474, 474, 474, 474, 474, 474, 474, 474, 474, 474, 474, 0, 474, 474, 474, 474, 474, 474, 474, 474, 474, 474, 474, 0, 474, 474, 474, 474, 474, 0, 474, 474, 474, 474, 474, 0, 474, 474, 474, 474, 474, 0, 474, 474, 474, 474, 474, 0, 474, 474, 474, 474, 474, 0, 474, 474, 474, 474, 474, 0, 474, 474, 474, 474, 474, 0, 474, 474, 474, 474, 474, 0, 506, 506, 506, 506, 506, 506, 506, 506, 506, 506, 506, 0, 538, 538, 538, 538, 538, 538, 538, 538, 538, 538, 538, 0, 553, 553, 0, 745, 745, 0, 0, 0, 0, 745, 745, 0, 0, 0, 0, 0, 0, 0, 0, 0, 0, 0, 0, 0, 0, 0, 0, 0, 0, 0, 0, 0, 0, 0, 0, 0, 0, 0, 0, 0, 0, 0, 0, 0, 0, 0, 0, 0, 394, 394, 394, 394, 394, 0, 410, 410, 410, 410, 410, 0, 0, 0, 0, 0, 0, 0, 442, 442, 442, 442, 442, 0, 0, 0, 0, 0, 0, 0, 410, 410, 410, 410, 410, 0, 0, 0, 0, 0, 0, 0, 394, 394, 394, 394, 394, 0, 0, 0, 0, 0, 0, 0, 410, 410, 410, 410, 410, 0, 282, 282, 282, 282, 282, 282, 282, 282, 282, 282, 282, 282, 282, 282, 282, 282, 282, 282, 282, 282, 282, 282, 282, 282, 282, 282, 282, 282, 282, 282, 282, 282, 282, 282, 282,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
#endif
