benheck/gamebadge3/code/Sample Games/Grevious/grevious/LevelData.h

#ifndef LEVELDATA_H
#define LEVELDATA_H
#pragma once

#include <iostream>
#include "structs.h"

const uint8_t L01_TILES[] = {
	0,0,0,0,0,0,0,0,17,0,0,0,0,0,0,0,0,0,0,0,0,0,0,0,0,0,0,0,0,0,0,0,0,0,0,0,0,0,0,0,0,0,0,0,0,0,0,0,0,0,0,17,0,0,0,0,19,0,0,0,0,0,0,0,0,0,0,0,0,0,0,0,0,0,0,0,0,0,0,0,0,18,0,0,0,0,0,0,0,0,0,19,0,0,18,0,0,0,14,14,0,0,19,0,0,0,1,2,3,2,0,0,0,0,2,3,0,0,0,5,0,0,0,0,2,3,0,0,0,0,2,3,0,0,6,7,6,0,0,0,7,0,0,0,4,0,0,0,3,0,0,7,0,0,0,0,0,0,0,7,0,5,0,0,2,3,0,0,6,7,0,0,0,0,3,3,0,0,0,0,0,7,0,0,0,0,0,2,0,0,0,2,2,7,3,5,3,0,0,0,6,3,0,0,6,5,0,0,0,2,2,0,0,5,0,0,0,0,0,0,0,0,0,0,2,3,0,0,0,0,0,3,0,0,0,0,0,0,0,0,0,0,0,0,0,0,0,0,0,0,
	0,0,0,0,0,0,0,0,0,0,0,0,0,0,0,0,0,0,0,0,0,0,0,0,0,0,0,0,0,0,0,0,0,0,0,0,0,0,0,0,0,0,0,0,0,17,0,0,0,0,0,0,0,0,0,0,0,0,0,0,0,0,0,0,0,0,0,0,0,0,0,0,0,0,0,0,0,0,17,0,0,0,0,0,0,0,0,0,0,0,0,0,0,0,0,0,0,0,14,14,0,0,0,0,0,0,0,0,0,0,1,2,3,4,0,0,1,2,0,0,2,3,2,4,0,0,1,2,3,4,0,0,1,0,0,7,0,0,2,0,0,5,0,4,0,1,0,5,0,1,0,0,4,2,1,0,5,7,0,0,0,0,0,4,0,0,1,0,0,0,0,0,3,4,0,0,1,0,0,2,0,0,0,2,2,0,4,0,1,3,2,0,0,6,0,4,0,2,0,3,3,0,2,0,0,0,0,3,2,0,0,6,0,5,0,0,0,0,3,5,3,0,0,0,0,0,0,2,0,2,5,0,0,0,0,0,0,19,0,0,17,0,0,17,0,0,0,0,18,0,
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
{ ASTEROID, 1198, 82, 3, 100, 0, 0, ALIVE, STRAIGHT }, 
{ ASTEROID, 1201, 53, 3, 100, 0, 0, ALIVE, STRAIGHT }, 
{ ASTEROID, 1232, 37, 3, 100, 0, 0, ALIVE, STRAIGHT }, 
{ ASTEROID, 1235, 78, 3, 100, 0, 0, ALIVE, STRAIGHT }, 
};





#define L01_MOBS_NUM sizeof(L01_MOBS) / sizeof(*L01_MOBS)

#endif
