benheck/gamebadge3/code/Sample Games/Grevious/grevious/GameLibrary.h

#ifndef GAMELIBRARY_H
#define GAMELIBRARY_H
#pragma once

// point struct used to define location
struct POINT
{
    int x;
    int y;
};

struct RECT
{
    int left;
    int top;
    int right;
    int bottom;
};

#endif
