benheck/gamebadge3/(commit log)

2023-01-07 Fix for the scroll glitch I hope
    [Gamebadge3.ino, gameBadgePico.cpp, gameBadgePico.h]
2023-01-07 Added Grevious as a sample game
2023-01-07 Added work wrap and button debounce
2023-01-09 Fixed issue with custom palette not being used
    [gameBadgePico.cpp]
2023-01-09 Added individual tile palettes, and removed button debouncing code (now done in game library)
2023-01-10 Adding sprite flipping, fixed sprite transparency glitch
    [Gamebadge3.ino, gameBadgePico.cpp, gameBadgePico.h]
2023-01-22 Create case rear.stl
    [case rear.stl]
2023-01-22 Update case rear.stl
    [case rear.stl]
2023-02-04 Added screen bracket and peg
    [Screen Bracket.stl, Screen Peg.stl]
2023-02-14 Added PCBs
    [Gamebadge3_revB.brd, Gamebadge3_revB.sch]
2023-02-15 Arranged folders and changed case STL
    [D-pad base.stl, D-pad interface.stl, D-pad top.stl, case rear.stl]
2023-03-06 Added waveform generator and sample app - NES Jukebox
2023-03-07 Fixed a volume leveling bug
    [FamiPlayer.cpp, FamiPlayer.h]
2023-03-08 Bud damage and robot collision
    [Gamebadge3.ino, gameObject.cpp]
2023-03-22 Bud game. Also added stopMusic in gamebadge library
    [condo2-1_pal0.csv, condo2-1_pal1.csv, condo2-1_pal2.csv, condo2-1_pal3.csv, condo2-1_platform.csv, condo2-2_pal0.csv, condo2-2_pal1.csv, condo2-2_pal2.csv]
2023-03-24 Fixed a couple of bugs
2023-03-26 Changes to PWM and GBAdudio
2023-03-27 Fixing critical bugs 4 days before release
    [back.dxf, front.dxf]
2023-03-30 More tweaks and bug fixes
    [Catskill.ino, gameObject.cpp, music.h]
2023-04-04 Added OSHpark Gerber files
    [Gamebadge3_revB.brd, Gamebadge3_revB.sch]
2023-04-05 Updated screen bracket
    [Screen Bracket.stl, Screen Kit v1.stl, Screen Peg.stl]
2023-04-05 Added button covers
    [Button Mount Post x3.stl, Buttons.stl]
2023-07-17 Removed DMA GPIO flags and moved folders around
    [condo2-1_pal0.csv, condo2-1_pal1.csv, condo2-1_pal2.csv, condo2-1_pal3.csv, condo2-1_platform.csv, condo2-2_pal0.csv, condo2-2_pal1.csv, condo2-2_pal2.csv]
2023-08-07 New case and organzing
    [Back PCB.dxf, Front PCB.dxf, Gamebadge3_revB.dxf, Gamebadge3_revB2.dxf, Rear Case.stl]
2023-08-11 New case
    [Buttons.stl, D-pad.stl, Front Case.stl, Prog button.stl, RST button.stl, Select.stl]
2023-08-11 Update Front Case.stl
    [Front Case.stl]
2023-12-25 Updated design 2024 for SD card
    [Back PCB.dxf, Front PCB.dxf, Gamebadge3_revB.brd, Gamebadge3_revB.dxf, Gamebadge3_revB.sch, Gamebadge3_revB2.dxf, Gamebadge3_revC.brd, Gamebadge3_revC.sch]
2023-12-30 Added support for updated 2024 version of the board
2024-01-19 Updated PCB version 3B
    [copper_bottom.gbr, copper_top.gbr, drills.xln, gerber_job.gbrjob, profile.gbr, silkscreen_bottom.gbr, silkscreen_top.gbr, soldermask_bottom.gbr]
2024-01-19 Added missing prototype functions
    [gameBadgePico.h]
2024-02-07 Update gameBadgePico.cpp
    avoid DMA collision with new LCD commands
    [gameBadgePico.cpp]
2024-02-28 Added new case
    [Button Mount Post x3.stl, Buttons.stl, Case Rear.stl, D-pad 2.stl, D-pad base.stl, D-pad interface.stl, D-pad top.stl, D-pad.stl]
2024-03-26 Updated NESJukebox, precompiled catskill, added a couple emulators, and program loader
2024-03-29 Added alternate rear case
    [Rear Case - Alternate.stl]
2024-04-05 Added assembly doc
    [Gamebadge3_revC rear.dxf, Gamebadge3_revC.dxf]
2025-11-01 Added support for ST7789V3. Cat game has 3 gamebadge selects at start of code. Changes to gamebadge and pico ST7789 libs. Still compatible with older Gamebadges. I hope!
2025-11-07 Added save folder to base file system
    [Back PCB.dxf, Front PCB.dxf, Gamebadge3_revD.brd, Gamebadge3_revD.sch, MGC Game Badge 2024 - parts list.xlsx, back.dxf, benheck_gamebadge3_populate_list.xlsx, front.dxf]
2025-12-30 Updated case for 2026 design (ST7789rev3 LCD)
    [ABC buttons Rev 3.stl, Back PCB.dxf, D-pad Rev 3.stl, D-pad plug.stl, Front Case Rev 3.stl, Front PCB.dxf, GB 3C ST7789V3 export.dxf, Gamebadge3_revC.dxf]
2026-02-01 Updated PCB for production
2026-02-15 Changed case for clips
    [Front Case Rev 3.stl, Rear Case Rev 3.stl]
2026-03-24 Added Screen Bracket for 2026 workshop
    [GameBadge 3C Screen Bracket.stl]
2026-04-07 NES Emulator updates - swapped buttons, and supports 1024 ROMs in file browser
2026-04-11 Added bootloader and updated a couple emulators
